elenachenchen/A4000-ATX/ATX4000-BOM.ods

Schematic Part Nr | Type | Parameters |  |  | Manufacturer | Modellnr |  |  | +
R400, R403-R404, R465 | Resistor | 1 | 2512 |  | Vishay Dale | CRCW25121R00JNEG
R176-R177 | Resistor | 20 | 2512 |  | Vishay Dale | CRCW251220R0JNEG
R104, R211, R231-237, R240-R248, R881-899 | Resistor | 33 | 0805 | 5,00 % | Vishay Dale | CRCW080533R0JNEA
R101, R102-R103, R105-R106 R111-R112, R161-R162, R165-R170, R212-R218, R222, R223, R451, R455A-R55H, R456A-R456H, R457A-R457H, R458, R458A, R458B R463-R464, R500-R508, R513, R660-R661, R701-R704, ER175-ER176, ER300-ER307, ER458-ER460 | Resistor | 47 | 0805 | 5,00 % | Vishay Dale | CRCW080547R0JNEA
R520-R543 | Resistor | 68 | 0805 | 5,00 % | Vishay Dale | CRCW080568R0JNEA
R510-512 | Resistor | 75 | 0805 | 5,00 % | Vishay Dale | CRCW080575R0JNEA
R311 | Resistor | 120 | 0805 | 5,00 % | Vishay Dale | CRCW0805120RJNEA
R301, R307 | Resistor | 220 | 0805 | 5,00 % | Vishay Dale | CRCW0805220RJNEA
R120-R122, R175, R178, R601, R603, R651 | Resistor | 470 | 0805 | 5,00 % | Vishay Dale | CRCW0805470RFKEAC
R509 | Resistor | 562 | 0805 | 1,00 % | Vishay Dale | CRCW0805562RFKEA
R65-66 | Resistor | 680 | 0805 | 5,00 % | Vishay Dale | CRCW0805680RJNEA
R430, R440 | Resistor | 750 | 0805 | 5,00 % | Vishay Dale | CRCW0805750RJNEA
R1-R2, R67-R68, R70-R73, R125-R128, R171-R173, R181, R182, R239, R249, R382, R401-R402, R433, R434, R443, R444, R545-R548, R600, R602, R605-R610, R612-R626, R631-R635, R639, R708-R712, R720-R722, R861-R862, R911-R912, R975 | Resistor | 1k | 0805 | 5,00 % | Vishay Dale | CRCW08051K00JNEAC
R79-88 | Resistor | 1.2k | 0805 | 5,00 % | Vishay Dale | CRCW08051K20JNEA
R403D, R403H | Resistor | 2.4k | 0805 | 5,00 % | Panasonic | ERJ-6GEYJ242V
R1-R64, R179, R407, R652, R871, R904-R905 | Resistor | 2.7k | 0805 | 5,00 % | Panasonic | ERJ-6GEYJ272V
R151, R355-R361 | Resistor | 3.3k | 0805 | 5,00 % | Vishay Dale | CRCW08053K30JNEA
R403C, R403G, R515, R981-R994 | Resistor | 4.7k | 0805 | 5,00 % | Vishay Dale | CRCW08054K70FKEAC
R305-306, R403A, R403B, R403E, R403F, R406, R408, R431, R432, R441, R442, R514, R456-R457 | Resistor | 10k | 0805 | 5,00 % | Vishay Dale | CRCW080510K0JNEAC
R902-R903 | Resistor | 11k | 0805 | 5,00 % | Vishay Dale | CRCW080511K0JNEA
R4 | Resistor | 18k | 0805 | 5,00 % | Vishay Dale | CRCW080518K0JNEA
R3 | Resistor | 39k | 0805 | 5,00 % | Vishay Dale | CRCW080539K0JNEA
R180 | Resistor | 100k | 0805 | 5,00 % | Vishay Dale | CRCW0805100KJNEAC
R435, R445 | Resistor | 470k | 0805 | 5,00 % | Vishay Dale | CRCW0805470KJNEA
RP176 | Resistor Network | 10k | x7 | 2,00 % | Bourns Inc. | 4608X-AP1-103LF
RP351, RP752-RP756 | Resistor Network | 1k | x9 | 2,00 % | Bourns Inc. | 4610X-101-102LF
RP461-RP463 | Resistor Network | 1k | x8 | 5,00 % | Bourns Inc. | 4609X-101-102LF
RP602-RP608 | Dual Terminated Resistor Network | 220/330 | x8 | 2,00 % | Bourns Inc. | 4610X-104-221/331L
RP751 | Resistor Network | 4,7k | x9 | 2,00 % | Bourns Inc. | 4610X-101-472LF
C179 | Ceramic Cap | 50V | 22pF | NPO | Vishay Vitramon | VJ0805A220GXACW1BC
C178 | Ceramic Cap | 50V | 56pF | NPO | Yageo | CC0805FRNPO9BN560
EC183-EC185, EC300-EC307, EC410, EC411, EC451-EC452 EC458-EC460, EC971-EC989 | Ceramic Cap | 25V | 100pF | NPO | Vishay Vitramon | VJ0805A101JXACW1BC
C446, C447 | Ceramic Cap | 25V | 330pF | NPO | AVX Corporation | 08053A331JAT2A
C756-C799 | Ceramic Cap | 25V | 1000pF | X7R | Samsung Electro-Mechanics | CL21B102KBANFNC
C432, C442 | Ceramic Cap | 50V | 3900pF | X7R | Samsung Electro-Mechanics | CL21B392KBANNNC
C431, C441 | Ceramic Cap | 50V | 6800pF | X7R | Samsung Electro-Mechanics | CL21B682KBANNNC
C104, C154B, C186, C193, C195, C409, C460D, C460E, C460F | Ceramic Cap | 25V | 0.01uF | X7R | Samsung Electro-Mechanics | CL21B103KAANNNC
C411-414, C430, C440 | Ceramic Cap | 50V | 0.047uF | X7R | AVX Corporation | 0805YC473KAT2A
C1, C2-C3, C102, C103, C106, C130, C140, C141, C145, C152, C154A, C177, C201, C215, C211A, C211B, C211C, C212, C213, C216, C250A, C250C, C300, C305, C311, C350-C355, C400B, C402A-C402B, C455-C459, C455B-C458B, C460A, C460B, C460C, C485, C500, C511, C605-C607, C890-C894, C901-C904, C907, C975-C976, C990, C999 | Ceramic Cap | 25V | 0.1uF | X7R | Samsung Electro-Mechanics | CL21B104KACNNNC
C150, C175-C176, C199, C403, C405-C406 C450, C700-704, C706-C708, C710-C711, C714 | Ceramic Cap | 16V | 0.22uF | X7R | Samsung Electro-Mechanics | CL21B224KOCNNNC
C4 | Ceramic Cap | 25V | 1uF | X7R | Samsung Electro-Mechanics | CL21B105KAFNNNE
C200, C404 | Electrolytic Cap | 25V | 4.7uF | 20,00 % | Nichicon | UWX1E4R7MCL1GB
C560G | Electrolytic Cap | 10V | 10uF | 20,00 % | Nichicon | UWP1A100MCL1GB
C198, C433, C443, C750-C755 | Electrolytic Cap | 16V | 22uF | 20,00 % | Nichicon | UWJ1C220MCL1GB
C187-192, C194, C196 | Electrolytic Cap | 16V | 47uF | 20,00 % | Nichicon | UWJ1C470MCL1GB
C181, C460H | Electrolytic Cap | 10V | 100uF | 20,00 % | Nichicon | UWR1A101MCL1GB
C600-C604 | Electrolytic Cap | 16V | 220uF | 20,00 % | Nichicon | UUR1C221MCL6GS
C185, C400A | Electrolytic Cap | 16V | 470uF | 20,00 % | Nichicon | UUD1C471MNL1GS
VC190 | Trimmer Cap | 50V | 7-50pF |  | Murata Electronics North America | TZB4R500BB10R00
BT176 | Battery Holder | Type | CR2032 |  | MPD (Memory Protection Devices) | BS-7
D175-176, D305-D307, D360-D363, D500-D505 | Diode |  |  |  | Comchip Technology | CGRKM4001-HF
D1-D2, D177-178, D300, D999 | Diode | 100V |  |  | ON Semiconductor | 1N4148WS
D507 | Reference Diode | 1,235V |  |  | Texas Instruments | LM385BDR-1-2
FB177, FB401, FB462, FB975 | Ferrite | 50 Ohm@100Mhz | 1206 | 5A | Vishay Dale | ILHB1206ER500V
FB410, FB411, FB601, FB710, ER971-ER989 | Ferrite | 600 Ohm@ 100MHz | 0805 | 200mA | Vishay Dale | ILBB0805ER601V
U1 | PIC16F628 |  |  |  | Microchip Technology | PIC16F628A-I/P | needs to be programmed!
U2 | Schmitt Inverter | 74HCT1G14 |  |  | Nexperia | 74HCT1G14GW,125
U3 | JK Flip Flop | 74LS73 |  |  | Texas Instruments | SN74LS73ADE4
U102 | Delay Line |  |  |  | Maxim Integrated | DS1100Z-25+
U103 | Buffer | 74FCT244T |  |  | Texas Instruments | CY74FCT244TSOCT
U104 | Oscillator DIP-14 |  |  |  | Abracon LLC | ACO-50.000MHZ-EK
U106, U459 | Flip Flop | 74F74 |  |  | Texas Instruments | SN74F74DR
U130, U710 | AND Gate | 74F08 |  |  | Texas Instruments | SN74F08DR
U140 | OR Gate | 74F32 |  |  | Texas Instruments | SN74F32D
U141 | Buffer | 7407 |  |  | Texas Instruments | SN7407DR
U145 | Comparator 8bit | 74F521NSR |  |  | Texas Instruments | SN74F521DWR
U150 | Fat Gary |  |  |  | Amiga | Fat Gary Custom Chip
U152, U860 | PAL | TIBPAL | 16R4-10 |  | Texas Instruments | TIBPAL16R4-10CFN | needs to be programmed! | only for 68020
U154 | Oscillator DIP-14 | 28.375160Mhz
U175 | A400D Rom Low
U176 | A400D Rom High
U177 | Positive Trigger | 74HCT174 |  |  | Texas Instruments | CD74HCT174M96
U178 | Real Time Clock | RP5C01
U198 | Linear Regulator | 7905 | SMD |  | STMicroelectronics | L7905CD2T-TR
U211 | Alice |  |  |  | Amiga | Alice Custom Chip
U212 | GAL | 22V10-10 |  |  | Microchip Technology | ATF22V10C-10JU | needs to be programmed!
U213 | PAL | 16L8-10 |  |  | Texas Instruments | TIBPAL16L8-10CFN | needs to be programmed!
U215 | Inverter | 74F04 |  |  | Texas Instruments | SN74F04DR
U216 | Latch | 74FCT841 |  |  | Texas Instruments | CY74FCT841CTQCT
U250 | Bridgette |  |  |  | Amiga | Bridgette Custom Chip
U261 | Memory Socket | 72pin |  |  | TE Connectivity AMP Connectors | 5822021-4
U300 | CIA |  |  |  | Amiga | CIA Custom Chip
U304 | Quad Line Driver | RS232 |  |  | Maxim Integrated | MAX1488ECSD+
U305 | Quad Line Receiver | RS232 |  |  | Maxim Integrated | MAX1489ECSD+
U311 | Buffer | 7407 |  |  | Texas Instruments | SN7407DR
U350 | CIA |  |  |  | Amiga | CIA Custom Chip
U351 | Flip Flop | 74LS74A |  |  | Texas Instruments | SN74LS74ADR
U352 | NAND Gate | 74LS38 |  |  | Texas Instruments | SN74LS38DR
U353 | Buffer | 74LS125A |  |  | Texas Instruments | SN74LS125ADR
U354, U174 | Flip Flop | 74HCT174 |  |  | Nexperia | 74HCT174D,652
U355 | Buffer | 74LS125A |  |  | Texas Instruments | SN74LS125ADR
U400 | Paula |  |  |  | Amiga | Paula Custom Chip
U402 | Quad OP-Amp | LF347 |  |  | Texas Instruments | LF347DR
U403 | Audio OP-Amp | LM833 |  |  | STMicroelectronics | LM833DT
U450 | Lisa |  |  |  | Amiga | Lisa Custom Chip
U457 | Transceiver | 74FCT245 |  |  | Texas Instruments | CY74FCT245ATQCT
U460 | Video DAC | ADV7120 |  |  | Analog Devices | ADV7120KPZ30
U600, U602 | Quad OR Gate | 74HCT32 |  |  | Texas Instruments | SN74HCT32DR
U601 | Buffer | 7407 |  |  | Texas Instruments | SN7407DE4
U700 | Fat Buster |  |  |  | Amiga | Fat Buster Custom Chip
U701 | PAL | 16R4-15 |  |  | Texas Instruments | TIBPAL16R4-15CFN | needs to be programmed!
U702, U703, U706 | Transceiver | 74FCT646T |  |  | Texas Instruments | CY74FCT646TSOCT
U704, U707, U708, U891-U894 | Transceiver | 74F245 |  |  | Texas Instruments | SN74F245DW
U711 | Quad XOR | 74F86 |  |  | Texas Instruments | SN74F86D
U714 | PAL | PAL16L8D |  |  | Texas Instruments | TIBPAL16L8-15CFN | needs to be programmed!
U850-U853 | Memory Socket | 72pin |  |  | TE Connectivity AMP Connectors | 5822021-4
U890 | RAMSEY |  |  |  | Amiga | RAMSEY Custom Chip
U901 | PAL | 16L8-15 |  |  | Texas Instruments | TIBPAL16L8-15CFN | needs to be programmed!
U902 | PAL | 16R6-15 |  |  | Texas Instruments | TIBPAL16R6-15CFN | needs to be programmed!
U903, U904 | Transceiver | 74HCT245 |  |  | Nexperia | 74HCT245PW,118
U975, U976 | Shift Register | 74LS166 |  |  | Texas Instruments | SN74LS166ADR
U998 | Quad Multiplexer | 74LS157 |  |  | Texas Instruments | SN74LS157DR
U999 | Quad NAND | 74LS00 |  |  | Texas Instruments | SN74LS00DR
Q300 | 2N3904 |  |  |  | ON Semiconductor | PZT3904 | SMD Variant
Q400 | 2N3906 |  |  |  | ON Semiconductor | PZT3906 | SMD Variant
Q430, Q440 | J113 |  | TO-92 |  | ON Semiconductor | J113
Y176 | Crystal for RTC | 32768Hz |  |  | ECS Inc. | ECS-.327-CDX-1074
JP1 | .1“ (2,54mm) Headers, Single Row |  |  |  | can be bought in bulk and cut in length!!!
JP2 | .1“ (2,54mm) Headers, Single Row
JP3 | .1“ (2,54mm) Headers, Single Row
JP4 | .1“ (2,54mm) Headers, Single Row
JP151 | .1“ (2,54mm) Headers, Single Row
J212 | .1“ (2,54mm) Headers, Single Row
J850 | .1“ (2,54mm) Headers, Single Row
J852 | .1“ (2,54mm) Headers, Single Row
J975 | .1“ (2,54mm) Headers, Dual Row
CN160 | ATX Connector | 24PIN |  |  | TE Connectivity AMP Connectors | 2-1586037-4
CN175 | PS/2 Connector | 6pin |  |  | CUI Inc | MD-60SMK
CN351 | Floppy Connector | 34pin |  |  | .1“ (2,54) 2 Row Header (2x17pin)
CN402 | RCA Left |  |  |  | CUI Inc | RCJ-013
CN403 | RCA Right |  |  |  | CUI Inc | RCJ-012
CN450 | RGB out and serial | 15+9pin |  |  | TE Connectivity AMP Connectors | 1-1775210-1
CN600-CN604 | Zorro Slots | 100pin |  |  | TE Connectivity AMP Connectors | 2-5530843-2
CN621, CN623, CN756-CN760 | Video Slot + ISA Extension | 36pin |  |  | TE Connectivity AMP Connectors | 5530843-3
CN622, CN624 | Video Slot | 56pin |  |  | TE Connectivity AMP Connectors | 5530843-6 | 54 Pin Connectors not available!
CN751-CN755 | ISA 8bit | 62pin |  |  | TE Connectivity AMP Connectors | 7-5530843-0
CN900 | IDE Connector | 40pin |  |  | Wurth Electronics Inc. | 61203921621
CN975 | Mouse + Joystick | 9+9pin |  |  | Conec | DLS1PP5AN23X
CN976 | Port 2 | 9pin |  |  | Conec | DLS1XP5AK40X
L500 | Inductor | 47uH |  |  | Vishay Dale | ISC1210ER470K
F175 | Resettable Fuse | 1.9A |  |  | Bourns Inc. | MF-NSML190-2
++++
