elenachenchen/A4000-ATX/ATX4000.kicad_pcb

## KiCad design ATX4000.kicad_pcb (2021-06-26)

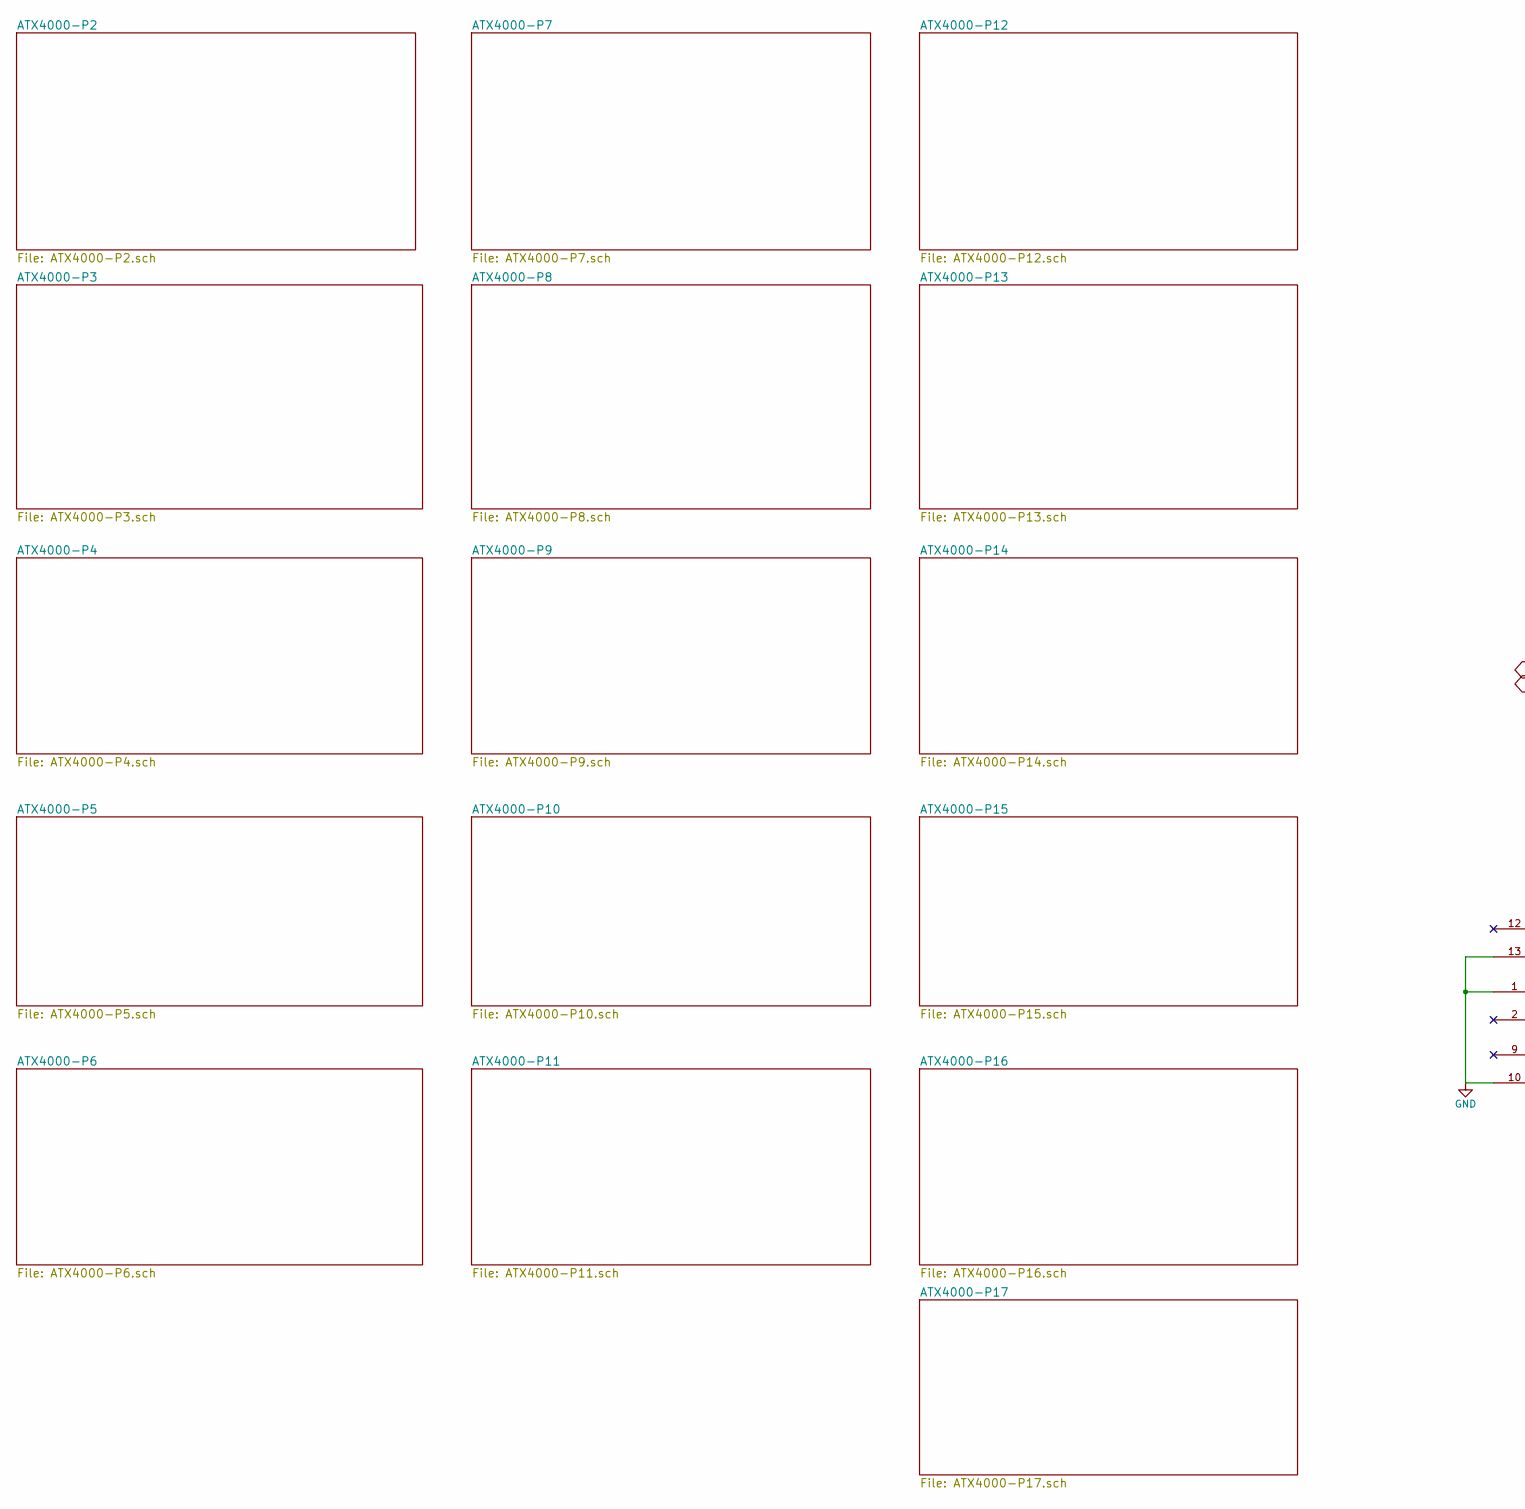
[picture p1: schematic ATX4000.sch, part in row 1, column 1]

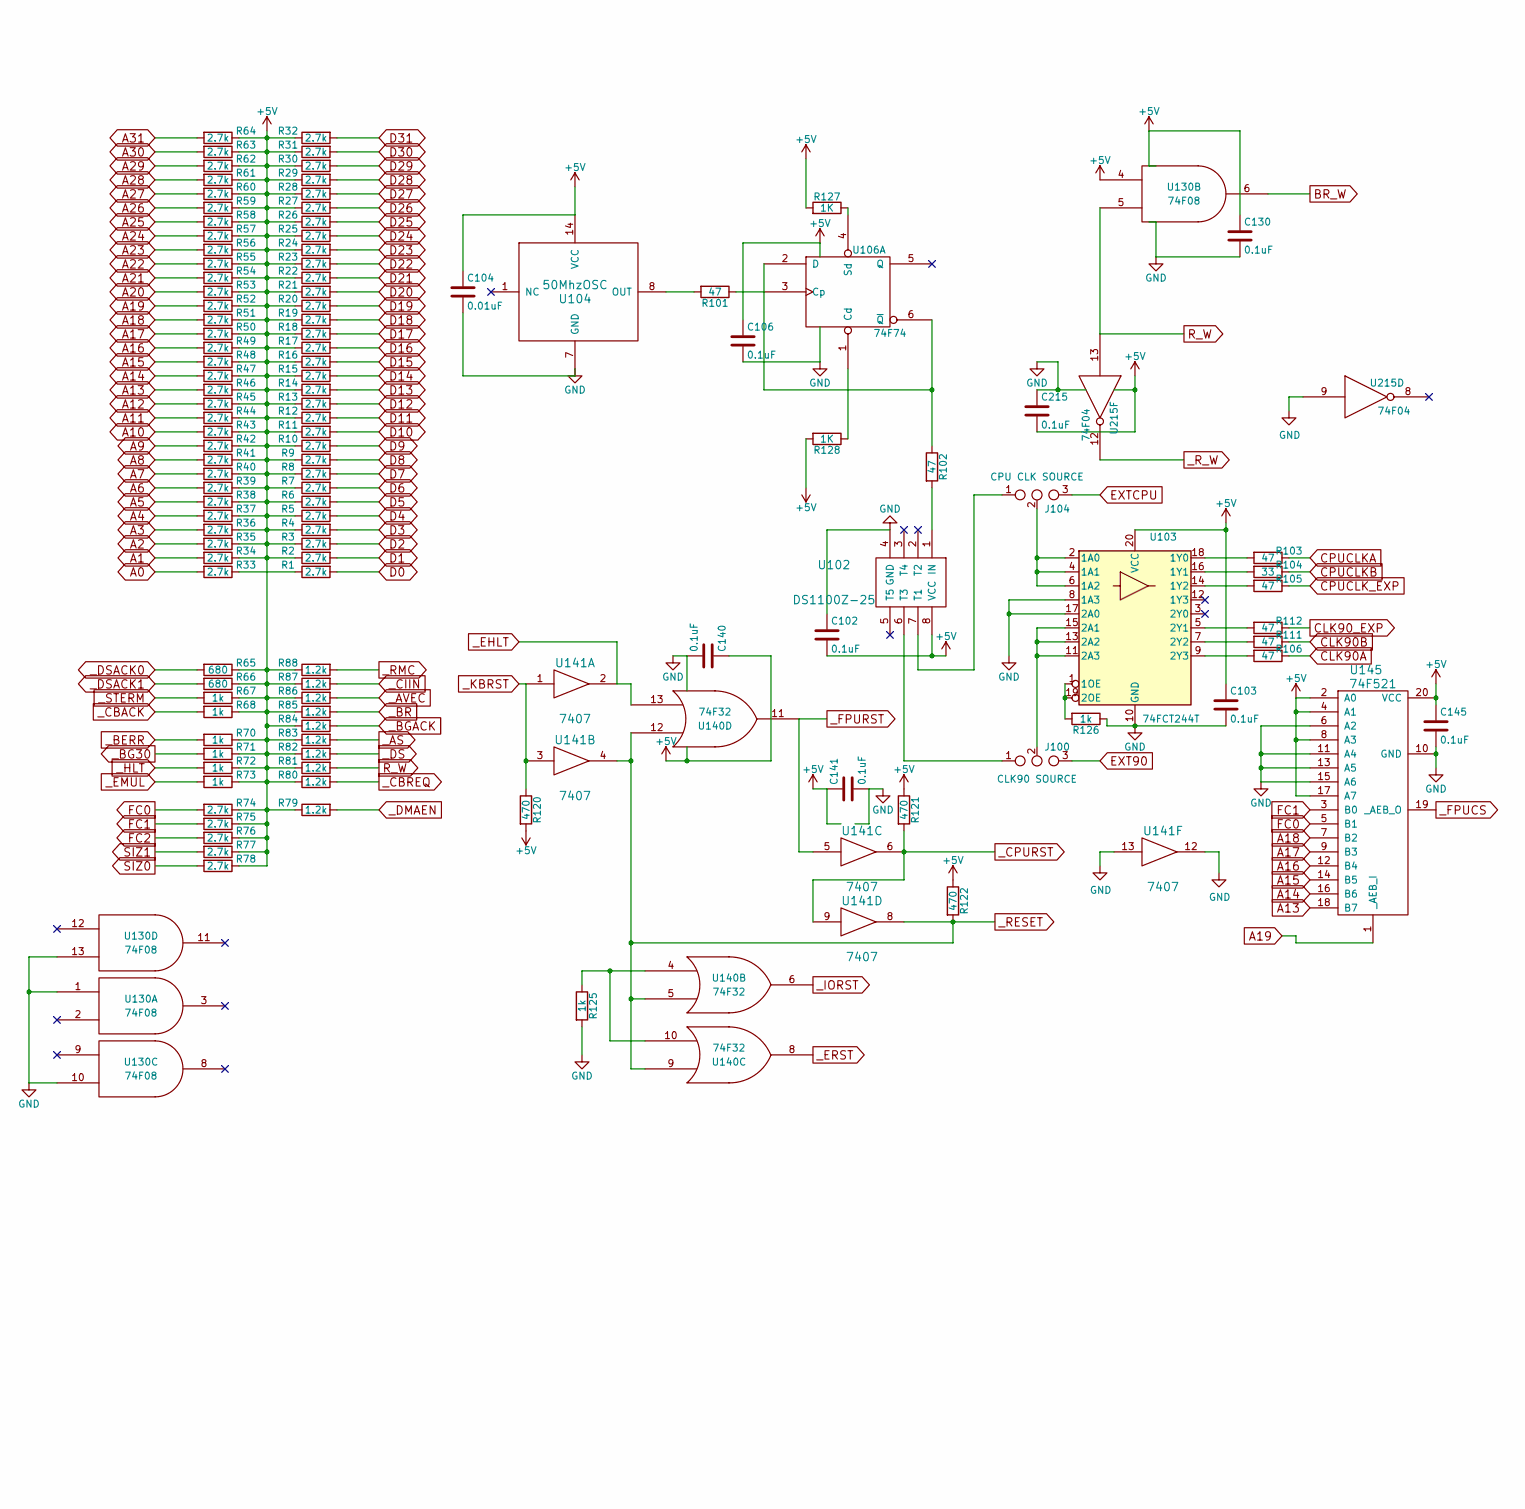
[picture p2: schematic ATX4000.sch, part in row 1, column 2]

Parts:
C102, C103, C106, C130, C140, C141, C145, C215: 0.1uF; C_0805_HandSoldering
C104: 0.01uF; C_0805_HandSoldering
J100: CLK90 SOURCE; Pin_Header_Straight_1x03_Pitch2.54mm
J104: CPU CLK SOURCE; Pin_Header_Straight_1x03_Pitch2.54mm
R1, R2, R3, R4, R5, R6, R7, R8, R9, R10, R11, R12, R13, R14, R15, R16, R17, R18, R19, R20, R21, R22, R23, R24, R25, R26, R27, R28, R29, R30, R31, R32, R33, R34, R35, R36, R37, R38, R39, R40, R41, R42, R43, R44, R45, R46, R47, R48, R49, R50, R51, R52, R53, R54, R55, R56, R57, R58, R59, R60, R61, R62, R63, R64: 2.7k; R_0805_HandSoldering
R65, R66: 680; R_0805_HandSoldering
R67, R68, R70, R71, R72, R73, R125, R126: 1k; R_0805_HandSoldering
R74, R75, R76, R77, R78: 2.7k; R_1206_HandSoldering
R79, R80, R81, R82, R83, R84, R85, R86, R87, R88: 1.2k; R_0805_HandSoldering
R101, R102, R103, R105, R106, R111, R112: 47; R_0805_HandSoldering
R104: 33; R_0805_HandSoldering
R120, R121, R122: 470; R_0805_HandSoldering
R127, R128: 1K; R_0805_HandSoldering
U102: DS1100Z-25; SOIC-8_3.9x4.9mm_Pitch1.27mm
U103: 74FCT244T; SO-20_12.8x7.5mm_Pitch1.27mm
U104: 50MhzOSC; Oscillator_DIP-14
U106: 74F74; SOIC-14_3.9x8.7mm_Pitch1.27mm
U130: 74F08; SOIC-14_3.9x8.7mm_Pitch1.27mm
U140: 74F32; SOIC-14_3.9x8.7mm_Pitch1.27mm
U141: 7407; SOIC-14_3.9x8.7mm_Pitch1.27mm
U145: 74F521; SOIC-20W_7.5x12.8mm_Pitch1.27mm
U215: 74F04

Connections:
+5V: C102.2, C103.1, C104.1, C106.1, C130.1, C140.1, C141.1, C145.1, C215.2, R2.1, R3.1, R4.1, R5.1, R6.1, R7.1, R8.1, R9.1, R10.1, R11.1, R12.1, R13.1, R14.1, R15.1, R16.1, R17.1, R18.1, R19.1, R20.1, R21.1, R22.1, R23.1, R24.1, R25.1, R26.1, R27.1, R28.1, R29.1, R30.1, R31.1, R32.1, R34.1, R35.1, R36.1, R37.1, R38.1, R39.1, R40.1, R41.1, R42.1, R43.1, R44.1, R45.1, R46.1, R47.1, R48.1, R49.1, R50.1, R51.1, R52.1, R53.1, R54.1, R55.1, R56.1, R57.1, R58.1, R59.1, R60.1, R61.1, R62.1, R63.1, R64.1, R65.1, R66.1, R67.1, R68.1, R70.1, R71.1, R72.1, R73.1, R74.1, R75.1, R76.1, R77.1, R78.1, R79.1, R80.1, R81.1, R82.1, R83.1, R84.1, R85.1, R86.1, R87.1, R88.1, R120.2, R121.1, R122.1, R127.2, R128.2, U102.8 (VCC), U103.20 (VCC), U104.14 (VCC), U106.14 (VCC), U130.4, U130.14 (VCC), U140.14 (VCC), U141.14 (VCC), U145.2 (A0), U145.4 (A1), U145.8 (A3), U145.17 (A7), U145.20 (VCC), U215.14 (VCC); also elsewhere on the board
A0: R33.2; also elsewhere on the board
A1: R34.2; also elsewhere on the board
A2: R35.2; also elsewhere on the board
A3: R36.2; also elsewhere on the board
A4: R37.2; also elsewhere on the board
A5: R38.2; also elsewhere on the board
A6: R39.2; also elsewhere on the board
A7: R40.2; also elsewhere on the board
A8: R41.2; also elsewhere on the board
A9: R42.2; also elsewhere on the board
A10: R43.2; also elsewhere on the board
A11: R44.2; also elsewhere on the board
A12: R45.2; also elsewhere on the board
A13: R46.2, U145.18 (B7); also elsewhere on the board
A14: R47.2, U145.16 (B6); also elsewhere on the board
A15: R48.2, U145.14 (B5); also elsewhere on the board
A16: R49.2, U145.12 (B4); also elsewhere on the board
A17: R50.2, U145.9 (B3); also elsewhere on the board
A18: R51.2, U145.7 (B2); also elsewhere on the board
A19: R52.2, U145.1 (_AEB_I); also elsewhere on the board
A20: R53.2; also elsewhere on the board
A21: R54.2; also elsewhere on the board
A22: R55.2; also elsewhere on the board
A23: R56.2; also elsewhere on the board
A24: R57.2; also elsewhere on the board
A25: R58.2; also elsewhere on the board
A26: R59.2; also elsewhere on the board
A27: R60.2; also elsewhere on the board
A28: R61.2; also elsewhere on the board
A29: R62.2; also elsewhere on the board
A30: R63.2; also elsewhere on the board
A31: R64.2; also elsewhere on the board
BR_W: U130.6; also elsewhere on the board
CLK90A: R106.1; also elsewhere on the board
CLK90B: R111.1; also elsewhere on the board
CLK90_EXP: R112.1; also elsewhere on the board
CPUCLKA: R103.1; also elsewhere on the board
CPUCLKB: R104.1; also elsewhere on the board
CPUCLK_EXP: R105.1; also elsewhere on the board
D0: R1.2; also elsewhere on the board
D1: R2.2; also elsewhere on the board
D2: R3.2; also elsewhere on the board
D3: R4.2; also elsewhere on the board
D4: R5.2; also elsewhere on the board
D5: R6.2; also elsewhere on the board
D6: R7.2; also elsewhere on the board
D7: R8.2; also elsewhere on the board
D8: R9.2; also elsewhere on the board
D9: R10.2; also elsewhere on the board
D10: R11.2; also elsewhere on the board
D11: R12.2; also elsewhere on the board
D12: R13.2; also elsewhere on the board
D13: R14.2; also elsewhere on the board
D14: R15.2; also elsewhere on the board
D15: R16.2; also elsewhere on the board
D16: R17.2; also elsewhere on the board
D17: R18.2; also elsewhere on the board
D18: R19.2; also elsewhere on the board
D19: R20.2; also elsewhere on the board
D20: R21.2; also elsewhere on the board
D21: R22.2; also elsewhere on the board
D22: R23.2; also elsewhere on the board
D23: R24.2; also elsewhere on the board
D24: R25.2; also elsewhere on the board
D25: R26.2; also elsewhere on the board
D26: R27.2; also elsewhere on the board
D27: R28.2; also elsewhere on the board
D28: R29.2; also elsewhere on the board
D29: R30.2; also elsewhere on the board
D30: R31.2; also elsewhere on the board
D31: R32.2; also elsewhere on the board
EXT90: J100.3; also elsewhere on the board
EXTCPU: J104.3; also elsewhere on the board
FC0: R74.2, U145.5 (B1); also elsewhere on the board
FC1: R75.2, U145.3 (B0); also elsewhere on the board
FC2: R76.2; also elsewhere on the board
GND: C102.1, C103.2, C104.2, C106.2, C130.2, C140.2, C141.2, C145.2, C215.1, R125.2, R126.1, U102.4 (GND), U103.8 (1A3), U103.10 (GND), U103.17 (2A0), U104.7 (GND), U106.7 (GND), U130.1, U130.7 (GND), U130.10, U130.13, U140.7 (GND), U141.7 (GND), U141.12, U141.13, U145.6 (A2), U145.10 (GND), U145.11 (A4), U145.13 (A5), U145.15 (A6), U215.7 (GND), U215.9; also elsewhere on the board
unnamed: J100.1, U102.6 (T3)
unnamed: J100.2, U103.11 (2A3), U103.13 (2A2), U103.15 (2A1)
unnamed: J104.1, U102.7 (T1)
unnamed: J104.2, U103.2 (1A0), U103.4 (1A1), U103.6 (1A2)
unnamed: R1.1, R33.1
unnamed: R101.1, U106.3 (Cp)
unnamed: R101.2, U104.8 (OUT)
unnamed: R102.1, U106.2 (D), U106.6 (~Q)
unnamed: R102.2, U102.1 (IN)
unnamed: R103.2, U103.18 (1Y0)
unnamed: R104.2, U103.16 (1Y1)
unnamed: R105.2, U103.14 (1Y2)
unnamed: R106.2, U103.9 (2Y3)
unnamed: R111.2, U103.7 (2Y2)
unnamed: R112.2, U103.5 (2Y1)
unnamed: R125.1, U140.4, U140.10
unnamed: R126.2, U103.1 (1OE), U103.19 (2OE)
unnamed: R127.1, U106.4 (Sd)
unnamed: R128.1, U106.1 (Cd)
R_W: R81.2, U130.5, U215.13; also elsewhere on the board
SIZ0: R78.2; also elsewhere on the board
SIZ1: R77.2; also elsewhere on the board
_AS: R83.2; also elsewhere on the board
_AVEC: R86.2; also elsewhere on the board
_BERR: R70.2; also elsewhere on the board
_BG30: R71.2; also elsewhere on the board
_BGACK: R84.2; also elsewhere on the board
_BR: R85.2; also elsewhere on the board
_CBACK: R68.2; also elsewhere on the board
_CBREQ: R80.2; also elsewhere on the board
_CIIN: R87.2; also elsewhere on the board
_CPURST: R121.2, U141.6, U141.9; also elsewhere on the board
_DMAEN: R79.2; also elsewhere on the board
_DS: R82.2; also elsewhere on the board
_DSACK0: R65.2; also elsewhere on the board
_DSACK1: R66.2; also elsewhere on the board
_EHLT: U140.13, U141.2; also elsewhere on the board
_EMUL: R73.2; also elsewhere on the board
_ERST: U140.8; also elsewhere on the board
_FPUCS: U145.19 (_AEB_O); also elsewhere on the board
_FPURST: U140.11, U141.5; also elsewhere on the board
_HLT: R72.2; also elsewhere on the board
_IORST: U140.6; also elsewhere on the board
_KBRST: R120.1, U141.1, U141.3; also elsewhere on the board
_RESET: R122.2, U140.5, U140.9, U140.12, U141.4, U141.8; also elsewhere on the board
_RMC: R88.2; also elsewhere on the board
_R_W: U215.12; also elsewhere on the board
_STERM: R67.2; also elsewhere on the board

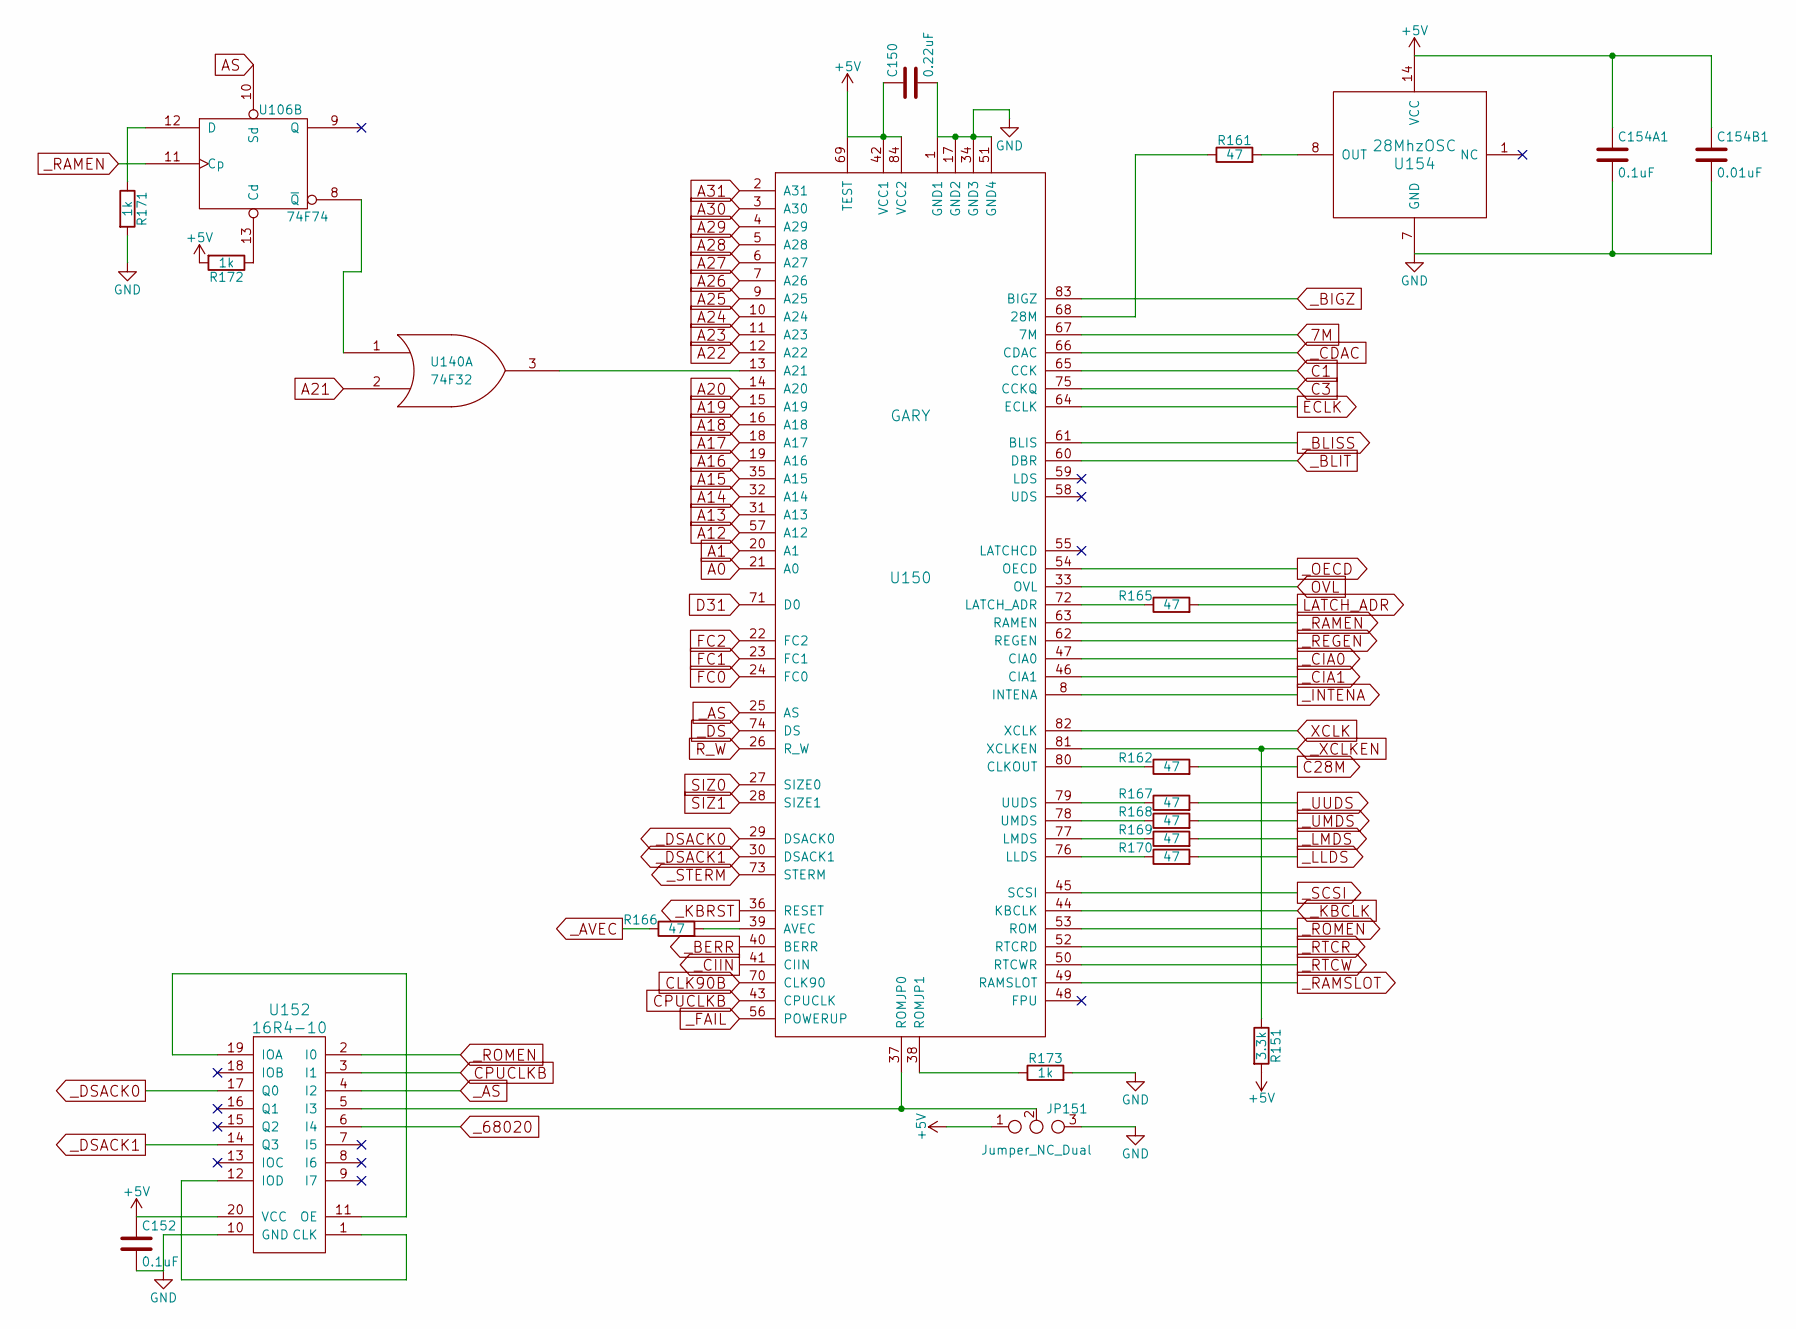
[picture p3: schematic ATX4000-P2.sch]

Parts:
C150: 0.22uF; C_0805_HandSoldering
C152, C154A1: 0.1uF; C_0805_HandSoldering
C154B1: 0.01uF; C_0805_HandSoldering
JP151: Jumper_NC_Dual; Pin_Header_Straight_1x03_Pitch2.54mm
R151: 3.3k; R_0805_HandSoldering
R161, R162, R165, R166, R167, R168, R169, R170: 47; R_0805_HandSoldering
R171, R172, R173: 1k; R_0805_HandSoldering
U106: 74F74
U140: 74F32
U150: GARY; PLCC-84_SMD-Socket
U152: 16R4-10; PLCC-20_SMD-Socket
U154: 28MhzOSC; Oscillator_DIP-14_LargePads

Connections:
7M: U150.67 (7M); also elsewhere on the board
+5V: C150.1, C152.1, C154A1.1, C154B1.1, JP151.1, R151.2, R172.2, U106.14 (VCC), U140.14 (VCC), U150.42 (VCC1), U150.69 (TEST), U150.84 (VCC2), U152.20 (VCC), U154.14 (VCC); also elsewhere on the board
A0: U150.21 (A0); also elsewhere on the board
A1: U150.20 (A1); also elsewhere on the board
A12: U150.57 (A12); also elsewhere on the board
A13: U150.31 (A13); also elsewhere on the board
A14: U150.32 (A14); also elsewhere on the board
A15: U150.35 (A15); also elsewhere on the board
A16: U150.19 (A16); also elsewhere on the board
A17: U150.18 (A17); also elsewhere on the board
A18: U150.16 (A18); also elsewhere on the board
A19: U150.15 (A19); also elsewhere on the board
A20: U150.14 (A20); also elsewhere on the board
A21: U140.2; also elsewhere on the board
A22: U150.12 (A22); also elsewhere on the board
A23: U150.11 (A23); also elsewhere on the board
A24: U150.10 (A24); also elsewhere on the board
A25: U150.9 (A25); also elsewhere on the board
A26: U150.7 (A26); also elsewhere on the board
A27: U150.6 (A27); also elsewhere on the board
A28: U150.5 (A28); also elsewhere on the board
A29: U150.4 (A29); also elsewhere on the board
A30: U150.3 (A30); also elsewhere on the board
A31: U150.2 (A31); also elsewhere on the board
AS: U106.10 (Sd); also elsewhere on the board
C1: U150.65 (CCK); also elsewhere on the board
C3: U150.75 (CCKQ); also elsewhere on the board
C28M: R162.2; also elsewhere on the board
CLK90B: U150.70 (CLK90); also elsewhere on the board
CPUCLKB: U150.43 (CPUCLK), U152.3 (I1); also elsewhere on the board
D31: U150.71 (D0); also elsewhere on the board
ECLK: U150.64 (ECLK); also elsewhere on the board
FC0: U150.24 (FC0); also elsewhere on the board
FC1: U150.23 (FC1); also elsewhere on the board
FC2: U150.22 (FC2); also elsewhere on the board
GND: C150.2, C152.2, C154A1.2, C154B1.2, JP151.3, R171.2, R173.2, U106.7 (GND), U140.7 (GND), U150.1 (GND1), U150.17 (GND2), U150.34 (GND3), U150.51 (GND4), U152.10 (GND), U154.7 (GND); also elsewhere on the board
LATCH_ADR: R165.2; also elsewhere on the board
unnamed: JP151.2, U150.37 (ROMJP0), U152.5 (I3)
unnamed: R161.1, U150.68 (28M)
unnamed: R161.2, U154.8 (OUT)
unnamed: R162.1, U150.80 (CLKOUT)
unnamed: R165.1, U150.72 (LATCH_ADR)
unnamed: R166.2, U150.39 (AVEC)
unnamed: R167.1, U150.79 (UUDS)
unnamed: R168.1, U150.78 (UMDS)
unnamed: R169.1, U150.77 (LMDS)
unnamed: R170.1, U150.76 (LLDS)
unnamed: R171.1, U106.12 (D)
unnamed: R172.1, U106.13 (Cd)
unnamed: R173.1, U150.38 (ROMJP1)
unnamed: U106.8 (~Q), U140.1
unnamed: U140.3, U150.13 (A21)
unnamed: U152.1 (CLK), U152.12 (IOD)
unnamed: U152.11 (OE), U152.19 (IOA)
OVL: U150.33 (OVL); also elsewhere on the board
R_W: U150.26 (R_W); also elsewhere on the board
SIZ0: U150.27 (SIZE0); also elsewhere on the board
SIZ1: U150.28 (SIZE1); also elsewhere on the board
XCLK: U150.82 (XCLK); also elsewhere on the board
_68020: U152.6 (I4); also elsewhere on the board
_AS: U150.25 (AS), U152.4 (I2); also elsewhere on the board
_AVEC: R166.1; also elsewhere on the board
_BERR: U150.40 (BERR); also elsewhere on the board
_BIGZ: U150.83 (BIGZ); also elsewhere on the board
_BLISS: U150.61 (BLIS); also elsewhere on the board
_BLIT: U150.60 (DBR); also elsewhere on the board
_CDAC: U150.66 (CDAC); also elsewhere on the board
_CIA0: U150.47 (CIA0); also elsewhere on the board
_CIA1: U150.46 (CIA1); also elsewhere on the board
_CIIN: U150.41 (CIIN); also elsewhere on the board
_DS: U150.74 (DS); also elsewhere on the board
_DSACK0: U150.29 (DSACK0), U152.17 (Q0); also elsewhere on the board
_DSACK1: U150.30 (DSACK1), U152.14 (Q3); also elsewhere on the board
_FAIL: U150.56 (POWERUP); also elsewhere on the board
_INTENA: U150.8 (INTENA); also elsewhere on the board
_KBCLK: U150.44 (KBCLK); also elsewhere on the board
_KBRST: U150.36 (RESET); also elsewhere on the board
_LLDS: R170.2; also elsewhere on the board
_LMDS: R169.2; also elsewhere on the board
_OECD: U150.54 (OECD); also elsewhere on the board
_RAMEN: U106.11 (Cp), U150.63 (RAMEN); also elsewhere on the board
_RAMSLOT: U150.49 (RAMSLOT); also elsewhere on the board
_REGEN: U150.62 (REGEN); also elsewhere on the board
_ROMEN: U150.53 (ROM), U152.2 (I0); also elsewhere on the board
_RTCR: U150.52 (RTCRD); also elsewhere on the board
_RTCW: U150.50 (RTCWR); also elsewhere on the board
_SCSI: U150.45 (SCSI); also elsewhere on the board
_STERM: U150.73 (STERM); also elsewhere on the board
_UMDS: R168.2; also elsewhere on the board
_UUDS: R167.2; also elsewhere on the board
_XCLKEN: R151.1, U150.81 (XCLKEN); also elsewhere on the board

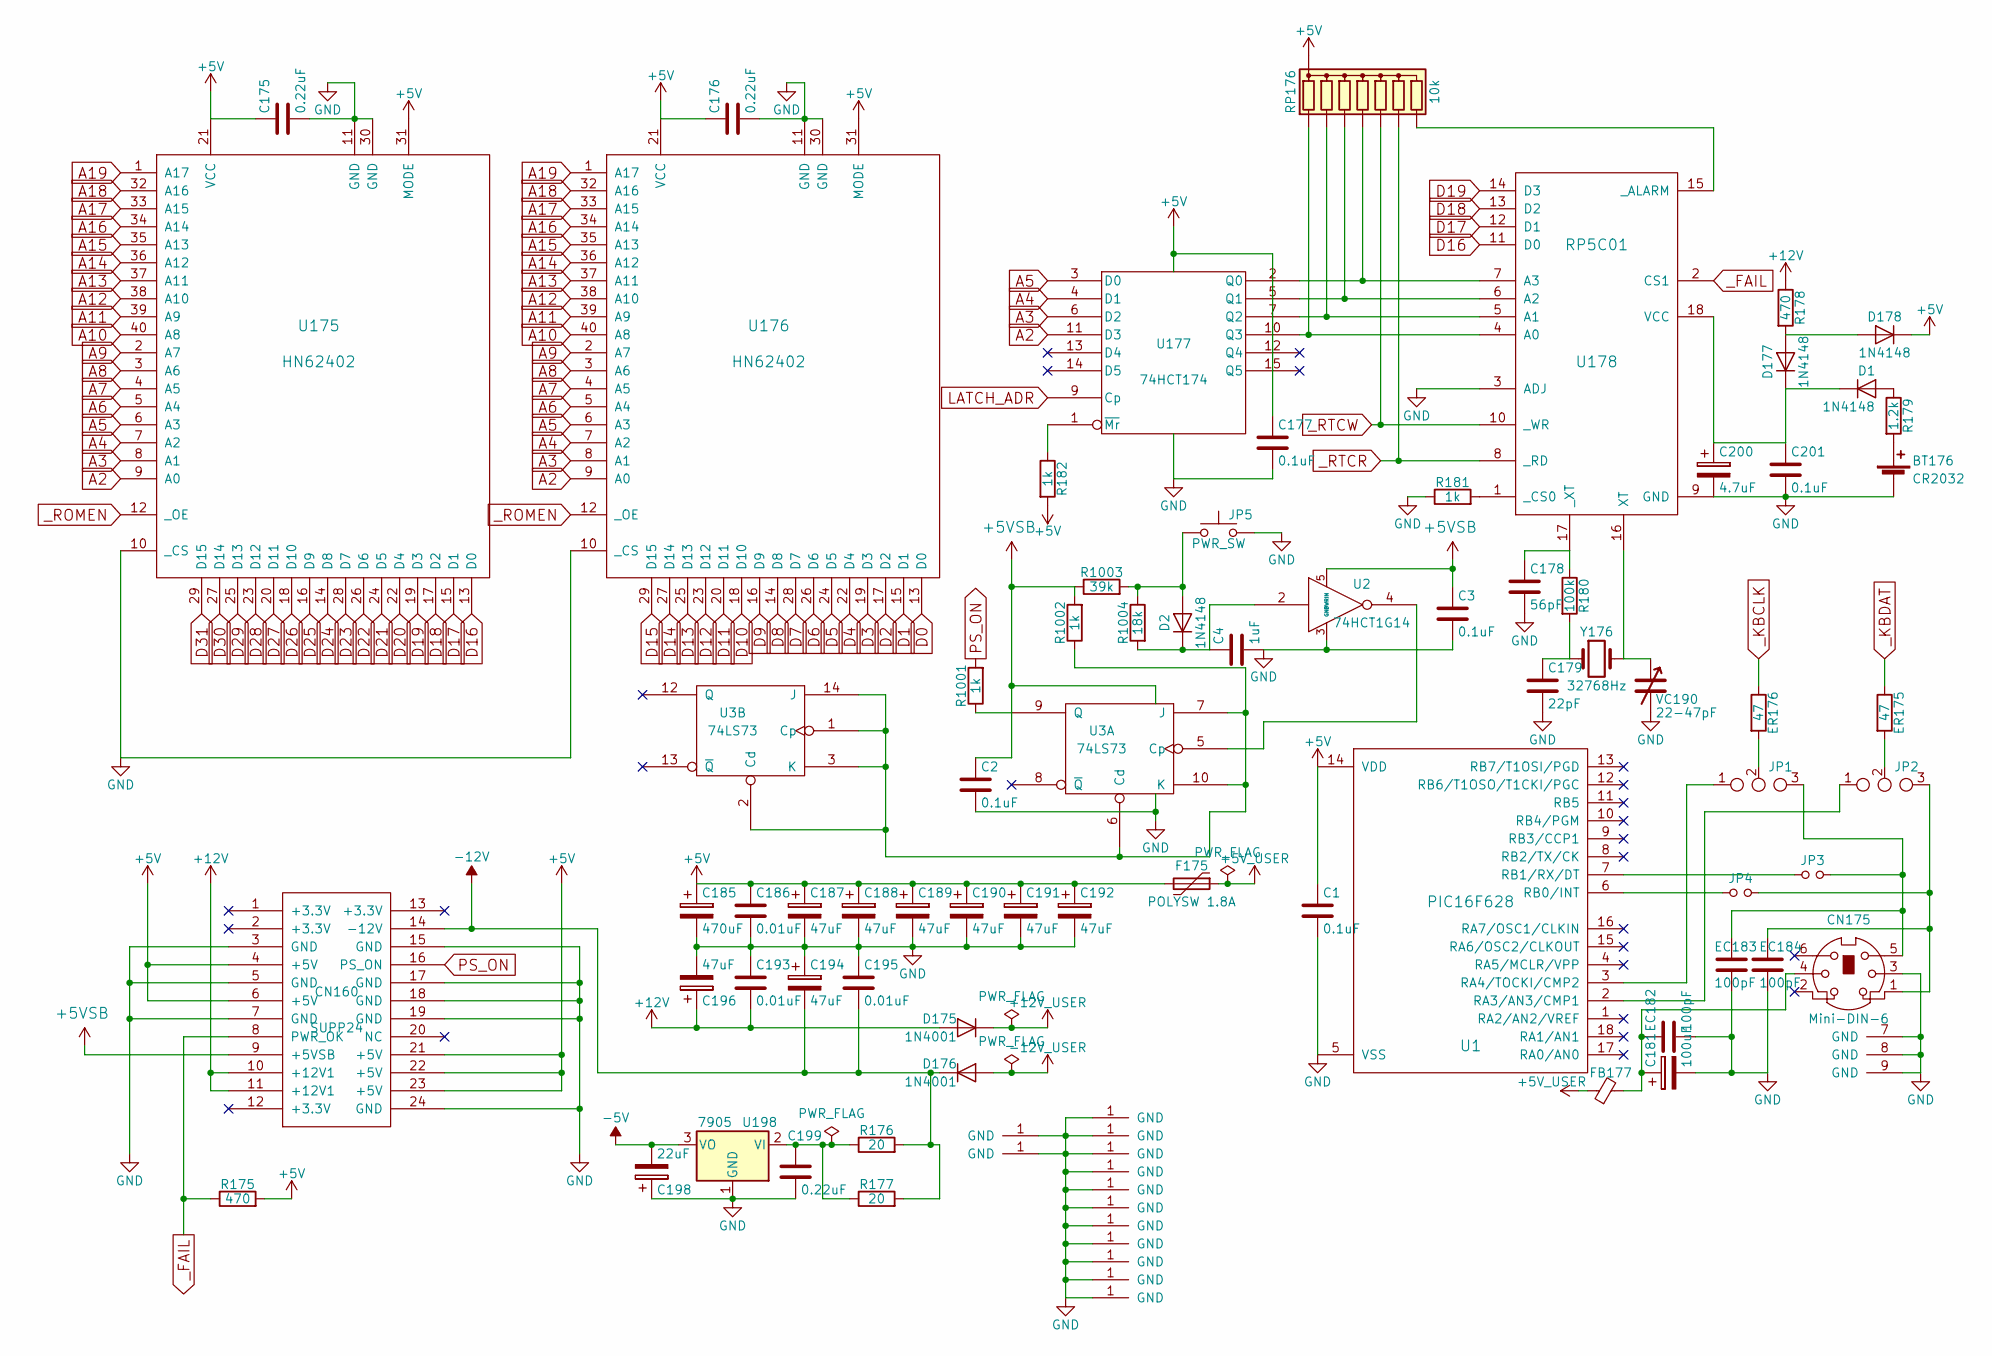
[picture p4: schematic ATX4000-P3.sch]

Parts:
BT176: CR2032; CR2032-Holder
C1, C2, C3, C177, C201: 0.1uF; C_0805_HandSoldering
C4: 1uF; C_0805_HandSoldering
C175, C176, C199: 0.22uF; C_0805_HandSoldering
C178: 56pF; C_0805_HandSoldering
C179: 22pF; C_0805_HandSoldering
C181: 100uF; CP_Elec_5x5.3
C185: 470uF; CP_Elec_8x10
C186, C193, C195: 0.01uF; C_0805_HandSoldering
C187, C188, C189, C190, C191, C192, C194, C196: 47uF; CP_Elec_6.3x5.7
C198: 22uF; CP_Elec_5x5.3
C200: 4.7uF; CP_Elec_4x5.3
CN160: SUPP24; Molex_MiniFit-JR-5556-24A_2x12x4.20mm_Straight
CN175: Mini-DIN-6; 6-MiniDIN
D1, D2, D177, D178: 1N4148; D_SOD-323_HandSoldering
D175, D176: 1N4001; D_SOD-123F
EC182, EC183, EC184: 100pF; C_0805_HandSoldering
ER175, ER176: 47; R_0805_HandSoldering
F175: POLYSW 1.8A; Fuse_SMD1206_HandSoldering
FB177: Ferrite_Bead_Small; L_1206_HandSoldering
JP1, JP2: Jumper_NC_Dual; Pin_Header_Straight_1x03_Pitch2.54mm
JP3, JP4: Jumper_NO_Small; Pin_Header_Straight_1x02_Pitch2.54mm
JP5: PWR_SW; Pin_Header_Straight_1x02_Pitch2.54mm
MT1, MT2, MT3, MT4, MT5, MT6, MT7, MT8, MT9, MT10, MT11, MT12, MT13: Mounting; MountingScrewhole
R175, R178: 470; R_0805_HandSoldering
R176, R177: 20; R_2512_HandSoldering
R179: 1.2k; R_0805_HandSoldering
R180: 100k; R_0805_HandSoldering
R181, R182, R1001, R1002: 1k; R_0805_HandSoldering
R1003: 39k; R_0805_HandSoldering
R1004: 18k; R_0805_HandSoldering
RP176: 10k; R_Array_SIP8
U1: PIC16F628; DIP-18_W7.62mm_Socket
U2: 74HCT1G14; SOT-353_SC-70-5_Handsoldering
U3: 74LS73; SOIC-14_3.9x8.7mm_Pitch1.27mm
U175, U176: HN62402; DIP-40_W15.24mm_Socket
U177: 74HCT174; SOIC-16_3.9x9.9mm_Pitch1.27mm
U178: RP5C01; DIP-18_W7.62mm_Socket
U198: 7905; TO-263-2
VC190: 22-47pF; VC190
Y176: 32768Hz; R_0805_HandSoldering

Connections:
+5V: C1.1, C175.1, C176.1, C177.1, C185.1, C186.1, C187.1, C188.1, C189.1, C190.1, C191.1, C192.1, CN160.4 (+5V), CN160.6 (+5V), CN160.21 (+5V), CN160.22 (+5V), CN160.23 (+5V), D178.1 (K), F175.2, R175.2, R182.2, RP176.1 (common), U1.14 (VDD), U175.21 (VCC), U175.31 (MODE), U176.21 (VCC), U176.31 (MODE), U177.16 (VCC); also elsewhere on the board
+5VSB: C2.1, C3.1, CN160.9 (+5VSB), R1002.2, R1003.1, U2.5 (PWRIN), U3.4 (PWRIN)
+5V_USER: F175.1, FB177.1; also elsewhere on the board
+12V: C193.2, C196.1, CN160.10 (+12V1), CN160.11 (+12V1), D175.2 (A), R178.1; also elsewhere on the board
+12V_USER: D175.1 (K); also elsewhere on the board
-5V: C198.2, U198.3 (VO); also elsewhere on the board
-12V: C194.2, C195.2, CN160.14 (-12V), D176.1 (K), R176.2, R177.2; also elsewhere on the board
-12V_USER: D176.2 (A); also elsewhere on the board
A2: U175.9 (A0), U176.9 (A0), U177.11 (D3); also elsewhere on the board
A3: U175.8 (A1), U176.8 (A1), U177.6 (D2); also elsewhere on the board
A4: U175.7 (A2), U176.7 (A2), U177.4 (D1); also elsewhere on the board
A5: U175.6 (A3), U176.6 (A3), U177.3 (D0); also elsewhere on the board
A6: U175.5 (A4), U176.5 (A4); also elsewhere on the board
A7: U175.4 (A5), U176.4 (A5); also elsewhere on the board
A8: U175.3 (A6), U176.3 (A6); also elsewhere on the board
A9: U175.2 (A7), U176.2 (A7); also elsewhere on the board
A10: U175.40 (A8), U176.40 (A8); also elsewhere on the board
A11: U175.39 (A9), U176.39 (A9); also elsewhere on the board
A12: U175.38 (A10), U176.38 (A10); also elsewhere on the board
A13: U175.37 (A11), U176.37 (A11); also elsewhere on the board
A14: U175.36 (A12), U176.36 (A12); also elsewhere on the board
A15: U175.35 (A13), U176.35 (A13); also elsewhere on the board
A16: U175.34 (A14), U176.34 (A14); also elsewhere on the board
A17: U175.33 (A15), U176.33 (A15); also elsewhere on the board
A18: U175.32 (A16), U176.32 (A16); also elsewhere on the board
A19: U175.1 (A17), U176.1 (A17); also elsewhere on the board
D0: U176.13 (D0); also elsewhere on the board
D1: U176.15 (D1); also elsewhere on the board
D2: U176.17 (D2); also elsewhere on the board
D3: U176.19 (D3); also elsewhere on the board
D4: U176.22 (D4); also elsewhere on the board
D5: U176.24 (D5); also elsewhere on the board
D6: U176.26 (D6); also elsewhere on the board
D7: U176.28 (D7); also elsewhere on the board
D8: U176.14 (D8); also elsewhere on the board
D9: U176.16 (D9); also elsewhere on the board
D10: U176.18 (D10); also elsewhere on the board
D11: U176.20 (D11); also elsewhere on the board
D12: U176.23 (D12); also elsewhere on the board
D13: U176.25 (D13); also elsewhere on the board
D14: U176.27 (D14); also elsewhere on the board
D15: U176.29 (D15); also elsewhere on the board
D16: U175.13 (D0), U178.11 (D0); also elsewhere on the board
D17: U175.15 (D1), U178.12 (D1); also elsewhere on the board
D18: U175.17 (D2), U178.13 (D2); also elsewhere on the board
D19: U175.19 (D3), U178.14 (D3); also elsewhere on the board
D20: U175.22 (D4); also elsewhere on the board
D21: U175.24 (D5); also elsewhere on the board
D22: U175.26 (D6); also elsewhere on the board
D23: U175.28 (D7); also elsewhere on the board
D24: U175.14 (D8); also elsewhere on the board
D25: U175.16 (D9); also elsewhere on the board
D26: U175.18 (D10); also elsewhere on the board
D27: U175.20 (D11); also elsewhere on the board
D28: U175.23 (D12); also elsewhere on the board
D29: U175.25 (D13); also elsewhere on the board
D30: U175.27 (D14); also elsewhere on the board
D31: U175.29 (D15); also elsewhere on the board
GND: BT176.2 (-), C1.2, C2.2, C3.2, C4.2, C175.2, C176.2, C177.2, C178.2, C179.2, C181.2, C185.2, C186.2, C187.2, C188.2, C189.2, C190.2, C191.2, C192.2, C193.1, C194.1, C195.1, C196.2, C198.1, C199.2, C200.2, C201.2, CN160.3 (GND), CN160.5 (GND), CN160.7 (GND), CN160.15 (GND), CN160.17 (GND), CN160.18 (GND), CN160.19 (GND), CN160.24 (GND), CN175.3, CN175.7 (GND), CN175.8 (GND), CN175.9 (GND), EC182.2, EC183.2, EC184.2, JP5.2, MT1.1, MT2.1, MT3.1, MT4.1, MT5.1, MT6.1, MT7.1, MT8.1, MT9.1, MT10.1, MT11.1, MT12.1, MT13.1, R181.1, U1.5 (VSS), U2.3 (GND), U3.11 (GND), U175.10 (_CS), U175.11 (GND), U175.30 (GND), U176.10 (_CS), U176.11 (GND), U176.30 (GND), U177.8 (GND), U178.3 (ADJ), U178.9 (GND), U198.1 (GND), VC190.2; also elsewhere on the board
LATCH_ADR: U177.9 (Cp); also elsewhere on the board
unnamed: BT176.1 (+), R179.2
unnamed: C4.1, D2.1 (K), R1004.2, U2.2
unnamed: C178.1, R180.1, U178.17 (_XT)
unnamed: C179.1, R180.2, Y176.1
unnamed: C181.1, CN175.4, EC182.1, FB177.2
unnamed: C199.1, R176.1, R177.1, U198.2 (VI)
unnamed: C200.1, C201.1, D1.1 (K), D177.1 (K), U178.18 (VCC)
unnamed: CN175.1, EC184.1, JP2.3, JP4.2
unnamed: CN175.5, EC183.1, JP1.3, JP3.2
unnamed: D1.2 (A), R179.1
unnamed: D2.2 (A), JP5.1, R1003.2, R1004.1
unnamed: D177.2 (A), D178.2 (A), R178.2
unnamed: ER175.2, JP2.2
unnamed: ER176.2, JP1.2
unnamed: JP1.1, U1.3 (RA4/TOCKI/CMP2)
unnamed: JP2.1, U1.2 (RA3/AN3/CMP1)
unnamed: JP3.1, U1.7 (RB1/RX/DT)
unnamed: JP4.1, U1.6 (RB0/INT)
unnamed: R181.2, U178.1 (_CS0)
unnamed: R182.1, U177.1 (~Mr)
unnamed: R1001.1, U3.9 (Q)
unnamed: R1002.1, U3.1 (Cp), U3.2 (Cd), U3.3 (K), U3.6 (Cd), U3.7 (J), U3.10 (K), U3.14 (J)
unnamed: RP176.2 (R1), U177.10 (Q3), U178.4 (A0)
unnamed: RP176.3 (R2), U177.7 (Q2), U178.5 (A1)
unnamed: RP176.4 (R3), U177.5 (Q1), U178.6 (A2)
unnamed: RP176.5 (R4), U177.2 (Q0), U178.7 (A3)
unnamed: RP176.8 (R7), U178.15 (_ALARM)
unnamed: U2.4, U3.5 (Cp)
unnamed: U178.16 (XT), VC190.1, Y176.2
PS_ON: CN160.16 (PS_ON), R1001.2
_FAIL: CN160.8 (PWR_OK), R175.1, U178.2 (CS1); also elsewhere on the board
_KBCLK: ER176.1; also elsewhere on the board
_KBDAT: ER175.1; also elsewhere on the board
_ROMEN: U175.12 (_OE), U176.12 (_OE); also elsewhere on the board
_RTCR: RP176.7 (R6), U178.8 (_RD); also elsewhere on the board
_RTCW: RP176.6 (R5), U178.10 (_WR); also elsewhere on the board
