elenachenchen/A4000-ATX/ATX4000.kicad_pcb

## KiCad design ATX4000.kicad_pcb (continued)

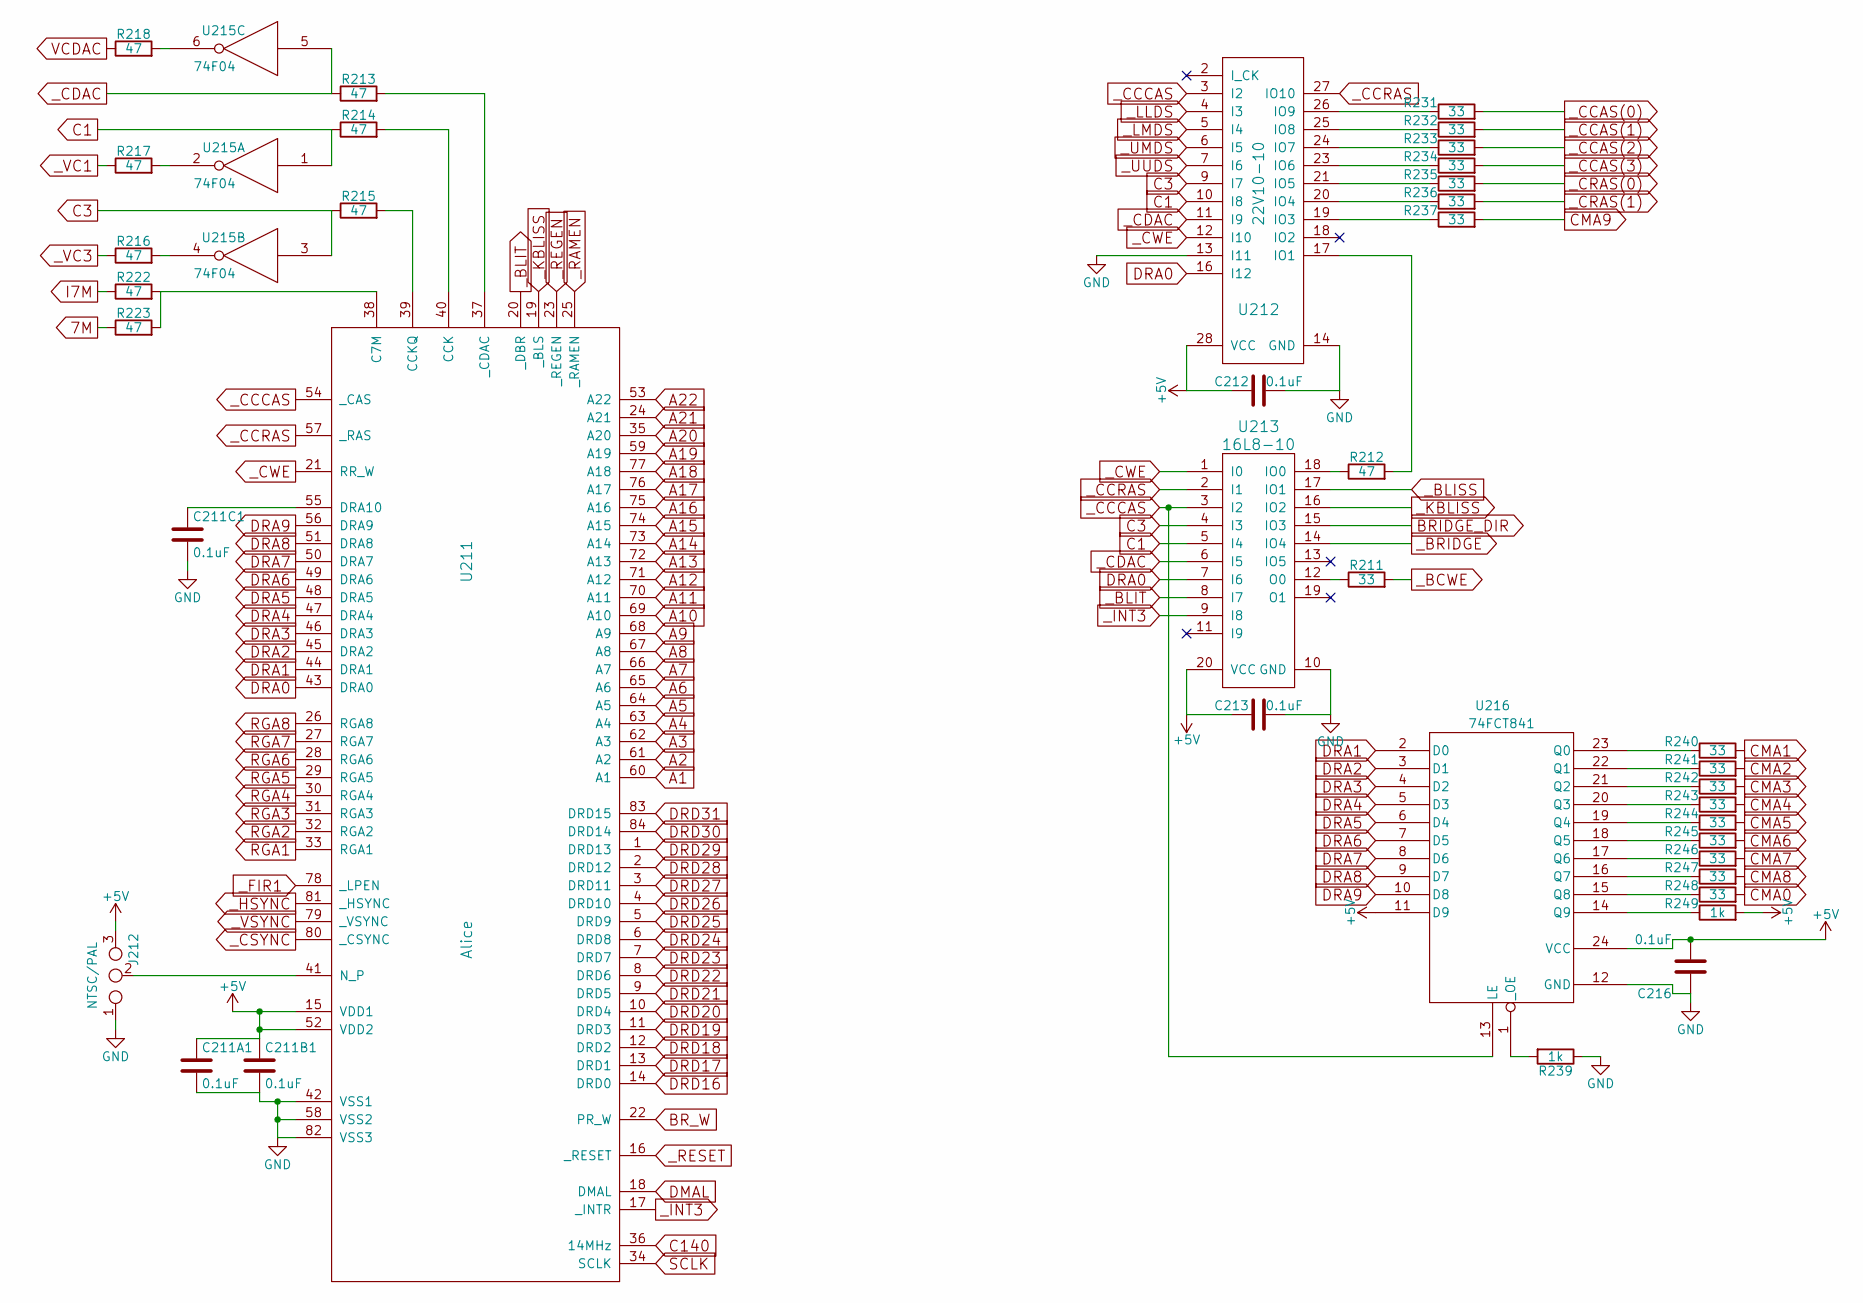
[picture p5: schematic ATX4000-P4.sch]

Parts:
C211A1, C211B1, C211C1, C212, C213, C216: 0.1uF; C_0805_HandSoldering
J212: NTSC/PAL; Pin_Header_Straight_1x03_Pitch2.54mm
R211, R231, R232, R233, R234, R235, R236, R237, R240, R241, R242, R243, R244, R245, R246, R247, R248: 33; R_0805_HandSoldering
R212, R213, R214, R215, R216, R217, R218, R222, R223: 47; R_0805_HandSoldering
R239, R249: 1k; R_0805_HandSoldering
U211: Alice; PLCC-84_SMD-Socket
U212: 22V10-10; PLCC-28_SMD-Socket
U213: 16L8-10; PLCC-20_SMD-Socket
U215: 74F04; SOIC-14_3.9x8.7mm_Pitch1.27mm
U216: 74FCT841; SSOP-24_3.9x8.7mm_Pitch0.635mm

Connections:
7M: R223.1; also elsewhere on the board
+5V: C211A1.1, C211B1.1, C212.1, C213.1, C216.2, J212.3, R249.2, U211.15 (VDD1), U211.52 (VDD2), U212.28 (VCC), U213.20 (VCC), U215.14 (VCC), U216.11 (D9), U216.24 (VCC); also elsewhere on the board
A1: U211.60 (A1); also elsewhere on the board
A2: U211.61 (A2); also elsewhere on the board
A3: U211.62 (A3); also elsewhere on the board
A4: U211.63 (A4); also elsewhere on the board
A5: U211.64 (A5); also elsewhere on the board
A6: U211.65 (A6); also elsewhere on the board
A7: U211.66 (A7); also elsewhere on the board
A8: U211.67 (A8); also elsewhere on the board
A9: U211.68 (A9); also elsewhere on the board
A10: U211.69 (A10); also elsewhere on the board
A11: U211.70 (A11); also elsewhere on the board
A12: U211.71 (A12); also elsewhere on the board
A13: U211.72 (A13); also elsewhere on the board
A14: U211.73 (A14); also elsewhere on the board
A15: U211.74 (A15); also elsewhere on the board
A16: U211.75 (A16); also elsewhere on the board
A17: U211.76 (A17); also elsewhere on the board
A18: U211.77 (A18); also elsewhere on the board
A19: U211.59 (A19); also elsewhere on the board
A20: U211.35 (A20); also elsewhere on the board
A21: U211.24 (A21); also elsewhere on the board
A22: U211.53 (A22); also elsewhere on the board
BRIDGE_DIR: U213.15 (IO3); also elsewhere on the board
BR_W: U211.22 (PR_W); also elsewhere on the board
C1: R214.1, U212.10 (I8), U213.5 (I4), U215.1; also elsewhere on the board
C3: R215.1, U212.9 (I7), U213.4 (I3), U215.3; also elsewhere on the board
C140: U211.36 (14MHz); also elsewhere on the board
CMA0: R248.2; also elsewhere on the board
CMA1: R240.2; also elsewhere on the board
CMA2: R241.2; also elsewhere on the board
CMA3: R242.2; also elsewhere on the board
CMA4: R243.2; also elsewhere on the board
CMA5: R244.2; also elsewhere on the board
CMA6: R245.2; also elsewhere on the board
CMA7: R246.2; also elsewhere on the board
CMA8: R247.2; also elsewhere on the board
CMA9: R237.2; also elsewhere on the board
DMAL: U211.18 (DMAL); also elsewhere on the board
DRA0: U211.43 (DRA0), U212.16 (I12), U213.7 (I6)
DRA1: U211.44 (DRA1), U216.2 (D0)
DRA2: U211.45 (DRA2), U216.3 (D1)
DRA3: U211.46 (DRA3), U216.4 (D2)
DRA4: U211.47 (DRA4), U216.5 (D3)
DRA5: U211.48 (DRA5), U216.6 (D4)
DRA6: U211.49 (DRA6), U216.7 (D5)
DRA7: U211.50 (DRA7), U216.8 (D6)
DRA8: U211.51 (DRA8), U216.9 (D7)
DRA9: U211.56 (DRA9), U216.10 (D8)
DRD16: U211.14 (DRD0); also elsewhere on the board
DRD17: U211.13 (DRD1); also elsewhere on the board
DRD18: U211.12 (DRD2); also elsewhere on the board
DRD19: U211.11 (DRD3); also elsewhere on the board
DRD20: U211.10 (DRD4); also elsewhere on the board
DRD21: U211.9 (DRD5); also elsewhere on the board
DRD22: U211.8 (DRD6); also elsewhere on the board
DRD23: U211.7 (DRD7); also elsewhere on the board
DRD24: U211.6 (DRD8); also elsewhere on the board
DRD25: U211.5 (DRD9); also elsewhere on the board
DRD26: U211.4 (DRD10); also elsewhere on the board
DRD27: U211.3 (DRD11); also elsewhere on the board
DRD28: U211.2 (DRD12); also elsewhere on the board
DRD29: U211.1 (DRD13); also elsewhere on the board
DRD30: U211.84 (DRD14); also elsewhere on the board
DRD31: U211.83 (DRD15); also elsewhere on the board
GND: C211A1.2, C211B1.2, C211C1.2, C212.2, C213.2, C216.1, J212.1, R239.1, U211.42 (VSS1), U211.58 (VSS2), U211.82 (VSS3), U212.13 (I11), U212.14 (GND), U213.10 (GND), U215.7 (GND), U216.12 (GND); also elsewhere on the board
I7M: R222.1; also elsewhere on the board
unnamed: C211C1.1, U211.55 (DRA10)
unnamed: J212.2, U211.41 (N_P)
unnamed: R211.1, U213.12 (O0)
unnamed: R212.1, U213.18 (IO0)
unnamed: R212.2, U212.17 (IO1)
unnamed: R213.2, U211.37 (_CDAC)
unnamed: R214.2, U211.40 (CCK)
unnamed: R215.2, U211.39 (CCKQ)
unnamed: R216.2, U215.4
unnamed: R217.2, U215.2
unnamed: R218.2, U215.6
unnamed: R222.2, R223.2, U211.38 (C7M)
unnamed: R231.1, U212.26 (IO9)
unnamed: R232.1, U212.25 (IO8)
unnamed: R233.1, U212.24 (IO7)
unnamed: R234.1, U212.23 (IO6)
unnamed: R235.1, U212.21 (IO5)
unnamed: R236.1, U212.20 (IO4)
unnamed: R237.1, U212.19 (IO3)
unnamed: R239.2, U216.1 (_OE)
unnamed: R240.1, U216.23 (Q0)
unnamed: R241.1, U216.22 (Q1)
unnamed: R242.1, U216.21 (Q2)
unnamed: R243.1, U216.20 (Q3)
unnamed: R244.1, U216.19 (Q4)
unnamed: R245.1, U216.18 (Q5)
unnamed: R246.1, U216.17 (Q6)
unnamed: R247.1, U216.16 (Q7)
unnamed: R248.1, U216.15 (Q8)
unnamed: R249.1, U216.14 (Q9)
RGA1: U211.33 (RGA1); also elsewhere on the board
RGA2: U211.32 (RGA2); also elsewhere on the board
RGA3: U211.31 (RGA3); also elsewhere on the board
RGA4: U211.30 (RGA4); also elsewhere on the board
RGA5: U211.29 (RGA5); also elsewhere on the board
RGA6: U211.28 (RGA6); also elsewhere on the board
RGA7: U211.27 (RGA7); also elsewhere on the board
RGA8: U211.26 (RGA8); also elsewhere on the board
SCLK: U211.34 (SCLK); also elsewhere on the board
VCDAC: R218.1; also elsewhere on the board
_BCWE: R211.2; also elsewhere on the board
_BLISS: U213.17 (IO1); also elsewhere on the board
_BLIT: U211.20 (_DBR), U213.8 (I7); also elsewhere on the board
_BRIDGE: U213.14 (IO4); also elsewhere on the board
_CCAS(0): R231.2; also elsewhere on the board
_CCAS(1): R232.2; also elsewhere on the board
_CCAS(2): R233.2; also elsewhere on the board
_CCAS(3): R234.2; also elsewhere on the board
_CCCAS: U211.54 (_CAS), U212.3 (I2), U213.3 (I2), U216.13 (LE); also elsewhere on the board
_CCRAS: U211.57 (_RAS), U212.27 (IO10), U213.2 (I1)
_CDAC: R213.1, U212.11 (I9), U213.6 (I5), U215.5; also elsewhere on the board
_CRAS(0): R235.2; also elsewhere on the board
_CRAS(1): R236.2; also elsewhere on the board
_CSYNC: U211.80 (_CSYNC); also elsewhere on the board
_CWE: U211.21 (RR_W), U212.12 (I10), U213.1 (I0)
_FIR1: U211.78 (_LPEN); also elsewhere on the board
_HSYNC: U211.81 (_HSYNC); also elsewhere on the board
_INT3: U211.17 (_INTR), U213.9 (I8); also elsewhere on the board
_KBLISS: U211.19 (_BLS), U213.16 (IO2)
_LLDS: U212.4 (I3); also elsewhere on the board
_LMDS: U212.5 (I4); also elsewhere on the board
_RAMEN: U211.25 (_RAMEN); also elsewhere on the board
_REGEN: U211.23 (_REGEN); also elsewhere on the board
_RESET: U211.16 (_RESET); also elsewhere on the board
_UMDS: U212.6 (I5); also elsewhere on the board
_UUDS: U212.7 (I6); also elsewhere on the board
_VC1: R217.1; also elsewhere on the board
_VC3: R216.1; also elsewhere on the board
_VSYNC: U211.79 (_VSYNC); also elsewhere on the board

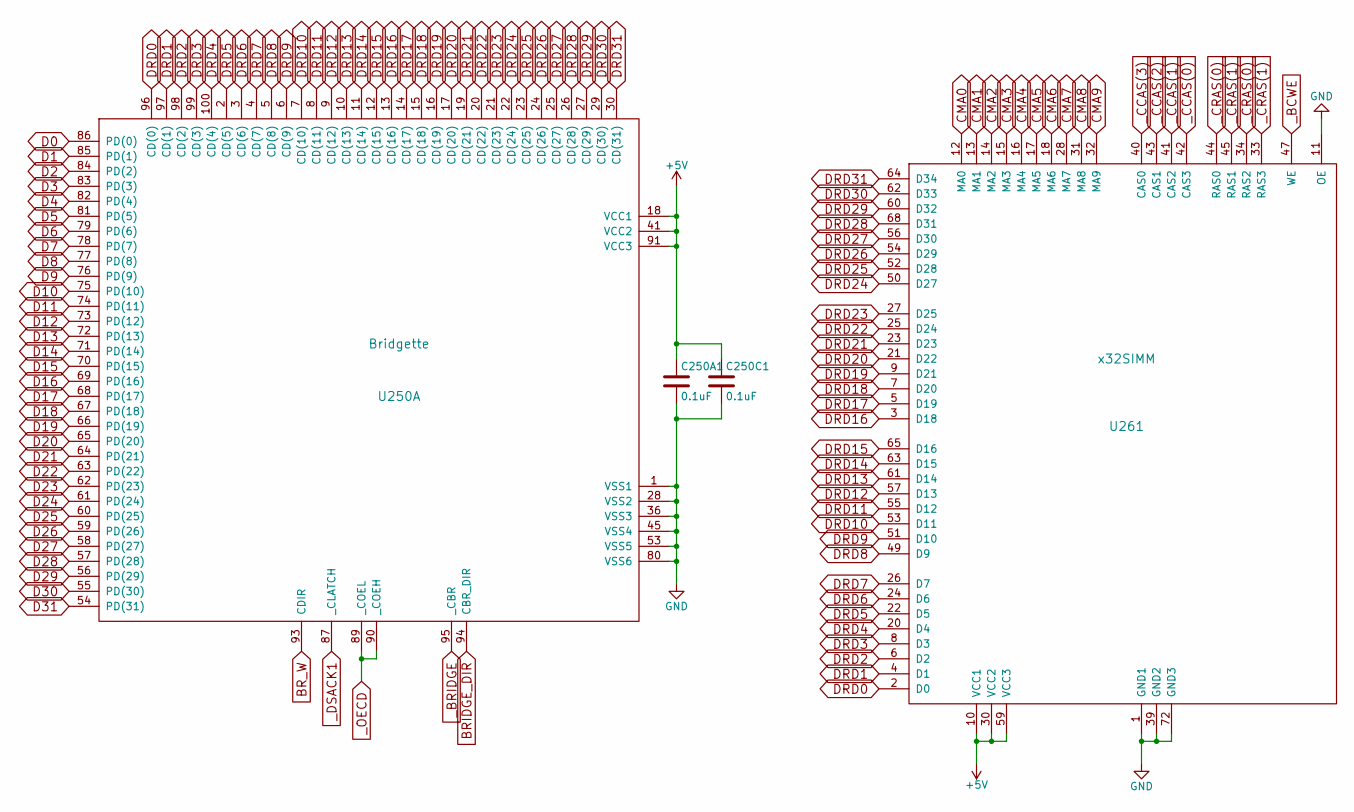
[picture p6: schematic ATX4000-P5.sch]

Parts:
C250A1, C250C1: 0.1uF; C_0805_HandSoldering
U250: Bridgette; PQFP-100_14x20mm_Pitch0.65mm
U261: x32SIMM; SIMM

Connections:
+5V: C250A1.1, C250C1.1, U250.18 (VCC1), U250.41 (VCC2), U250.91 (VCC3), U261.10 (VCC1), U261.30 (VCC2), U261.59 (VCC3); also elsewhere on the board
BRIDGE_DIR: U250.94 (CBR_DIR); also elsewhere on the board
BR_W: U250.93 (CDIR); also elsewhere on the board
CMA0: U261.12 (MA0); also elsewhere on the board
CMA1: U261.13 (MA1); also elsewhere on the board
CMA2: U261.14 (MA2); also elsewhere on the board
CMA3: U261.15 (MA3); also elsewhere on the board
CMA4: U261.16 (MA4); also elsewhere on the board
CMA5: U261.17 (MA5); also elsewhere on the board
CMA6: U261.18 (MA6); also elsewhere on the board
CMA7: U261.28 (MA7); also elsewhere on the board
CMA8: U261.31 (MA8); also elsewhere on the board
CMA9: U261.32 (MA9); also elsewhere on the board
D0: U250.86 (PD(0)); also elsewhere on the board
D1: U250.85 (PD(1)); also elsewhere on the board
D2: U250.84 (PD(2)); also elsewhere on the board
D3: U250.83 (PD(3)); also elsewhere on the board
D4: U250.82 (PD(4)); also elsewhere on the board
D5: U250.81 (PD(5)); also elsewhere on the board
D6: U250.79 (PD(6)); also elsewhere on the board
D7: U250.78 (PD(7)); also elsewhere on the board
D8: U250.77 (PD(8)); also elsewhere on the board
D9: U250.76 (PD(9)); also elsewhere on the board
D10: U250.75 (PD(10)); also elsewhere on the board
D11: U250.74 (PD(11)); also elsewhere on the board
D12: U250.73 (PD(12)); also elsewhere on the board
D13: U250.72 (PD(13)); also elsewhere on the board
D14: U250.71 (PD(14)); also elsewhere on the board
D15: U250.70 (PD(15)); also elsewhere on the board
D16: U250.69 (PD(16)); also elsewhere on the board
D17: U250.68 (PD(17)); also elsewhere on the board
D18: U250.67 (PD(18)); also elsewhere on the board
D19: U250.66 (PD(19)); also elsewhere on the board
D20: U250.65 (PD(20)); also elsewhere on the board
D21: U250.64 (PD(21)); also elsewhere on the board
D22: U250.63 (PD(22)); also elsewhere on the board
D23: U250.62 (PD(23)); also elsewhere on the board
D24: U250.61 (PD(24)); also elsewhere on the board
D25: U250.60 (PD(25)); also elsewhere on the board
D26: U250.59 (PD(26)); also elsewhere on the board
D27: U250.58 (PD(27)); also elsewhere on the board
D28: U250.57 (PD(28)); also elsewhere on the board
D29: U250.56 (PD(29)); also elsewhere on the board
D30: U250.55 (PD(30)); also elsewhere on the board
D31: U250.54 (PD(31)); also elsewhere on the board
DRD0: U250.96 (CD(0)), U261.2 (D0); also elsewhere on the board
DRD1: U250.97 (CD(1)), U261.4 (D1); also elsewhere on the board
DRD2: U250.98 (CD(2)), U261.6 (D2); also elsewhere on the board
DRD3: U250.99 (CD(3)), U261.8 (D3); also elsewhere on the board
DRD4: U250.100 (CD(4)), U261.20 (D4); also elsewhere on the board
DRD5: U250.2 (CD(5)), U261.22 (D5); also elsewhere on the board
DRD6: U250.3 (CD(6)), U261.24 (D6); also elsewhere on the board
DRD7: U250.4 (CD(7)), U261.26 (D7); also elsewhere on the board
DRD8: U250.5 (CD(8)), U261.49 (D9); also elsewhere on the board
DRD9: U250.6 (CD(9)), U261.51 (D10); also elsewhere on the board
DRD10: U250.7 (CD(10)), U261.53 (D11); also elsewhere on the board
DRD11: U250.8 (CD(11)), U261.55 (D12); also elsewhere on the board
DRD12: U250.9 (CD(12)), U261.57 (D13); also elsewhere on the board
DRD13: U250.10 (CD(13)), U261.61 (D14); also elsewhere on the board
DRD14: U250.11 (CD(14)), U261.63 (D15); also elsewhere on the board
DRD15: U250.12 (CD(15)), U261.65 (D16); also elsewhere on the board
DRD16: U250.13 (CD(16)), U261.3 (D18); also elsewhere on the board
DRD17: U250.14 (CD(17)), U261.5 (D19); also elsewhere on the board
DRD18: U250.15 (CD(18)), U261.7 (D20); also elsewhere on the board
DRD19: U250.16 (CD(19)), U261.9 (D21); also elsewhere on the board
DRD20: U250.17 (CD(20)), U261.21 (D22); also elsewhere on the board
DRD21: U250.19 (CD(21)), U261.23 (D23); also elsewhere on the board
DRD22: U250.20 (CD(22)), U261.25 (D24); also elsewhere on the board
DRD23: U250.21 (CD(23)), U261.27 (D25); also elsewhere on the board
DRD24: U250.22 (CD(24)), U261.50 (D27); also elsewhere on the board
DRD25: U250.23 (CD(25)), U261.52 (D28); also elsewhere on the board
DRD26: U250.24 (CD(26)), U261.54 (D29); also elsewhere on the board
DRD27: U250.25 (CD(27)), U261.56 (D30); also elsewhere on the board
DRD28: U250.26 (CD(28)), U261.68 (D31); also elsewhere on the board
DRD29: U250.27 (CD(29)), U261.60 (D32); also elsewhere on the board
DRD30: U250.29 (CD(30)), U261.62 (D33); also elsewhere on the board
DRD31: U250.30 (CD(31)), U261.64 (D34); also elsewhere on the board
GND: C250A1.2, C250C1.2, U250.1 (VSS1), U250.28 (VSS2), U250.36 (VSS3), U250.45 (VSS4), U250.53 (VSS5), U250.80 (VSS6), U261.1 (GND1), U261.11 (OE), U261.39 (GND2), U261.72 (GND3); also elsewhere on the board
_BCWE: U261.47 (WE); also elsewhere on the board
_BRIDGE: U250.95 (_CBR); also elsewhere on the board
_CCAS(0): U261.42 (CAS3); also elsewhere on the board
_CCAS(1): U261.41 (CAS2); also elsewhere on the board
_CCAS(2): U261.43 (CAS1); also elsewhere on the board
_CCAS(3): U261.40 (CAS0); also elsewhere on the board
_CRAS(0): U261.34 (RAS2), U261.44 (RAS0); also elsewhere on the board
_CRAS(1): U261.33 (RAS3), U261.45 (RAS1); also elsewhere on the board
_DSACK1: U250.87 (_CLATCH); also elsewhere on the board
_OECD: U250.89 (_COEL), U250.90 (_COEH); also elsewhere on the board

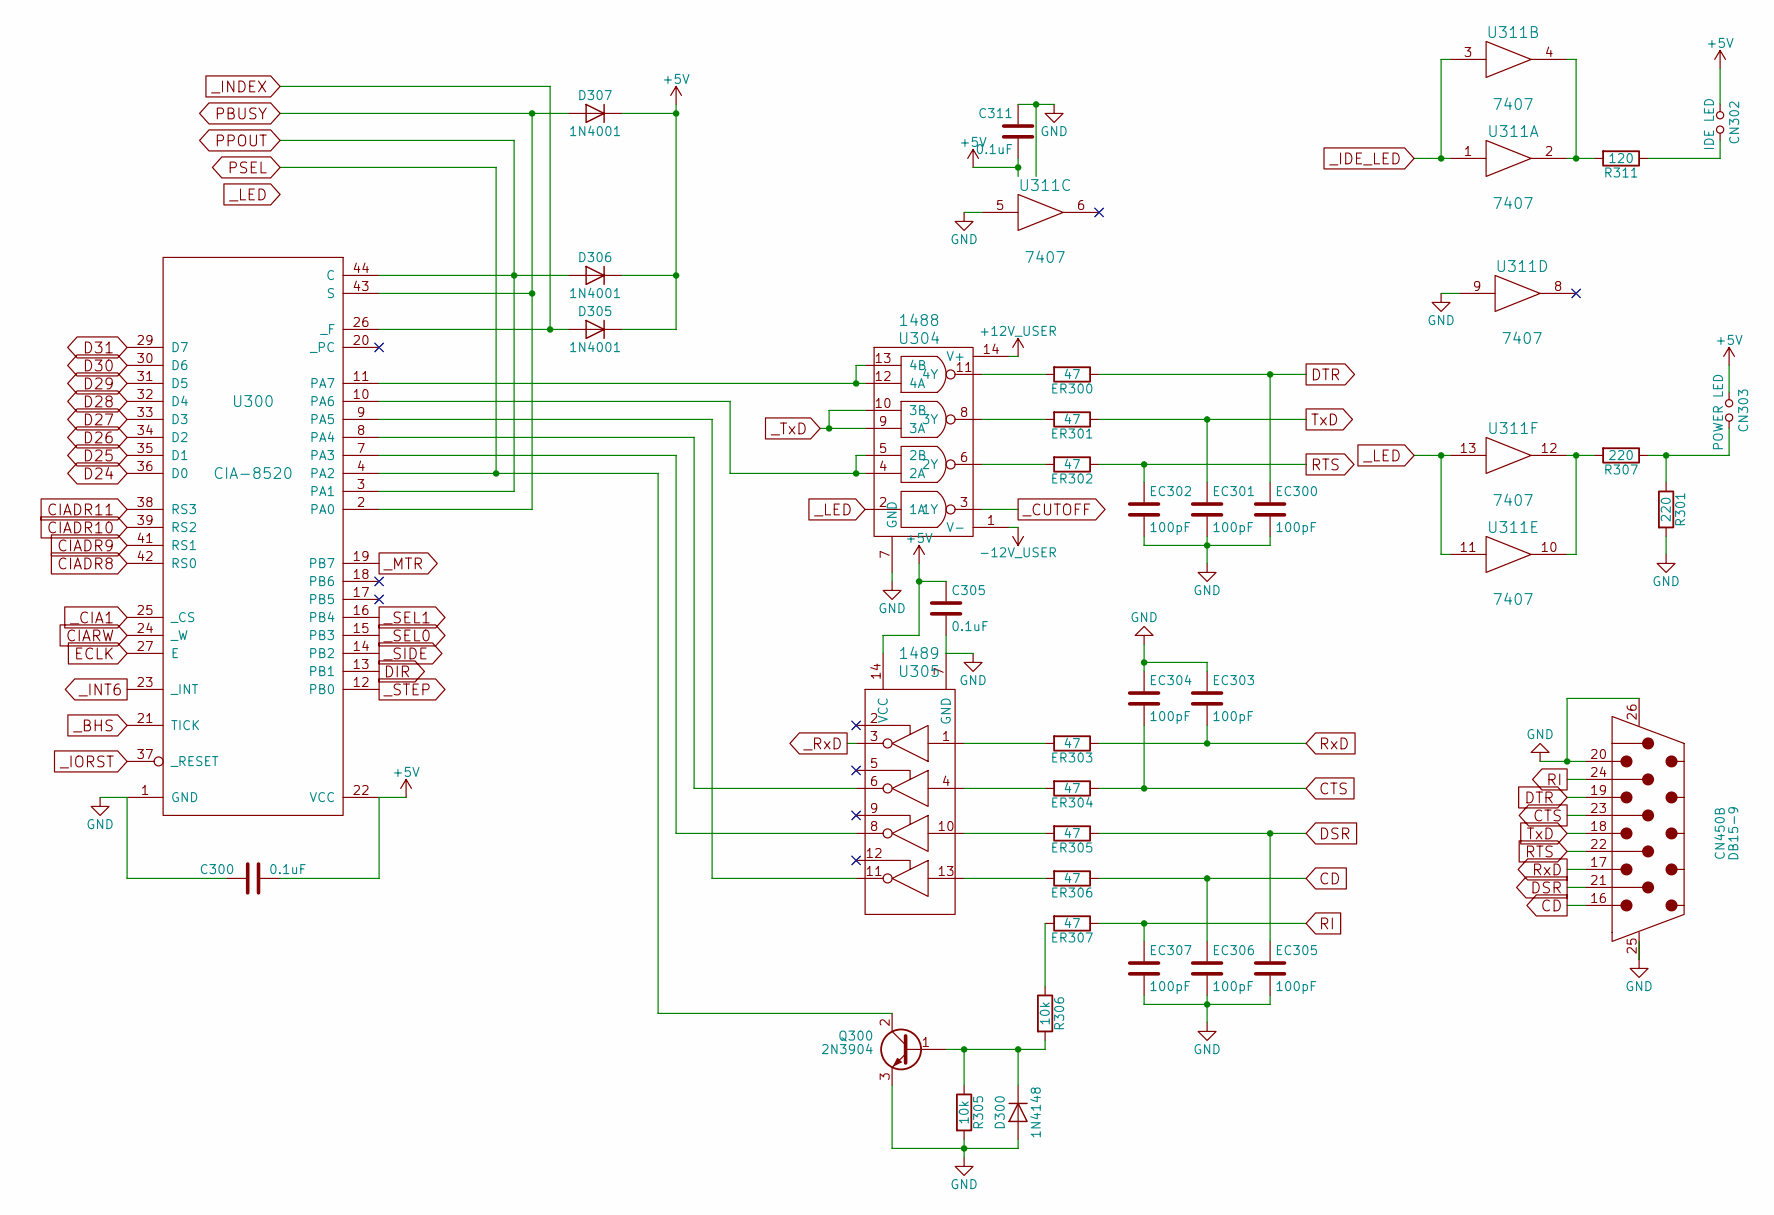
[picture p7: schematic ATX4000-P6.sch]

Parts:
C300, C305, C311: 0.1uF; C_0805_HandSoldering
CN302: IDE LED; Pin_Header_Straight_1x02_Pitch2.54mm
CN303: POWER LED; Pin_Header_Straight_1x02_Pitch2.54mm
CN450: DB15-9
D300: 1N4148; D_SOD-323_HandSoldering
D305, D306, D307: 1N4001; D_SOD-123F
EC300, EC301, EC302, EC303, EC304, EC305, EC306, EC307: 100pF; C_0805_HandSoldering
ER300, ER301, ER302, ER303, ER304, ER305, ER306, ER307: 47; R_0805_HandSoldering
Q300: 2N3904; SOT-223-3_TabPin2
R301, R307: 220; R_0805_HandSoldering
R305, R306: 10k; R_0805_HandSoldering
R311: 120; R_0805_HandSoldering
U300: CIA-8520; PLCC-44_SMD-Socket
U304: 1488; SOIC-14_3.9x8.7mm_Pitch1.27mm
U305: 1489; SOIC-14_3.9x8.7mm_Pitch1.27mm
U311: 7407; SOIC-14_3.9x8.7mm_Pitch1.27mm

Connections:
+5V: C300.2, C305.1, C311.2, CN302.1, CN303.1, D305.1 (K), D306.1 (K), D307.1 (K), U300.22 (VCC), U305.14 (VCC), U311.14 (VCC); also elsewhere on the board
+12V_USER: U304.14 (V+); also elsewhere on the board
-12V_USER: U304.1 (V-); also elsewhere on the board
CD: CN450.16 (5), EC306.1, ER306.1
CIADR8: U300.42 (RS0); also elsewhere on the board
CIADR9: U300.41 (RS1); also elsewhere on the board
CIADR10: U300.39 (RS2); also elsewhere on the board
CIADR11: U300.38 (RS3); also elsewhere on the board
CIARW: U300.24 (_W); also elsewhere on the board
CTS: CN450.23 (8), EC304.2, ER304.1
D24: U300.36 (D0); also elsewhere on the board
D25: U300.35 (D1); also elsewhere on the board
D26: U300.34 (D2); also elsewhere on the board
D27: U300.33 (D3); also elsewhere on the board
D28: U300.32 (D4); also elsewhere on the board
D29: U300.31 (D5); also elsewhere on the board
D30: U300.30 (D6); also elsewhere on the board
D31: U300.29 (D7); also elsewhere on the board
DIR: U300.13 (PB1); also elsewhere on the board
DSR: CN450.21 (10), EC305.1, ER305.1
DTR: CN450.19 (2), EC300.1, ER300.1
ECLK: U300.27 (E); also elsewhere on the board
GND: C300.1, C305.2, C311.1, CN450.20 (1), CN450.25, CN450.26, D300.2 (A), EC300.2, EC301.2, EC302.2, EC303.1, EC304.1, EC305.2, EC306.2, EC307.2, Q300.3 (E), R301.2, R305.2, U300.1 (GND), U304.7 (GND), U305.7 (GND), U311.5, U311.7 (GND), U311.9; also elsewhere on the board
unnamed: CN302.2, R311.1
unnamed: CN303.2, R301.1, R307.1
unnamed: D300.1 (K), Q300.1 (B), R305.1, R306.2
unnamed: ER300.2, U304.11 (4Y)
unnamed: ER301.2, U304.8 (3Y)
unnamed: ER302.2, U304.6 (2Y)
unnamed: ER303.2, U305.1
unnamed: ER304.2, U305.4
unnamed: ER305.2, U305.10
unnamed: ER306.2, U305.13
unnamed: ER307.2, R306.1
unnamed: R307.2, U311.10, U311.12
unnamed: R311.2, U311.2, U311.4
unnamed: U300.7 (PA3), U305.8
unnamed: U300.8 (PA4), U305.6
unnamed: U300.9 (PA5), U305.11
unnamed: U300.10 (PA6), U304.4 (2A), U304.5 (2B)
unnamed: U300.11 (PA7), U304.12 (4A), U304.13 (4B)
PBUSY: D307.2 (A), U300.2 (PA0), U300.43 (S); also elsewhere on the board
PPOUT: D306.2 (A), U300.3 (PA1), U300.44 (C); also elsewhere on the board
PSEL: Q300.2 (C), U300.4 (PA2); also elsewhere on the board
RI: CN450.24 (7), EC307.1, ER307.1
RTS: CN450.22 (9), EC302.1, ER302.1
RxD: CN450.17 (4), EC303.2, ER303.1
TxD: CN450.18 (3), EC301.1, ER301.1
_BHS: U300.21 (TICK); also elsewhere on the board
_CIA1: U300.25 (_CS); also elsewhere on the board
_CUTOFF: U304.3 (1Y); also elsewhere on the board
_IDE_LED: U311.1, U311.3; also elsewhere on the board
_INDEX: D305.2 (A), U300.26 (_F); also elsewhere on the board
_INT6: U300.23 (_INT); also elsewhere on the board
_IORST: U300.37 (_RESET); also elsewhere on the board
_LED: U304.2 (1A), U311.11, U311.13; also elsewhere on the board
_MTR: U300.19 (PB7); also elsewhere on the board
_RxD: U305.3; also elsewhere on the board
_SEL0: U300.15 (PB3); also elsewhere on the board
_SEL1: U300.16 (PB4); also elsewhere on the board
_SIDE: U300.14 (PB2); also elsewhere on the board
_STEP: U300.12 (PB0); also elsewhere on the board
_TxD: U304.9 (3A), U304.10 (3B); also elsewhere on the board

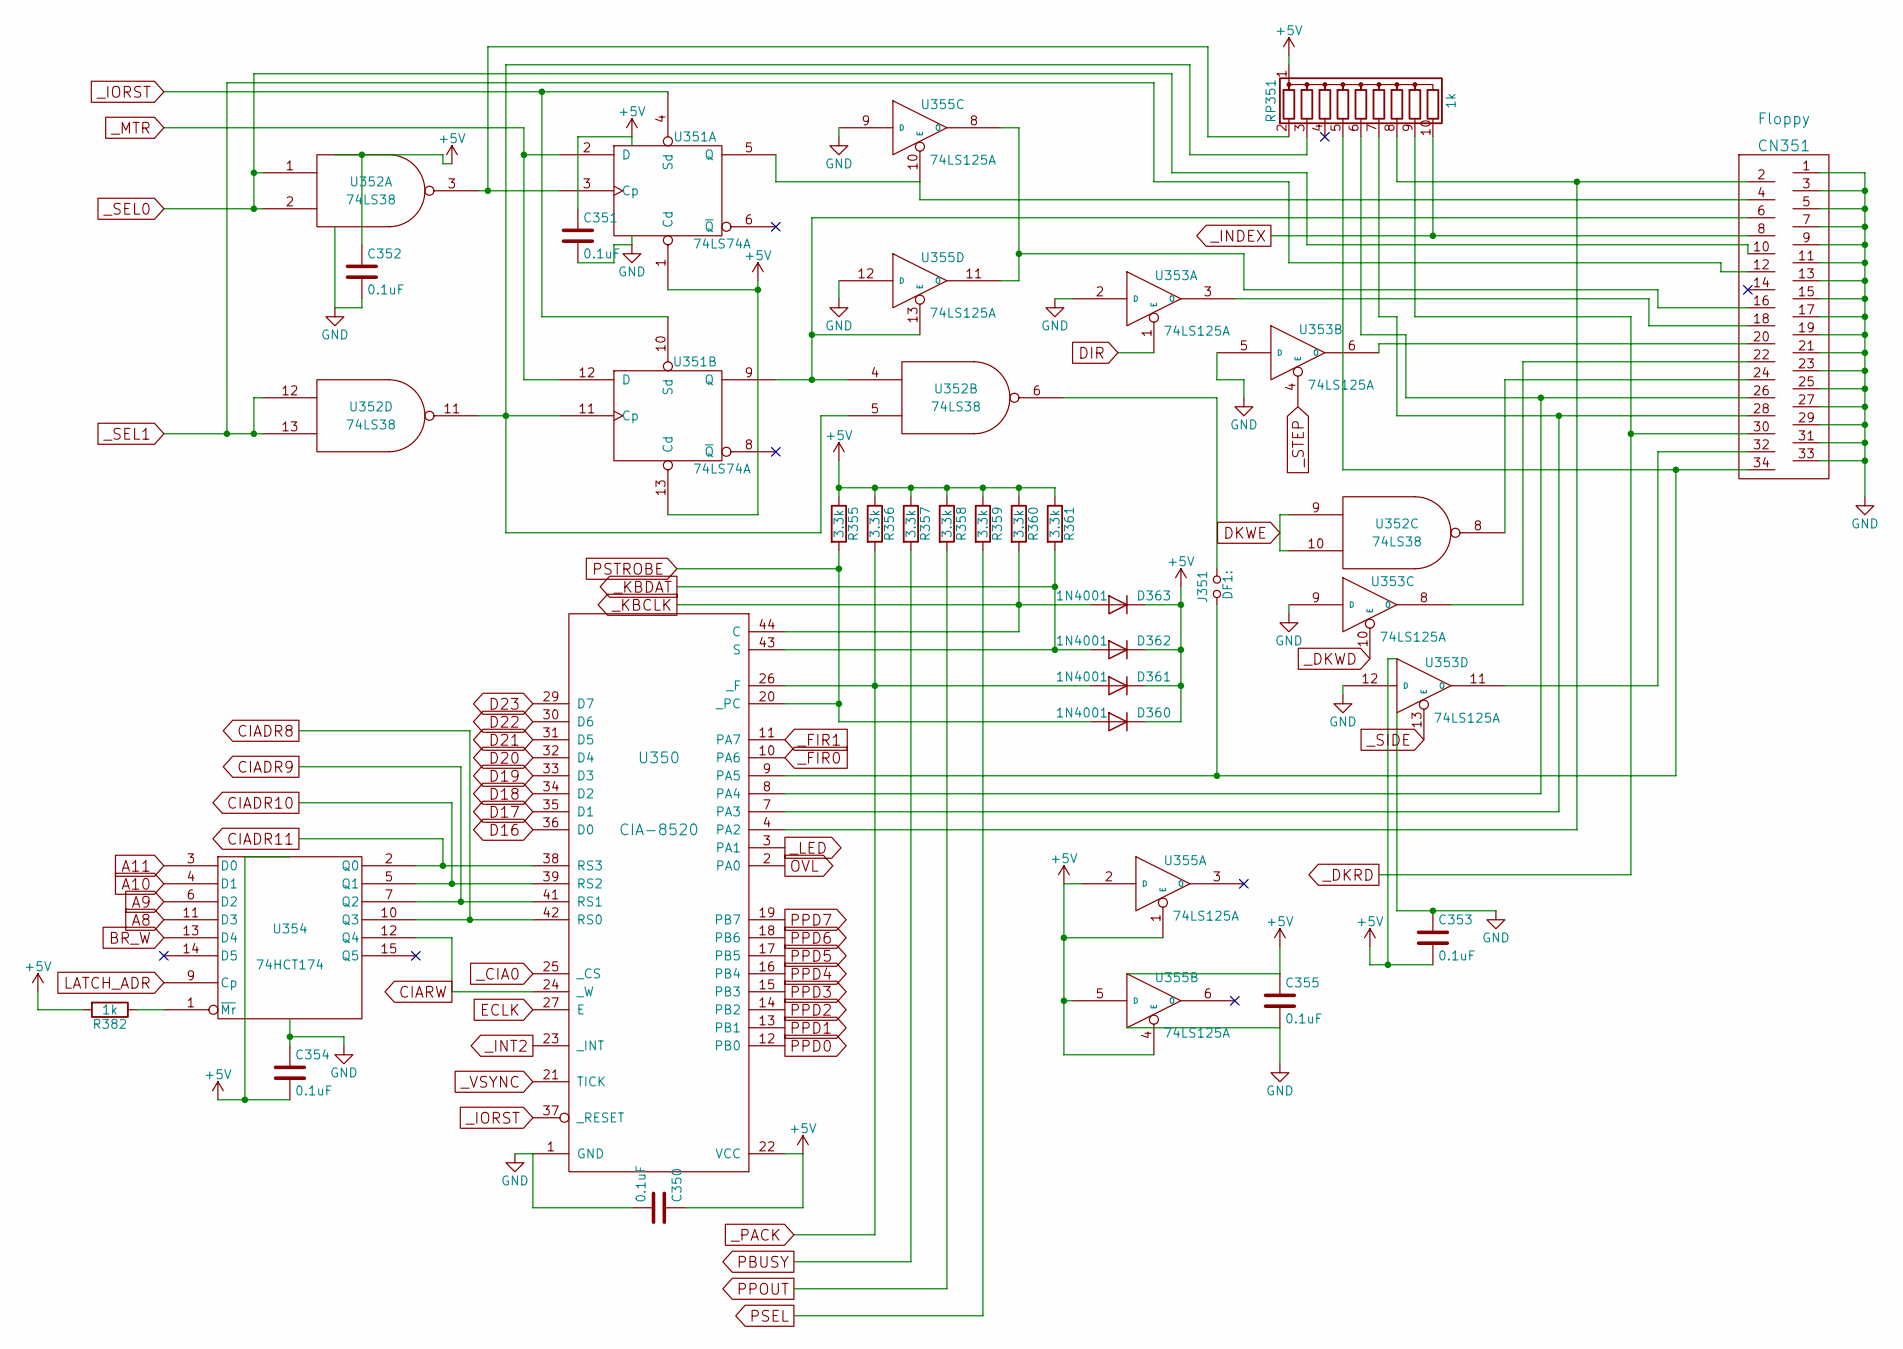
[picture p8: schematic ATX4000-P7.sch]

Parts:
C350, C351, C352, C353, C354, C355: 0.1uF; C_0805_HandSoldering
CN351: Floppy; Pin_Header_Straight_2x17_Pitch2.54mm
D360, D361, D362, D363: 1N4001; D_SOD-123F
J351: DF1:; Pin_Header_Straight_1x02_Pitch2.54mm
R355, R356, R357, R358, R359, R360, R361: 3.3k; R_0805_HandSoldering
R382: 1k; R_0805_HandSoldering
RP351: 1k; R_Array_SIP10
U350: CIA-8520; PLCC-44_SMD-Socket
U351: 74LS74A; SOIC-14_3.9x8.7mm_Pitch1.27mm
U352: 74LS38; SOIC-14_3.9x8.7mm_Pitch1.27mm
U353, U355: 74LS125A
U354: 74HCT174; SOIC-16_3.9x9.9mm_Pitch1.27mm

Connections:
+5V: C350.1, C351.1, C352.1, C353.2, C354.2, C355.1, D360.1 (K), D361.1 (K), D362.1 (K), D363.1 (K), R355.1, R356.1, R357.1, R358.1, R359.1, R360.1, R361.1, R382.2, RP351.1 (common), U350.22 (VCC), U351.1 (Cd), U351.13 (Cd), U351.14 (VCC), U352.14 (VCC), U353.14 (VCC), U354.16 (VCC), U355.1 (E), U355.2 (D), U355.4 (E), U355.5 (D), U355.14 (VCC); also elsewhere on the board
A8: U354.11 (D3); also elsewhere on the board
A9: U354.6 (D2); also elsewhere on the board
A10: U354.4 (D1); also elsewhere on the board
A11: U354.3 (D0); also elsewhere on the board
BR_W: U354.13 (D4); also elsewhere on the board
CIADR8: U350.42 (RS0), U354.10 (Q3); also elsewhere on the board
CIADR9: U350.41 (RS1), U354.7 (Q2); also elsewhere on the board
CIADR10: U350.39 (RS2), U354.5 (Q1); also elsewhere on the board
CIADR11: U350.38 (RS3), U354.2 (Q0); also elsewhere on the board
CIARW: U350.24 (_W), U354.12 (Q4); also elsewhere on the board
D16: U350.36 (D0); also elsewhere on the board
D17: U350.35 (D1); also elsewhere on the board
D18: U350.34 (D2); also elsewhere on the board
D19: U350.33 (D3); also elsewhere on the board
D20: U350.32 (D4); also elsewhere on the board
D21: U350.31 (D5); also elsewhere on the board
D22: U350.30 (D6); also elsewhere on the board
D23: U350.29 (D7); also elsewhere on the board
DIR: U353.1 (E); also elsewhere on the board
DKWE: U352.9, U352.10; also elsewhere on the board
ECLK: U350.27 (E); also elsewhere on the board
GND: C350.2, C351.2, C352.2, C353.1, C354.1, C355.2, CN351.1, CN351.3, CN351.5, CN351.7, CN351.9, CN351.11, CN351.13, CN351.15, CN351.17, CN351.19, CN351.21, CN351.23, CN351.25, CN351.27, CN351.29, CN351.31, CN351.33, U350.1 (GND), U351.7 (GND), U352.7 (GND), U353.2 (D), U353.5 (D), U353.7 (GND), U353.9 (D), U353.12 (D), U354.8 (GND), U355.7 (GND), U355.9 (D), U355.12 (D); also elsewhere on the board
LATCH_ADR: U354.9 (Cp); also elsewhere on the board
unnamed: CN351.2, RP351.8 (R7), U350.4 (PA2)
unnamed: CN351.4, U351.5 (Q), U355.10 (E)
unnamed: CN351.6, U351.9 (Q), U352.4, U355.13 (E)
unnamed: CN351.16, U355.8 (O), U355.11 (O)
unnamed: CN351.18, U353.3 (O)
unnamed: CN351.20, U353.6 (O)
unnamed: CN351.22, U353.8 (O)
unnamed: CN351.24, U352.8
unnamed: CN351.26, RP351.6 (R5), U350.8 (PA4)
unnamed: CN351.28, RP351.7 (R6), U350.7 (PA3)
unnamed: CN351.32, U353.11 (O)
unnamed: CN351.34, J351.1, RP351.5 (R4), U350.9 (PA5)
unnamed: J351.2, U352.6
unnamed: R382.1, U354.1 (~Mr)
unnamed: RP351.2 (R1), U351.3 (Cp), U352.3
unnamed: RP351.3 (R2), U351.11 (Cp), U352.5, U352.11
OVL: U350.2 (PA0); also elsewhere on the board
PBUSY: R357.2; also elsewhere on the board
PPD0: U350.12 (PB0); also elsewhere on the board
PPD1: U350.13 (PB1); also elsewhere on the board
PPD2: U350.14 (PB2); also elsewhere on the board
PPD3: U350.15 (PB3); also elsewhere on the board
PPD4: U350.16 (PB4); also elsewhere on the board
PPD5: U350.17 (PB5); also elsewhere on the board
PPD6: U350.18 (PB6); also elsewhere on the board
PPD7: U350.19 (PB7); also elsewhere on the board
PPOUT: R358.2; also elsewhere on the board
PSEL: R359.2; also elsewhere on the board
PSTROBE: D360.2 (A), R355.2, U350.20 (_PC); also elsewhere on the board
_CIA0: U350.25 (_CS); also elsewhere on the board
_DKRD: CN351.30, RP351.9 (R8); also elsewhere on the board
_DKWD: U353.10 (E); also elsewhere on the board
_FIR0: U350.10 (PA6); also elsewhere on the board
_FIR1: U350.11 (PA7); also elsewhere on the board
_INDEX: CN351.8, RP351.10 (R9); also elsewhere on the board
_INT2: U350.23 (_INT); also elsewhere on the board
_IORST: U350.37 (_RESET), U351.4 (Sd), U351.10 (Sd); also elsewhere on the board
_KBCLK: D363.2 (A), R360.2, U350.44 (C); also elsewhere on the board
_KBDAT: D362.2 (A), R361.2, U350.43 (S); also elsewhere on the board
_LED: U350.3 (PA1); also elsewhere on the board
_MTR: U351.2 (D), U351.12 (D); also elsewhere on the board
_PACK: D361.2 (A), R356.2, U350.26 (_F); also elsewhere on the board
_SEL0: CN351.10, U352.1, U352.2; also elsewhere on the board
_SEL1: CN351.12, U352.12, U352.13; also elsewhere on the board
_SIDE: U353.13 (E); also elsewhere on the board
_STEP: U353.4 (E); also elsewhere on the board
_VSYNC: U350.21 (TICK); also elsewhere on the board
