elenachenchen/A4000-ATX/ATX4000.kicad_pcb

## KiCad design ATX4000.kicad_pcb (continued)

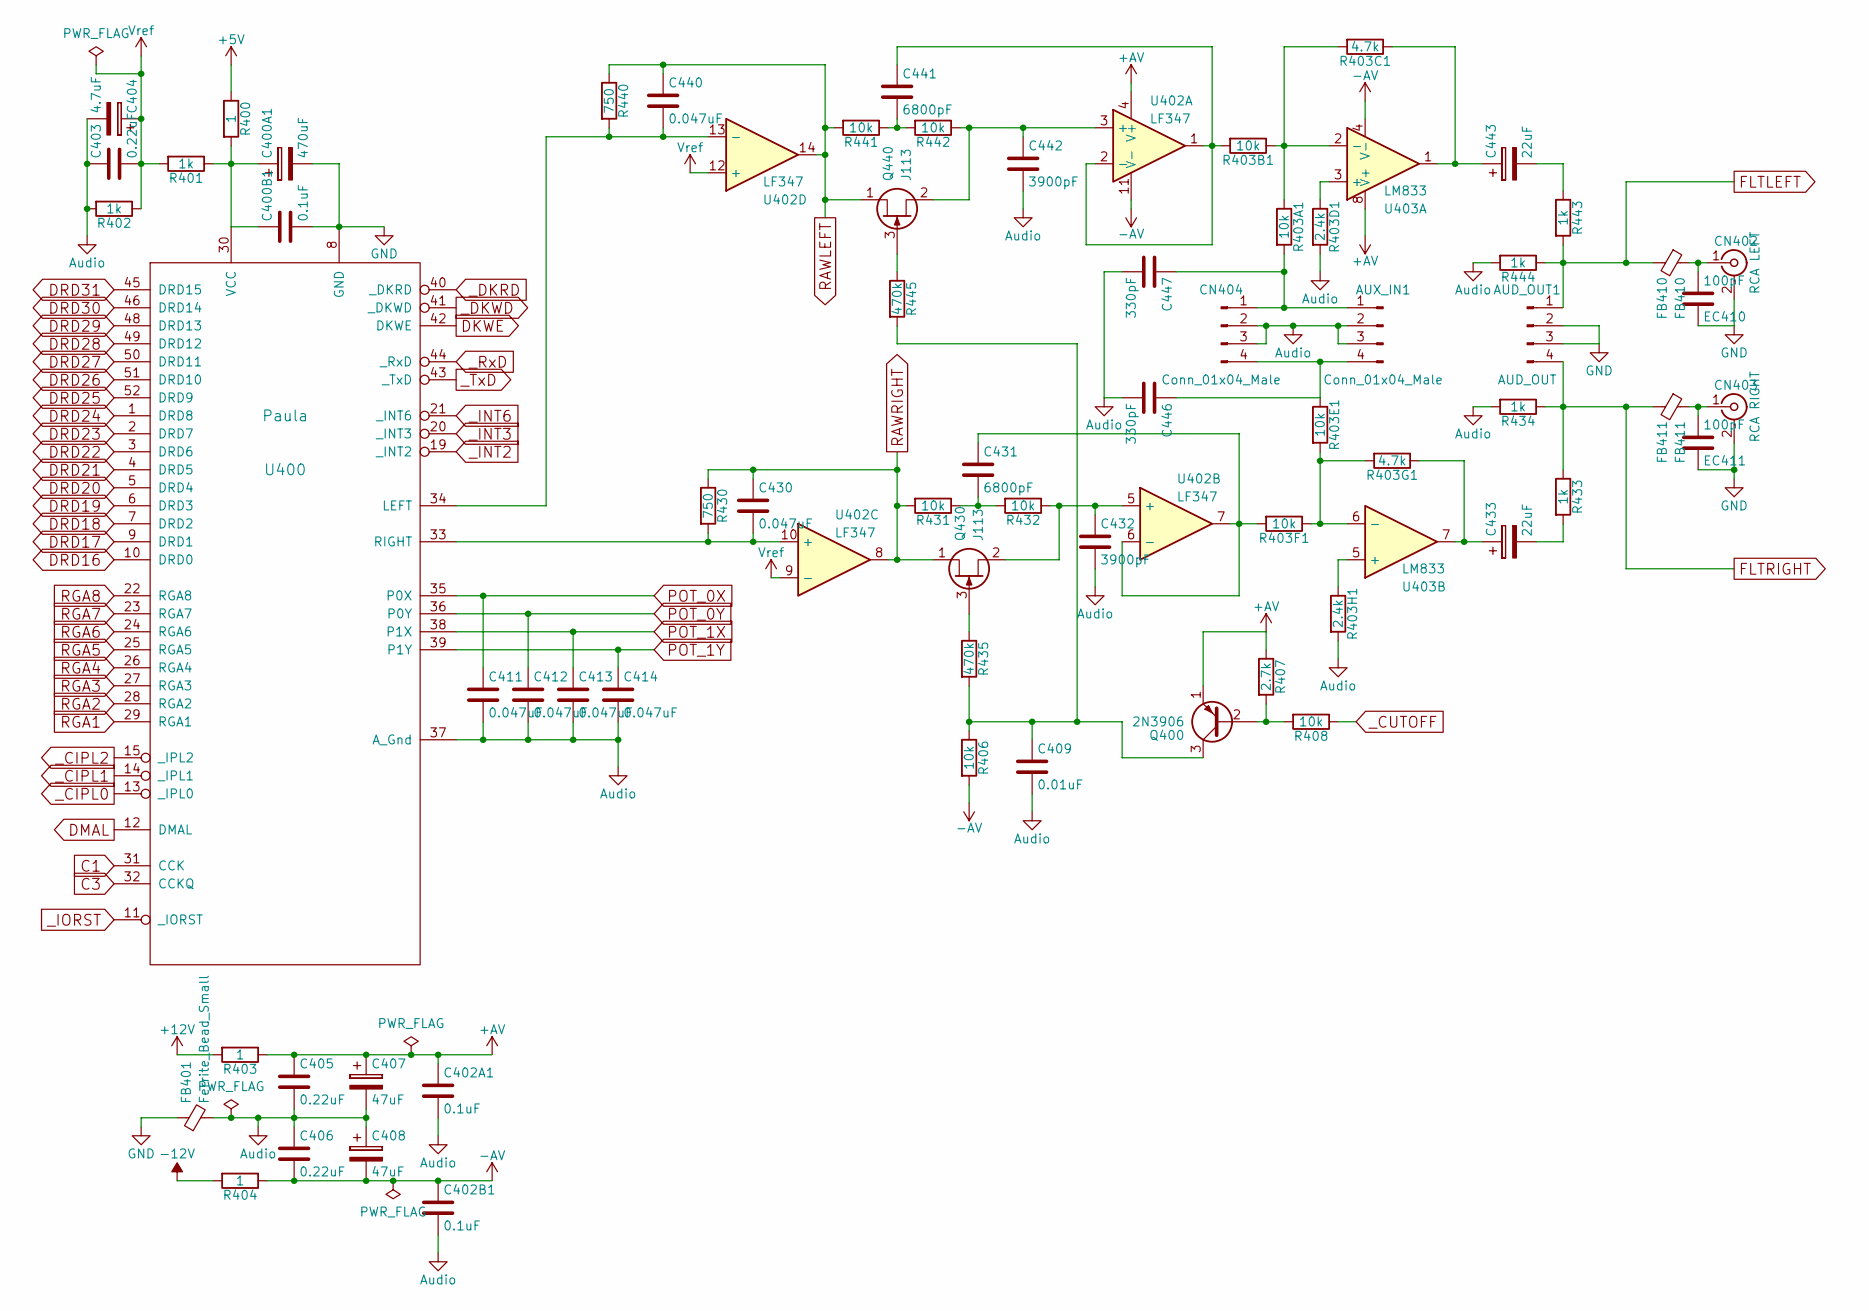
[picture p9: schematic ATX4000-P8.sch]

Parts:
AUD_OUT1: AUD_OUT; Pin_Header_Straight_1x04_Pitch2.54mm
AUX_IN1: Conn_01x04_Male; Pin_Header_Straight_1x04_Pitch2.54mm
C400A1: 470uF; CP_Elec_8x10
C400B1, C402A1, C402B1: 0.1uF; C_0805_HandSoldering
C403, C405, C406: 0.22uF; C_0805_HandSoldering
C404: 4.7uF; CP_Elec_4x5.3
C407, C408: 47uF; CP_Elec_6.3x5.8
C409: 0.01uF; C_0805_HandSoldering
C411, C412, C413, C414, C430, C440: 0.047uF; C_0805_HandSoldering
C431, C441: 6800pF; C_0805_HandSoldering
C432, C442: 3900pF; C_0805_HandSoldering
C433, C443: 22uF; CP_Elec_5x5.3
C446, C447: 330pF; C_0805_HandSoldering
CN402: RCA LEFT; RCA-Jack
CN403: RCA RIGHT; RCA-Jack
CN404: Conn_01x04_Male; Pin_Header_Straight_1x04_Pitch2.54mm
EC410, EC411: 100pF; C_0805_HandSoldering
FB401: Ferrite_Bead_Small; L_1206_HandSoldering
FB410: FB410; R_0805_HandSoldering
FB411: FB411; R_0805_HandSoldering
Q400: 2N3906; SOT-223-3_TabPin2
Q430, Q440: J113; TO-92_Inline_Narrow_Oval
R400, R403, R404: 1; R_2512_HandSoldering
R401, R402, R433, R434, R443, R444: 1k; R_0805_HandSoldering
R403A1, R403B1, R403E1, R403F1, R406, R408, R431, R432, R441, R442: 10k; R_0805_HandSoldering
R403C1, R403G1: 4.7k; R_0805_HandSoldering
R403D1, R403H1: 2.4k; R_0805_HandSoldering
R407: 2.7k; R_0805_HandSoldering
R430, R440: 750; R_0805_HandSoldering
R435, R445: 470k; R_0805_HandSoldering
U400: Paula; PLCC-52_SMD-Socket
U402: LF347; SOIC-14_3.9x8.7mm_Pitch1.27mm
U403: LM833; SOIC-8_3.9x4.9mm_Pitch1.27mm

Connections:
+5V: R400.1; also elsewhere on the board
+12V: R403.2; also elsewhere on the board
+AV: C402A1.1, C405.1, C407.1, Q400.1 (E), R403.1, R407.1, U402.4 (V+), U403.8 (V+)
-12V: R404.2; also elsewhere on the board
-AV: C402B1.1, C406.2, C408.2, R404.1, R406.2, U402.11 (V-), U403.4 (V-)
Audio: AUX_IN1.2, AUX_IN1.3, C402A1.2, C402B1.2, C403.1, C404.2, C405.2, C406.1, C407.2, C408.1, C409.2, C411.2, C412.2, C413.2, C414.2, C432.2, C442.2, C446.2, C447.2, CN404.2, CN404.3, FB401.2, R402.2, R403D1.2, R403H1.2, R434.2, R444.2, U400.37 (A_Gnd); also elsewhere on the board
C1: U400.31 (CCK); also elsewhere on the board
C3: U400.32 (CCKQ); also elsewhere on the board
DKWE: U400.42 (DKWE); also elsewhere on the board
DMAL: U400.12 (DMAL); also elsewhere on the board
DRD16: U400.10 (DRD0); also elsewhere on the board
DRD17: U400.9 (DRD1); also elsewhere on the board
DRD18: U400.7 (DRD2); also elsewhere on the board
DRD19: U400.6 (DRD3); also elsewhere on the board
DRD20: U400.5 (DRD4); also elsewhere on the board
DRD21: U400.4 (DRD5); also elsewhere on the board
DRD22: U400.3 (DRD6); also elsewhere on the board
DRD23: U400.2 (DRD7); also elsewhere on the board
DRD24: U400.1 (DRD8); also elsewhere on the board
DRD25: U400.52 (DRD9); also elsewhere on the board
DRD26: U400.51 (DRD10); also elsewhere on the board
DRD27: U400.50 (DRD11); also elsewhere on the board
DRD28: U400.49 (DRD12); also elsewhere on the board
DRD29: U400.48 (DRD13); also elsewhere on the board
DRD30: U400.46 (DRD14); also elsewhere on the board
DRD31: U400.45 (DRD15); also elsewhere on the board
FLTLEFT: AUD_OUT1.1, FB410.2, R443.2, R444.1; also elsewhere on the board
FLTRIGHT: AUD_OUT1.4, FB411.2, R433.1, R434.1; also elsewhere on the board
GND: AUD_OUT1.2, AUD_OUT1.3, C400A1.2, C400B1.2, CN402.2 (Ext), CN403.2 (Ext), EC410.1, EC411.1, FB401.1, U400.8 (GND); also elsewhere on the board
unnamed: AUX_IN1.1, C447.1, CN404.1, R403A1.2
unnamed: AUX_IN1.4, C446.1, CN404.4, R403E1.1
unnamed: C400A1.1, C400B1.1, R400.2, R401.1, U400.30 (VCC)
unnamed: C409.1, Q400.3 (C), R406.1, R435.2, R445.2
unnamed: C430.2, R430.2, U400.33 (RIGHT), U402.10 (+)
unnamed: C431.1, R403F1.2, U402.6 (-), U402.7
unnamed: C431.2, R431.1, R432.2
unnamed: C432.1, Q430.2 (S), R432.1, U402.5 (+)
unnamed: C433.1, R403G1.1, U403.7
unnamed: C433.2, R433.2
unnamed: C440.2, R440.2, U400.34 (LEFT), U402.13 (-)
unnamed: C441.1, R403B1.2, U402.1, U402.2 (-)
unnamed: C441.2, R441.1, R442.2
unnamed: C442.1, Q440.2 (S), R442.1, U402.3 (+)
unnamed: C443.1, R403C1.1, U403.1
unnamed: C443.2, R443.1
unnamed: CN402.1 (In), EC410.2, FB410.1
unnamed: CN403.1 (In), EC411.2, FB411.1
unnamed: Q400.2 (B), R407.2, R408.2
unnamed: Q430.3 (G), R435.1
unnamed: Q440.3 (G), R445.1
unnamed: R403A1.1, R403B1.1, R403C1.2, U403.2 (-)
unnamed: R403D1.1, U403.3 (+)
unnamed: R403E1.2, R403F1.1, R403G1.2, U403.6 (-)
unnamed: R403H1.1, U403.5 (+)
POT_0X: C411.1, U400.35 (P0X); also elsewhere on the board
POT_0Y: C412.1, U400.36 (P0Y); also elsewhere on the board
POT_1X: C413.1, U400.38 (P1X); also elsewhere on the board
POT_1Y: C414.1, U400.39 (P1Y); also elsewhere on the board
RAWLEFT: C440.1, Q440.1 (D), R440.1, R441.2, U402.14; also elsewhere on the board
RAWRIGHT: C430.1, Q430.1 (D), R430.1, R431.2, U402.8; also elsewhere on the board
RGA1: U400.29 (RGA1); also elsewhere on the board
RGA2: U400.28 (RGA2); also elsewhere on the board
RGA3: U400.27 (RGA3); also elsewhere on the board
RGA4: U400.26 (RGA4); also elsewhere on the board
RGA5: U400.25 (RGA5); also elsewhere on the board
RGA6: U400.24 (RGA6); also elsewhere on the board
RGA7: U400.23 (RGA7); also elsewhere on the board
RGA8: U400.22 (RGA8); also elsewhere on the board
Vref: C403.2, C404.1, R401.2, R402.1, U402.9 (-), U402.12 (+)
_CIPL0: U400.13 (_IPL0); also elsewhere on the board
_CIPL1: U400.14 (_IPL1); also elsewhere on the board
_CIPL2: U400.15 (_IPL2); also elsewhere on the board
_CUTOFF: R408.1; also elsewhere on the board
_DKRD: U400.40 (_DKRD); also elsewhere on the board
_DKWD: U400.41 (_DKWD); also elsewhere on the board
_INT2: U400.19 (_INT2); also elsewhere on the board
_INT3: U400.20 (_INT3); also elsewhere on the board
_INT6: U400.21 (_INT6); also elsewhere on the board
_IORST: U400.11 (_IORST); also elsewhere on the board
_RxD: U400.44 (_RxD); also elsewhere on the board
_TxD: U400.43 (_TxD); also elsewhere on the board

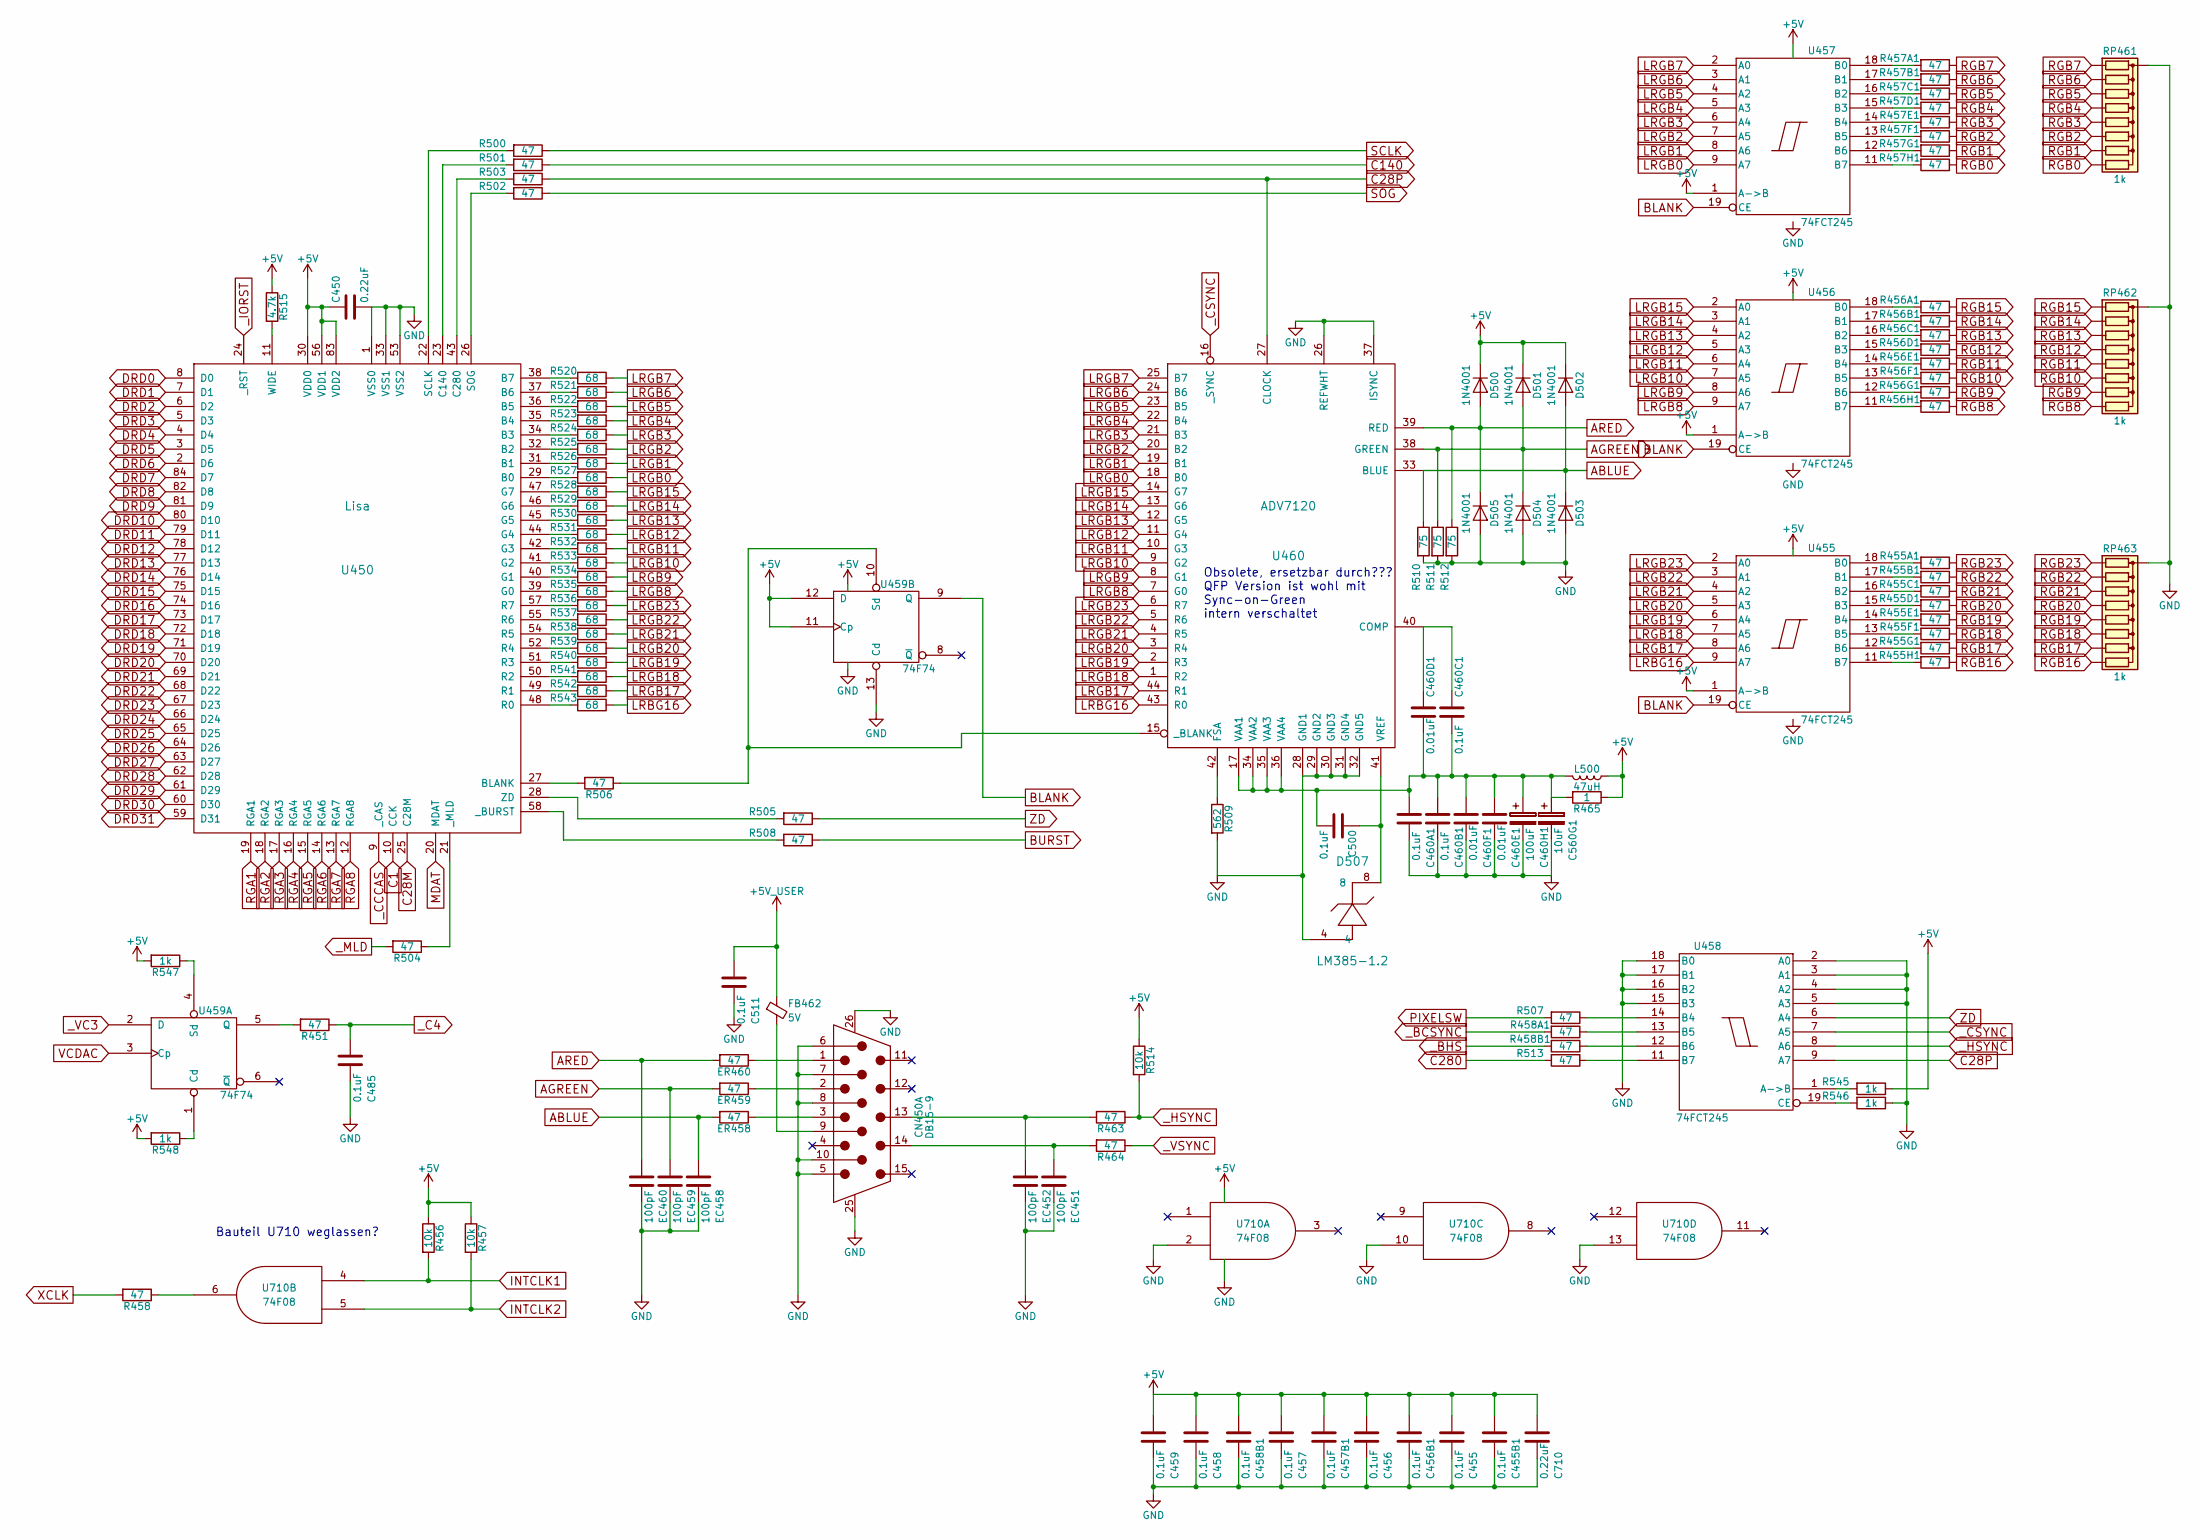
[picture p10: schematic ATX4000-P9.sch]

Parts:
C450: 0.22uF; C_0805_HandSoldering
C455, C455B1, C456, C456B1, C457, C457B1, C458, C458B1, C459: 0.1uF; R_0805_HandSoldering
C460A1, C460B1, C460C1, C485, C500, C511: 0.1uF; C_0805_HandSoldering
C460D1, C460E1, C460F1: 0.01uF; C_0805_HandSoldering
C460H1: 100uF; CP_Elec_5x5.3
C560G1: 10uF; CP_Elec_4x4.5
C710: 0.22uF; R_0805_HandSoldering
CN450: DB15-9; D-SUB15-9
D500, D501, D502, D503, D504, D505: 1N4001; D_SOD-123F
D507: LM385-1.2; SOIC-8_3.9x4.9mm_Pitch1.27mm
EC451, EC452, EC458, EC459, EC460: 100pF; C_0805_HandSoldering
ER458, ER459, ER460: 47; R_0805_HandSoldering
FB462: 5V; R_1206_HandSoldering
L500: 47uH; L_1210_HandSoldering
R451, R455A1, R455B1, R455C1, R455D1, R455E1, R455F1, R455G1, R455H1, R456A1, R456B1, R456C1, R456D1, R456E1, R456F1, R456G1, R456H1, R457A1, R457B1, R457C1, R457D1, R457E1, R457F1, R457G1, R457H1, R458, R458A1, R458B1, R463, R464, R500, R501, R502, R503, R504, R505, R506, R507, R508, R513: 47; R_0805_HandSoldering
R456, R457, R514: 10k; R_0805_HandSoldering
R465: 1; R_2512_HandSoldering
R509: 562; R_0805_HandSoldering
R510, R511, R512: 75; R_0805_HandSoldering
R515: 4.7k; R_0805_HandSoldering
R520, R521, R522, R523, R524, R525, R526, R527, R528, R529, R530, R531, R532, R533, R534, R535, R536, R537, R538, R539, R540, R541, R542, R543: 68; R_0805_HandSoldering
R545, R546, R547, R548: 1k; R_0805_HandSoldering
RP461, RP462, RP463: 1k; R_Array_SIP9
U450: Lisa; PLCC-84_SMD-Socket
U455, U456, U457, U458: 74FCT245; QSOP-20_3.9x8.7mm_Pitch0.635mm
U459: 74F74; SOIC-14_3.9x8.7mm_Pitch1.27mm
U460: ADV7120; PLCC-44_SMD-Socket
U710: 74F08; SOIC-14_3.9x8.7mm_Pitch1.27mm

Connections:
+5V: C450.1, C455.1, C455B1.1, C456.1, C456B1.1, C457.1, C457B1.1, C458.1, C458B1.1, C459.1, C710.1, D500.1 (K), D501.1 (K), D502.1 (K), L500.1, R456.1, R457.1, R465.1, R514.1, R515.1, R545.1, R547.2, R548.2, U450.30 (VDD0), U450.56 (VDD1), U450.83 (VDD2), U455.1 (A->B), U455.20 (VCC), U456.1 (A->B), U456.20 (VCC), U457.1 (A->B), U457.20 (VCC), U458.20 (VCC), U459.11 (Cp), U459.12 (D), U459.14 (VCC), U710.14 (VCC); also elsewhere on the board
+5V_USER: C511.1, FB462.1; also elsewhere on the board
ABLUE: D502.2 (A), D503.1 (K), EC458.1, ER458.2, R510.1, U460.33 (BLUE); also elsewhere on the board
AGREEN: D501.2 (A), D504.1 (K), EC459.1, ER459.2, R511.1, U460.38 (GREEN); also elsewhere on the board
ARED: D500.2 (A), D505.1 (K), EC460.1, ER460.2, R512.1, U460.39 (RED); also elsewhere on the board
BLANK: U455.19 (CE), U456.19 (CE), U457.19 (CE), U459.9 (Q); also elsewhere on the board
BURST: R508.1; also elsewhere on the board
C1: U450.10 (CCK); also elsewhere on the board
C28M: U450.25 (C28M); also elsewhere on the board
C28P: R503.1, U458.9 (A7), U460.27 (CLOCK)
C140: R501.1; also elsewhere on the board
C280: R513.2; also elsewhere on the board
DRD0: U450.8 (D0); also elsewhere on the board
DRD1: U450.7 (D1); also elsewhere on the board
DRD2: U450.6 (D2); also elsewhere on the board
DRD3: U450.5 (D3); also elsewhere on the board
DRD4: U450.4 (D4); also elsewhere on the board
DRD5: U450.3 (D5); also elsewhere on the board
DRD6: U450.2 (D6); also elsewhere on the board
DRD7: U450.84 (D7); also elsewhere on the board
DRD8: U450.82 (D8); also elsewhere on the board
DRD9: U450.81 (D9); also elsewhere on the board
DRD10: U450.80 (D10); also elsewhere on the board
DRD11: U450.79 (D11); also elsewhere on the board
DRD12: U450.78 (D12); also elsewhere on the board
DRD13: U450.77 (D13); also elsewhere on the board
DRD14: U450.76 (D14); also elsewhere on the board
DRD15: U450.75 (D15); also elsewhere on the board
DRD16: U450.74 (D16); also elsewhere on the board
DRD17: U450.73 (D17); also elsewhere on the board
DRD18: U450.72 (D18); also elsewhere on the board
DRD19: U450.71 (D19); also elsewhere on the board
DRD20: U450.70 (D20); also elsewhere on the board
DRD21: U450.69 (D21); also elsewhere on the board
DRD22: U450.68 (D22); also elsewhere on the board
DRD23: U450.67 (D23); also elsewhere on the board
DRD24: U450.66 (D24); also elsewhere on the board
DRD25: U450.65 (D25); also elsewhere on the board
DRD26: U450.64 (D26); also elsewhere on the board
DRD27: U450.63 (D27); also elsewhere on the board
DRD28: U450.62 (D28); also elsewhere on the board
DRD29: U450.61 (D29); also elsewhere on the board
DRD30: U450.60 (D30); also elsewhere on the board
DRD31: U450.59 (D31); also elsewhere on the board
GND: C450.2, C455.2, C455B1.2, C456.2, C456B1.2, C457.2, C457B1.2, C458.2, C458B1.2, C459.2, C460A1.2, C460B1.2, C460E1.2, C460F1.2, C460H1.2, C485.2, C511.2, C560G1.2, C710.2, CN450.5, CN450.6, CN450.7, CN450.8, CN450.10, CN450.25, CN450.26, D503.2 (A), D504.2 (A), D505.2 (A), D507.4, EC451.2, EC452.2, EC458.2, EC459.2, EC460.2, R509.2, R510.2, R511.2, R512.2, R546.1, RP461.1 (common), RP462.1 (common), RP463.1 (common), U450.1 (VSS0), U450.33 (VSS1), U450.53 (VSS2), U455.10 (GND), U456.10 (GND), U457.10 (GND), U458.2 (A0), U458.3 (A1), U458.4 (A2), U458.5 (A3), U458.10 (GND), U458.15 (B3), U458.16 (B2), U458.17 (B1), U458.18 (B0), U459.7 (GND), U459.13 (Cd), U460.26 (REFWHT), U460.28 (GND1), U460.29 (GND2), U460.30 (GND3), U460.31 (GND4), U460.32 (GND5), U460.37 (ISYNC), U710.2, U710.7 (GND), U710.10, U710.13; also elsewhere on the board
INTCLK1: R456.2, U710.4; also elsewhere on the board
INTCLK2: R457.2, U710.5; also elsewhere on the board
LRBG16: R543.1, U455.9 (A7), U460.43 (R0)
LRGB0: R527.1, U457.9 (A7), U460.18 (B0)
LRGB1: R526.1, U457.8 (A6), U460.19 (B1)
LRGB2: R525.1, U457.7 (A5), U460.20 (B2)
LRGB3: R524.1, U457.6 (A4), U460.21 (B3)
LRGB4: R523.1, U457.5 (A3), U460.22 (B4)
LRGB5: R522.1, U457.4 (A2), U460.23 (B5)
LRGB6: R521.1, U457.3 (A1), U460.24 (B6)
LRGB7: R520.1, U457.2 (A0), U460.25 (B7)
LRGB8: R535.1, U456.9 (A7), U460.7 (G0)
LRGB9: R534.1, U456.8 (A6), U460.8 (G1)
LRGB10: R533.1, U456.7 (A5), U460.9 (G2)
LRGB11: R532.1, U456.6 (A4), U460.10 (G3)
LRGB12: R531.1, U456.5 (A3), U460.11 (G4)
LRGB13: R530.1, U456.4 (A2), U460.12 (G5)
LRGB14: R529.1, U456.3 (A1), U460.13 (G6)
LRGB15: R528.1, U456.2 (A0), U460.14 (G7)
LRGB17: R542.1, U455.8 (A6), U460.44 (R1)
LRGB18: R541.1, U455.7 (A5), U460.1 (R2)
LRGB19: R540.1, U455.6 (A4), U460.2 (R3)
LRGB20: R539.1, U455.5 (A3), U460.3 (R4)
LRGB21: R538.1, U455.4 (A2), U460.4 (R5)
LRGB22: R537.1, U455.3 (A1), U460.5 (R6)
LRGB23: R536.1, U455.2 (A0), U460.6 (R7)
MDAT: U450.20 (MDAT); also elsewhere on the board
unnamed: C460A1.1, C460B1.1, C460C1.2, C460D1.2, C460E1.1, C460F1.1, C460H1.1, C500.2, C560G1.1, L500.2, R465.2, U460.17 (VAA1), U460.34 (VAA2), U460.35 (VAA3), U460.36 (VAA4)
unnamed: C460C1.1, C460D1.1, U460.40 (COMP)
unnamed: C500.1, D507.8, U460.41 (VREF)
unnamed: CN450.1, ER460.1
unnamed: CN450.2, ER459.1
unnamed: CN450.3, ER458.1
unnamed: CN450.9, FB462.2
unnamed: CN450.13, EC452.1, R463.2
unnamed: CN450.14, EC451.1, R464.2
unnamed: R451.2, U459.5 (Q)
unnamed: R455A1.2, U455.18 (B0)
unnamed: R455B1.2, U455.17 (B1)
unnamed: R455C1.2, U455.16 (B2)
unnamed: R455D1.2, U455.15 (B3)
unnamed: R455E1.2, U455.14 (B4)
unnamed: R455F1.2, U455.13 (B5)
unnamed: R455G1.2, U455.12 (B6)
unnamed: R455H1.2, U455.11 (B7)
unnamed: R456A1.2, U456.18 (B0)
unnamed: R456B1.2, U456.17 (B1)
unnamed: R456C1.2, U456.16 (B2)
unnamed: R456D1.2, U456.15 (B3)
unnamed: R456E1.2, U456.14 (B4)
unnamed: R456F1.2, U456.13 (B5)
unnamed: R456G1.2, U456.12 (B6)
unnamed: R456H1.2, U456.11 (B7)
unnamed: R457A1.2, U457.18 (B0)
unnamed: R457B1.2, U457.17 (B1)
unnamed: R457C1.2, U457.16 (B2)
unnamed: R457D1.2, U457.15 (B3)
unnamed: R457E1.2, U457.14 (B4)
unnamed: R457F1.2, U457.13 (B5)
unnamed: R457G1.2, U457.12 (B6)
unnamed: R457H1.2, U457.11 (B7)
unnamed: R458.1, U710.6
unnamed: R458A1.1, U458.13 (B5)
unnamed: R458B1.1, U458.12 (B6)
unnamed: R500.2, U450.22 (SCLK)
unnamed: R501.2, U450.23 (C140)
unnamed: R502.2, U450.26 (SOG)
unnamed: R503.2, U450.43 (C280)
unnamed: R504.1, U450.21 (_MLD)
unnamed: R505.2, U450.28 (ZD)
unnamed: R506.1, U459.10 (Sd), U460.15 (_BLANK)
unnamed: R506.2, U450.27 (BLANK)
unnamed: R507.1, U458.14 (B4)
unnamed: R508.2, U450.58 (_BURST)
unnamed: R509.1, U460.42 (FSA)
unnamed: R513.1, U458.11 (B7)
unnamed: R515.2, U450.11 (WIDE)
unnamed: R520.2, U450.38 (B7)
unnamed: R521.2, U450.37 (B6)
unnamed: R522.2, U450.36 (B5)
unnamed: R523.2, U450.35 (B4)
unnamed: R524.2, U450.34 (B3)
unnamed: R525.2, U450.32 (B2)
unnamed: R526.2, U450.31 (B1)
unnamed: R527.2, U450.29 (B0)
unnamed: R528.2, U450.47 (G7)
unnamed: R529.2, U450.46 (G6)
unnamed: R530.2, U450.45 (G5)
unnamed: R531.2, U450.44 (G4)
unnamed: R532.2, U450.42 (G3)
unnamed: R533.2, U450.41 (G2)
unnamed: R534.2, U450.40 (G1)
unnamed: R535.2, U450.39 (G0)
unnamed: R536.2, U450.57 (R7)
unnamed: R537.2, U450.55 (R6)
unnamed: R538.2, U450.54 (R5)
unnamed: R539.2, U450.52 (R4)
unnamed: R540.2, U450.51 (R3)
unnamed: R541.2, U450.50 (R2)
unnamed: R542.2, U450.49 (R1)
unnamed: R543.2, U450.48 (R0)
unnamed: R545.2, U458.1 (A->B)
unnamed: R546.2, U458.19 (CE)
unnamed: R547.1, U459.4 (Sd)
unnamed: R548.1, U459.1 (Cd)
PIXELSW: R507.2; also elsewhere on the board
RGA1: U450.19 (RGA1); also elsewhere on the board
RGA2: U450.18 (RGA2); also elsewhere on the board
RGA3: U450.17 (RGA3); also elsewhere on the board
RGA4: U450.16 (RGA4); also elsewhere on the board
RGA5: U450.15 (RGA5); also elsewhere on the board
RGA6: U450.14 (RGA6); also elsewhere on the board
RGA7: U450.13 (RGA7); also elsewhere on the board
RGA8: U450.12 (RGA8); also elsewhere on the board
RGB0: R457H1.1, RP461.9 (R8); also elsewhere on the board
RGB1: R457G1.1, RP461.8 (R7); also elsewhere on the board
RGB2: R457F1.1, RP461.7 (R6); also elsewhere on the board
RGB3: R457E1.1, RP461.6 (R5); also elsewhere on the board
RGB4: R457D1.1, RP461.5 (R4); also elsewhere on the board
RGB5: R457C1.1, RP461.4 (R3); also elsewhere on the board
RGB6: R457B1.1, RP461.3 (R2); also elsewhere on the board
RGB7: R457A1.1, RP461.2 (R1); also elsewhere on the board
RGB8: R456H1.1, RP462.9 (R8); also elsewhere on the board
RGB9: R456G1.1, RP462.8 (R7); also elsewhere on the board
RGB10: R456F1.1, RP462.7 (R6); also elsewhere on the board
RGB11: R456E1.1, RP462.6 (R5); also elsewhere on the board
RGB12: R456D1.1, RP462.5 (R4); also elsewhere on the board
RGB13: R456C1.1, RP462.4 (R3); also elsewhere on the board
RGB14: R456B1.1, RP462.3 (R2); also elsewhere on the board
RGB15: R456A1.1, RP462.2 (R1); also elsewhere on the board
RGB16: R455H1.1, RP463.9 (R8); also elsewhere on the board
RGB17: R455G1.1, RP463.8 (R7); also elsewhere on the board
RGB18: R455F1.1, RP463.7 (R6); also elsewhere on the board
RGB19: R455E1.1, RP463.6 (R5); also elsewhere on the board
RGB20: R455D1.1, RP463.5 (R4); also elsewhere on the board
RGB21: R455C1.1, RP463.4 (R3); also elsewhere on the board
RGB22: R455B1.1, RP463.3 (R2); also elsewhere on the board
RGB23: R455A1.1, RP463.2 (R1); also elsewhere on the board
SCLK: R500.1; also elsewhere on the board
SOG: R502.1; also elsewhere on the board
VCDAC: U459.3 (Cp); also elsewhere on the board
XCLK: R458.2; also elsewhere on the board
ZD: R505.1, U458.6 (A4)
_BCSYNC: R458A1.2; also elsewhere on the board
_BHS: R458B1.2; also elsewhere on the board
_C4: C485.1, R451.1; also elsewhere on the board
_CCCAS: U450.9 (_CAS); also elsewhere on the board
_CSYNC: U458.7 (A5), U460.16 (_SYNC); also elsewhere on the board
_HSYNC: R463.1, R514.2, U458.8 (A6); also elsewhere on the board
_IORST: U450.24 (_RST); also elsewhere on the board
_MLD: R504.2; also elsewhere on the board
_VC3: U459.2 (D); also elsewhere on the board
_VSYNC: R464.1; also elsewhere on the board

Notes on the sheet:
Bauteil U710 weglassen?
Obsolete, ersetzbar durch??? QFP Version ist wohl mit Sync-on-Green intern verschaltet

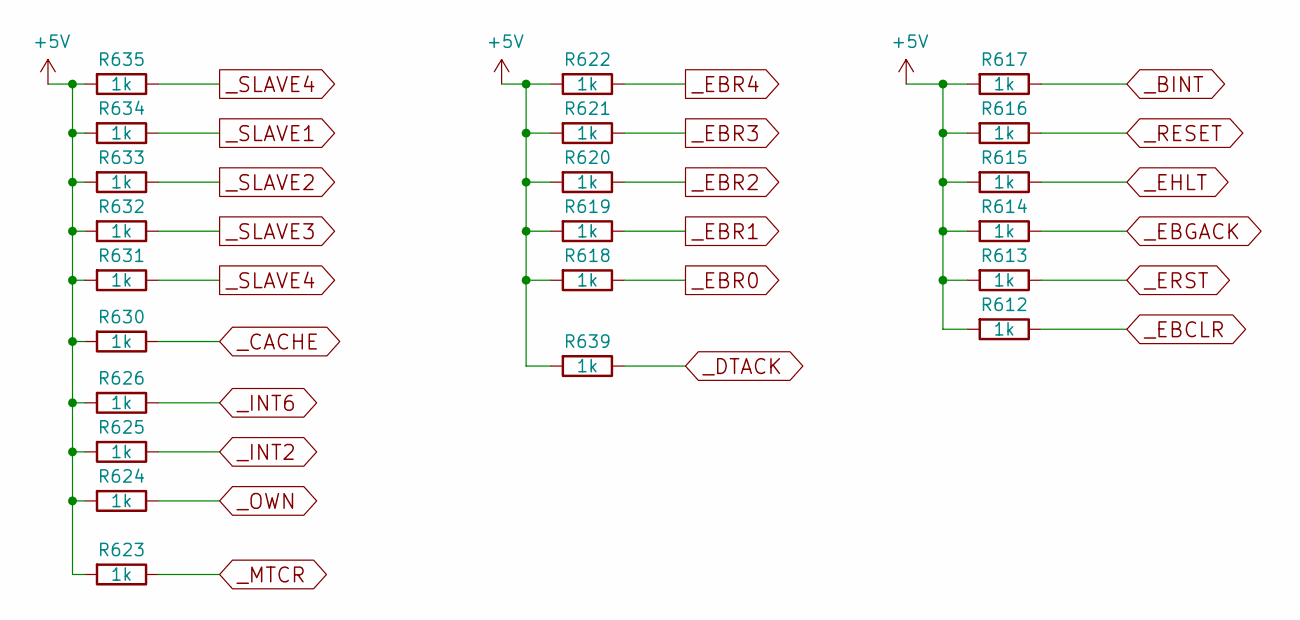
[picture p11: schematic ATX4000-P10.sch]

Parts:
R612, R613, R614, R615, R616, R617, R618, R619, R620, R621, R622, R623, R624, R625, R626, R630, R631, R632, R633, R634, R635, R639: 1k; R_0805_HandSoldering

Connections:
+5V: R612.2, R613.2, R614.2, R615.2, R616.2, R617.2, R618.2, R619.2, R620.2, R621.2, R622.2, R623.2, R624.2, R625.2, R626.2, R630.2, R631.2, R632.2, R633.2, R634.2, R635.2, R639.2; also elsewhere on the board
_BINT: R617.1; also elsewhere on the board
_CACHE: R630.1; also elsewhere on the board
_DTACK: R639.1; also elsewhere on the board
_EBCLR: R612.1; also elsewhere on the board
_EBGACK: R614.1; also elsewhere on the board
_EBR0: R618.1; also elsewhere on the board
_EBR1: R619.1; also elsewhere on the board
_EBR2: R620.1; also elsewhere on the board
_EBR3: R621.1; also elsewhere on the board
_EBR4: R622.1; also elsewhere on the board
_EHLT: R615.1; also elsewhere on the board
_ERST: R613.1; also elsewhere on the board
_INT2: R625.1; also elsewhere on the board
_INT6: R626.1; also elsewhere on the board
_MTCR: R623.1; also elsewhere on the board
_OWN: R624.1; also elsewhere on the board
_RESET: R616.1; also elsewhere on the board
_SLAVE1: R634.1; also elsewhere on the board
_SLAVE2: R633.1; also elsewhere on the board
_SLAVE3: R632.1; also elsewhere on the board
_SLAVE4: R631.1, R635.1; also elsewhere on the board

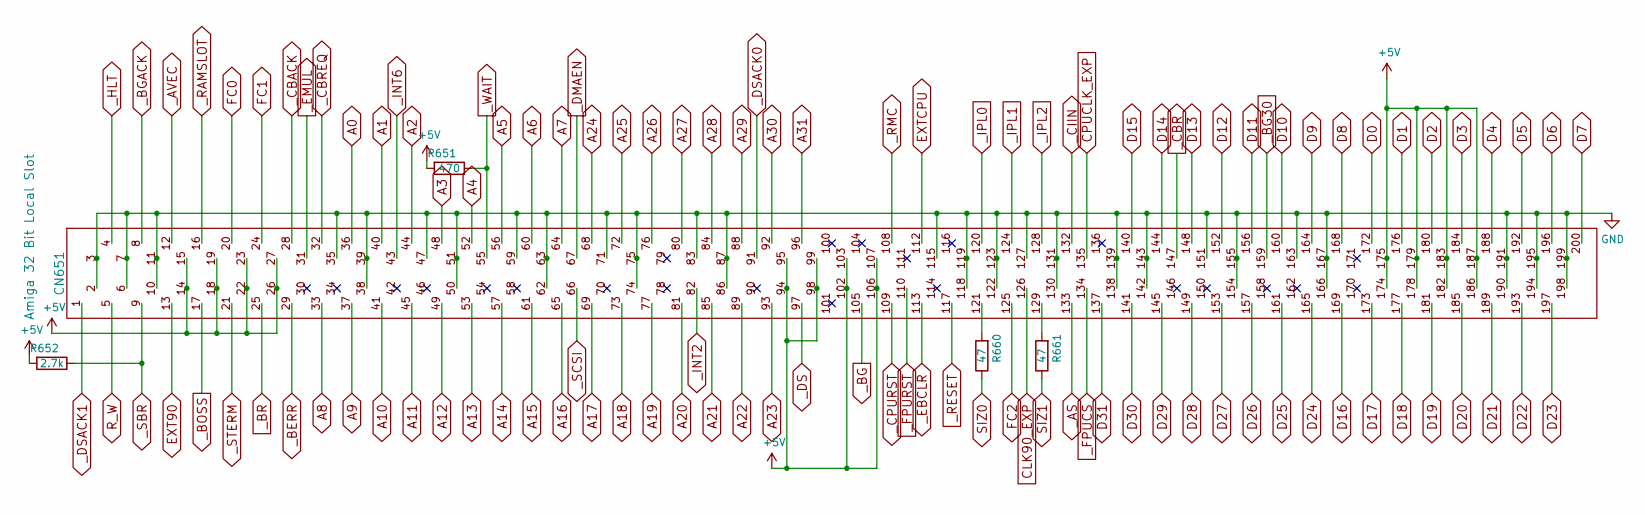
[picture p12: schematic ATX4000-P11.sch]

Parts:
CN651: Amiga 32 Bit Local Slot; 8807-200-170S-F
R651: 470; R_0805_HandSoldering
R652: 2.7k; R_0805_HandSoldering
R660, R661: 47; R_0805_HandSoldering

Connections:
+5V: CN651.14, CN651.15, CN651.18, CN651.19, CN651.22, CN651.23, CN651.26, CN651.27, CN651.94, CN651.95, CN651.98, CN651.99, CN651.102, CN651.103, CN651.106, CN651.107, CN651.174, CN651.175, CN651.178, CN651.179, CN651.182, CN651.183, CN651.186, CN651.187, R651.2, R652.2; also elsewhere on the board
A0: CN651.36; also elsewhere on the board
A1: CN651.40; also elsewhere on the board
A2: CN651.44; also elsewhere on the board
A3: CN651.48; also elsewhere on the board
A4: CN651.52; also elsewhere on the board
A5: CN651.56; also elsewhere on the board
A6: CN651.60; also elsewhere on the board
A7: CN651.64; also elsewhere on the board
A8: CN651.33; also elsewhere on the board
A9: CN651.37; also elsewhere on the board
A10: CN651.41; also elsewhere on the board
A11: CN651.45; also elsewhere on the board
A12: CN651.49; also elsewhere on the board
A13: CN651.53; also elsewhere on the board
A14: CN651.57; also elsewhere on the board
A15: CN651.61; also elsewhere on the board
A16: CN651.65; also elsewhere on the board
A17: CN651.69; also elsewhere on the board
A18: CN651.73; also elsewhere on the board
A19: CN651.77; also elsewhere on the board
A20: CN651.81; also elsewhere on the board
A21: CN651.85; also elsewhere on the board
A22: CN651.89; also elsewhere on the board
A23: CN651.93; also elsewhere on the board
A24: CN651.68; also elsewhere on the board
A25: CN651.72; also elsewhere on the board
A26: CN651.76; also elsewhere on the board
A27: CN651.80; also elsewhere on the board
A28: CN651.84; also elsewhere on the board
A29: CN651.88; also elsewhere on the board
A30: CN651.92; also elsewhere on the board
A31: CN651.96; also elsewhere on the board
CLK90_EXP: CN651.126; also elsewhere on the board
CPUCLK_EXP: CN651.135; also elsewhere on the board
D0: CN651.172; also elsewhere on the board
D1: CN651.176; also elsewhere on the board
D2: CN651.180; also elsewhere on the board
D3: CN651.184; also elsewhere on the board
D4: CN651.188; also elsewhere on the board
D5: CN651.192; also elsewhere on the board
D6: CN651.196; also elsewhere on the board
D7: CN651.200; also elsewhere on the board
D8: CN651.168; also elsewhere on the board
D9: CN651.164; also elsewhere on the board
D10: CN651.160; also elsewhere on the board
D11: CN651.156; also elsewhere on the board
D12: CN651.152; also elsewhere on the board
D13: CN651.148; also elsewhere on the board
D14: CN651.144; also elsewhere on the board
D15: CN651.140; also elsewhere on the board
D16: CN651.169; also elsewhere on the board
D17: CN651.173; also elsewhere on the board
D18: CN651.177; also elsewhere on the board
D19: CN651.181; also elsewhere on the board
D20: CN651.185; also elsewhere on the board
D21: CN651.189; also elsewhere on the board
D22: CN651.193; also elsewhere on the board
D23: CN651.197; also elsewhere on the board
D24: CN651.165; also elsewhere on the board
D25: CN651.161; also elsewhere on the board
D26: CN651.157; also elsewhere on the board
D27: CN651.153; also elsewhere on the board
D28: CN651.149; also elsewhere on the board
D29: CN651.145; also elsewhere on the board
D30: CN651.141; also elsewhere on the board
D31: CN651.137; also elsewhere on the board
EXT90: CN651.13; also elsewhere on the board
EXTCPU: CN651.112; also elsewhere on the board
FC0: CN651.20; also elsewhere on the board
FC1: CN651.24; also elsewhere on the board
FC2: CN651.125; also elsewhere on the board
GND: CN651.2, CN651.3, CN651.6, CN651.7, CN651.10, CN651.11, CN651.35, CN651.38, CN651.39, CN651.47, CN651.50, CN651.51, CN651.59, CN651.62, CN651.63, CN651.71, CN651.74, CN651.75, CN651.83, CN651.86, CN651.87, CN651.115, CN651.118, CN651.119, CN651.122, CN651.123, CN651.127, CN651.130, CN651.131, CN651.138, CN651.139, CN651.142, CN651.143, CN651.151, CN651.154, CN651.155, CN651.163, CN651.166, CN651.167, CN651.190, CN651.191, CN651.194, CN651.195, CN651.198, CN651.199; also elsewhere on the board
unnamed: CN651.121, R660.2
unnamed: CN651.129, R661.2
R_W: CN651.5; also elsewhere on the board
SIZ0: R660.1; also elsewhere on the board
SIZ1: R661.1; also elsewhere on the board
_AS: CN651.133; also elsewhere on the board
_AVEC: CN651.12; also elsewhere on the board
_BERR: CN651.29; also elsewhere on the board
_BG: CN651.105; also elsewhere on the board
_BG30: CN651.159; also elsewhere on the board
_BGACK: CN651.8; also elsewhere on the board
_BOSS: CN651.17; also elsewhere on the board
_BR: CN651.25; also elsewhere on the board
_CBACK: CN651.28; also elsewhere on the board
_CBR: CN651.147; also elsewhere on the board
_CBREQ: CN651.32; also elsewhere on the board
_CIIN: CN651.132; also elsewhere on the board
_CPURST: CN651.109; also elsewhere on the board
_DMAEN: CN651.67; also elsewhere on the board
_DS: CN651.97; also elsewhere on the board
_DSACK0: CN651.91; also elsewhere on the board
_DSACK1: CN651.1; also elsewhere on the board
_EBCLR: CN651.113; also elsewhere on the board
_EMUL: CN651.31; also elsewhere on the board
_FPUCS: CN651.134; also elsewhere on the board
_FPURST: CN651.110; also elsewhere on the board
_HLT: CN651.4; also elsewhere on the board
_INT2: CN651.82; also elsewhere on the board
_INT6: CN651.43; also elsewhere on the board
_IPL0: CN651.120; also elsewhere on the board
_IPL1: CN651.124; also elsewhere on the board
_IPL2: CN651.128; also elsewhere on the board
_RAMSLOT: CN651.16; also elsewhere on the board
_RESET: CN651.117; also elsewhere on the board
_RMC: CN651.108; also elsewhere on the board
_SBR: CN651.9, R652.1; also elsewhere on the board
_SCSI: CN651.66; also elsewhere on the board
_STERM: CN651.21; also elsewhere on the board
_WAIT: CN651.55, R651.1; also elsewhere on the board
