elenachenchen/A4000-ATX/ATX4000.kicad_pcb

## KiCad design ATX4000.kicad_pcb (continued)

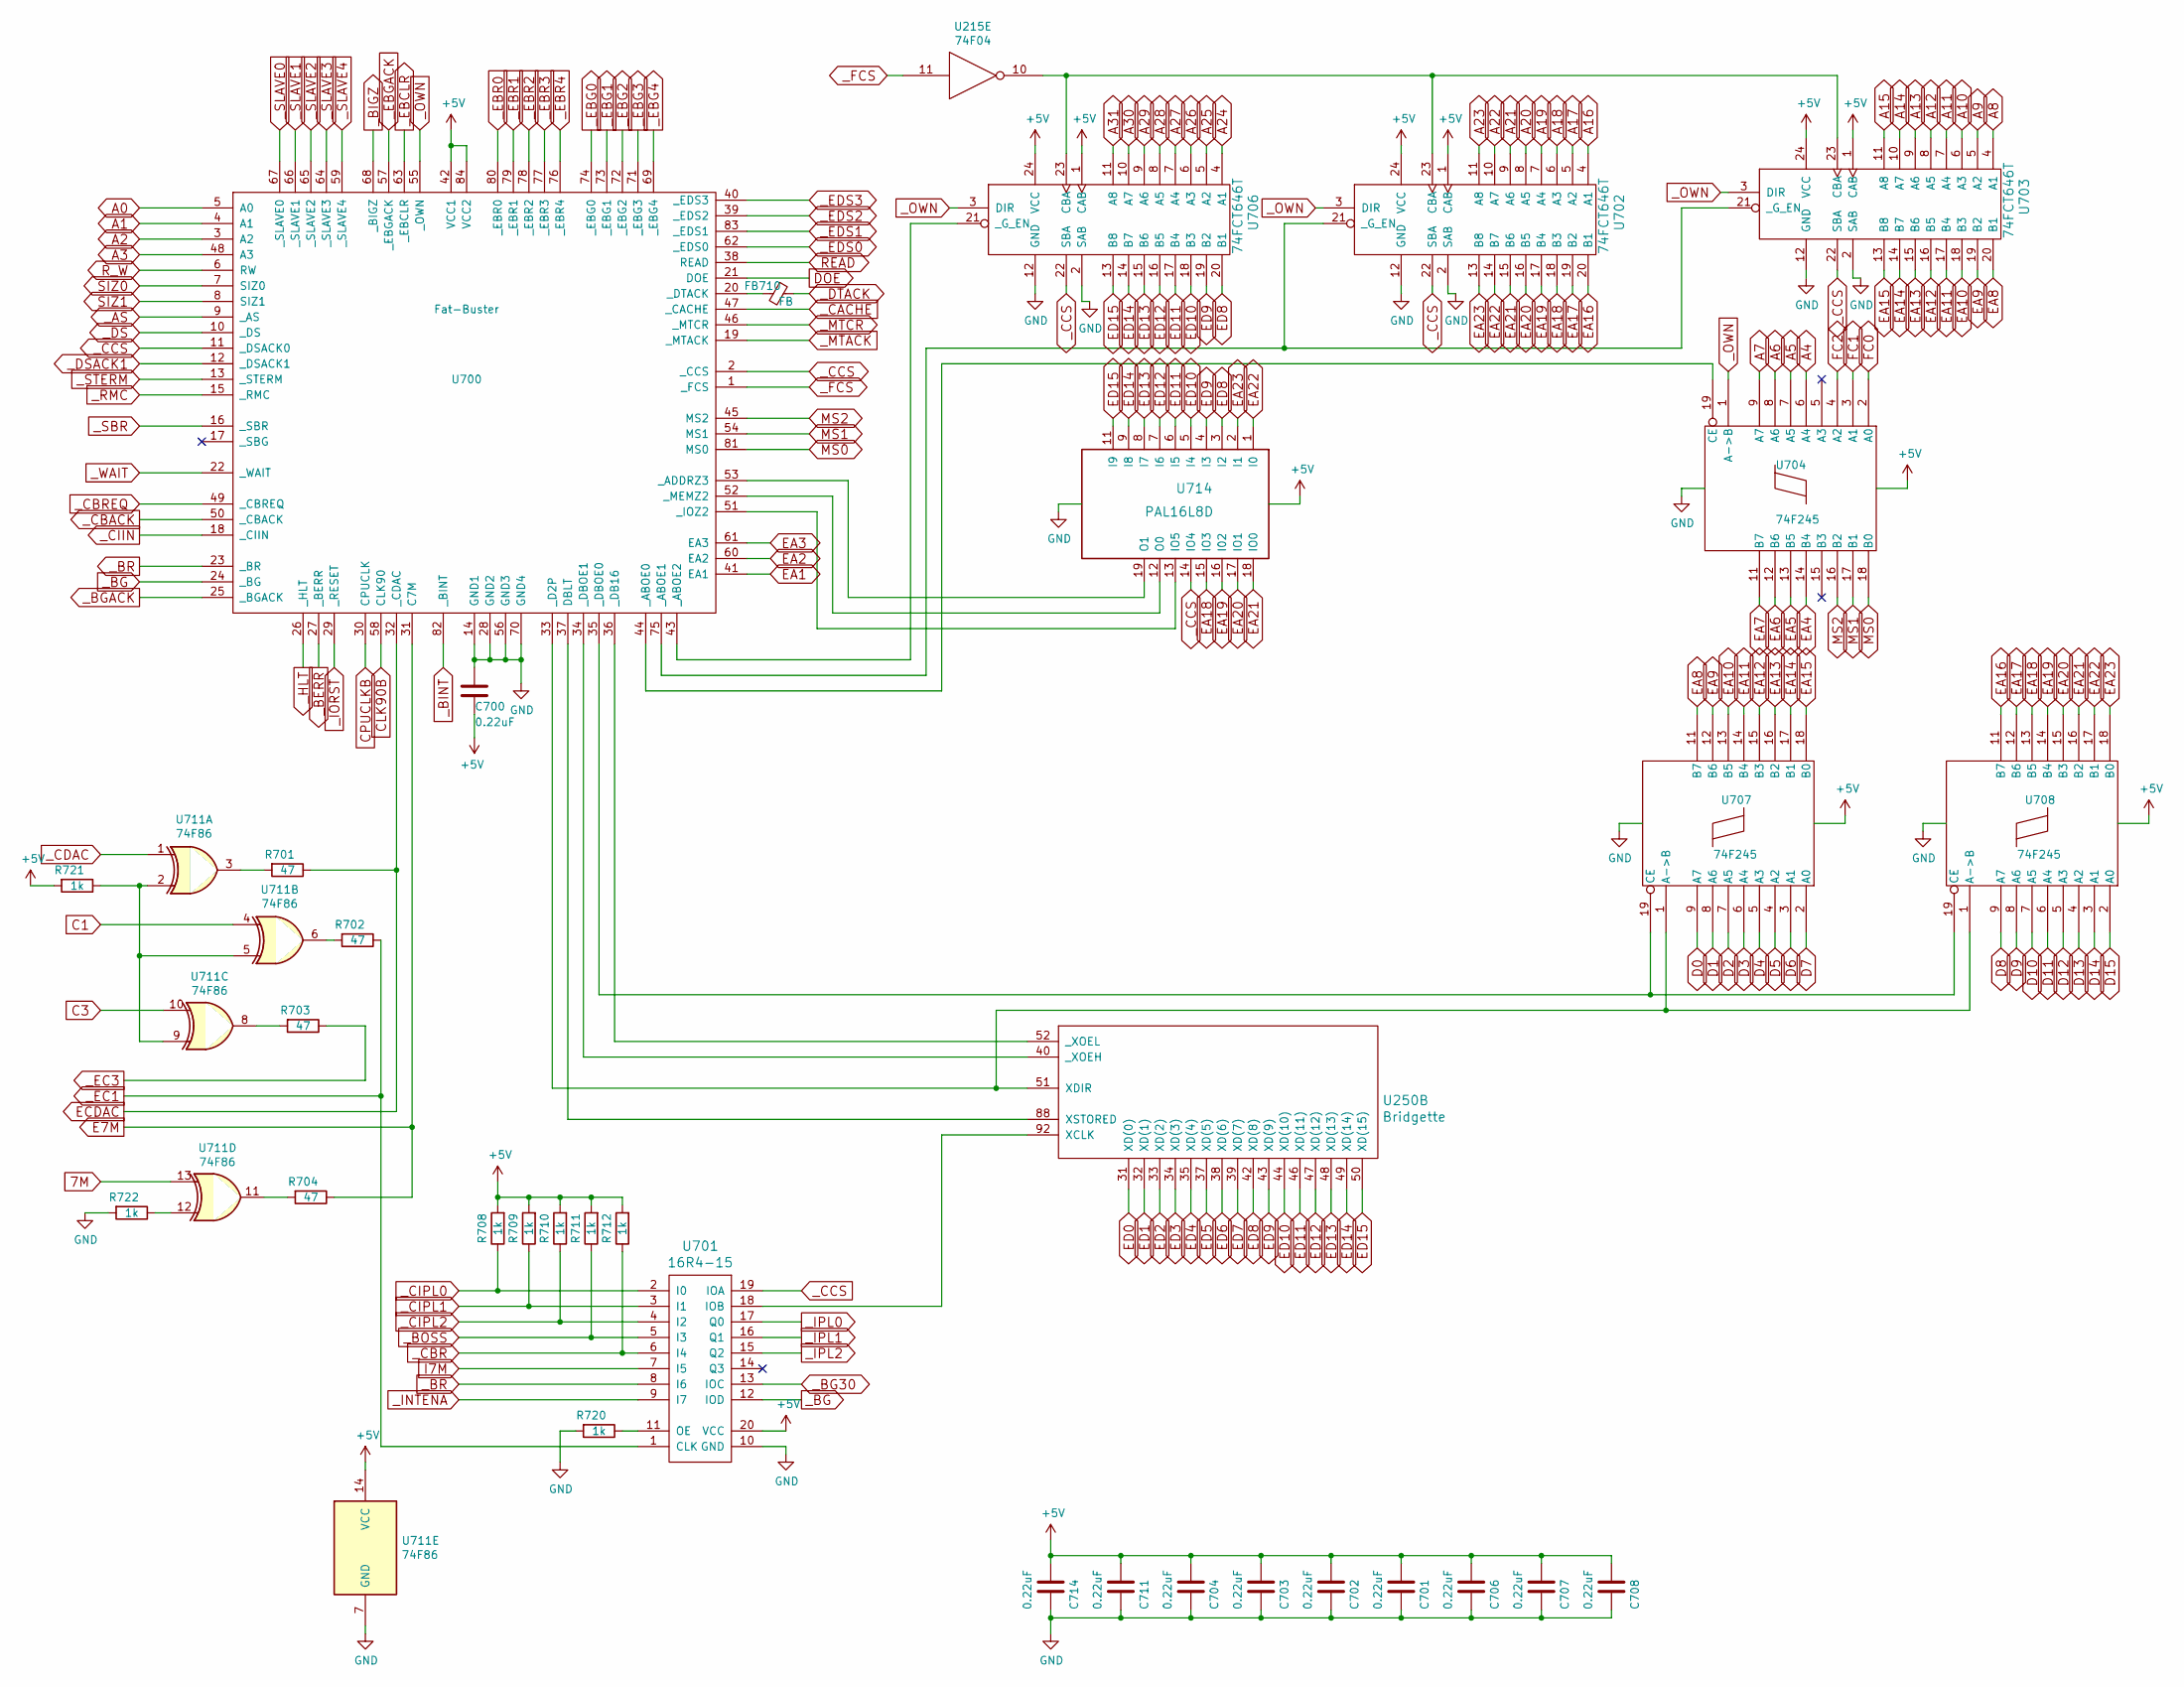
[picture p13: schematic ATX4000-P12.sch]

Parts:
C700, C701, C702, C703, C704, C706, C707, C708, C711, C714: 0.22uF; C_0805_HandSoldering
FB710: FB; C_0805_HandSoldering
R701, R702, R703, R704: 47; R_0805_HandSoldering
R708, R709, R710, R711, R712, R720, R721, R722: 1k; R_0805_HandSoldering
U215: 74F04
U250: Bridgette
U700: Fat-Buster; PLCC-84_SMD-Socket
U701: 16R4-15; PLCC-20_SMD-Socket
U702, U703, U706: 74FCT646T; SOIC-24W_7.5x15.4mm_Pitch1.27mm
U704, U707, U708: 74F245; SOIC-20W_7.5x12.8mm_Pitch1.27mm
U711: 74F86; SOIC-14_3.9x8.7mm_Pitch1.27mm
U714: PAL16L8D; PLCC-20_SMD-Socket

Connections:
7M: U711.13; also elsewhere on the board
+5V: C700.2, C701.1, C702.1, C703.1, C704.1, C706.1, C707.1, C708.1, C711.1, C714.1, R708.2, R709.2, R710.2, R711.2, R712.2, R721.2, U215.14 (VCC), U700.42 (VCC1), U700.84 (VCC2), U701.20 (VCC), U702.1 (CAB), U702.24 (VCC), U703.1 (CAB), U703.24 (VCC), U704.20 (VCC), U706.1 (CAB), U706.24 (VCC), U707.20 (VCC), U708.20 (VCC), U711.14 (VCC), U714.20 (VCC); also elsewhere on the board
A0: U700.5 (A0); also elsewhere on the board
A1: U700.4 (A1); also elsewhere on the board
A2: U700.3 (A2); also elsewhere on the board
A3: U700.48 (A3); also elsewhere on the board
A4: U704.6 (A4); also elsewhere on the board
A5: U704.7 (A5); also elsewhere on the board
A6: U704.8 (A6); also elsewhere on the board
A7: U704.9 (A7); also elsewhere on the board
A8: U703.4 (A1); also elsewhere on the board
A9: U703.5 (A2); also elsewhere on the board
A10: U703.6 (A3); also elsewhere on the board
A11: U703.7 (A4); also elsewhere on the board
A12: U703.8 (A5); also elsewhere on the board
A13: U703.9 (A6); also elsewhere on the board
A14: U703.10 (A7); also elsewhere on the board
A15: U703.11 (A8); also elsewhere on the board
A16: U702.4 (A1); also elsewhere on the board
A17: U702.5 (A2); also elsewhere on the board
A18: U702.6 (A3); also elsewhere on the board
A19: U702.7 (A4); also elsewhere on the board
A20: U702.8 (A5); also elsewhere on the board
A21: U702.9 (A6); also elsewhere on the board
A22: U702.10 (A7); also elsewhere on the board
A23: U702.11 (A8); also elsewhere on the board
A24: U706.4 (A1); also elsewhere on the board
A25: U706.5 (A2); also elsewhere on the board
A26: U706.6 (A3); also elsewhere on the board
A27: U706.7 (A4); also elsewhere on the board
A28: U706.8 (A5); also elsewhere on the board
A29: U706.9 (A6); also elsewhere on the board
A30: U706.10 (A7); also elsewhere on the board
A31: U706.11 (A8); also elsewhere on the board
C1: U711.4; also elsewhere on the board
C3: U711.10; also elsewhere on the board
CLK90B: U700.58 (CLK90); also elsewhere on the board
CPUCLKB: U700.30 (CPUCLK); also elsewhere on the board
D0: U707.9 (A7); also elsewhere on the board
D1: U707.8 (A6); also elsewhere on the board
D2: U707.7 (A5); also elsewhere on the board
D3: U707.6 (A4); also elsewhere on the board
D4: U707.5 (A3); also elsewhere on the board
D5: U707.4 (A2); also elsewhere on the board
D6: U707.3 (A1); also elsewhere on the board
D7: U707.2 (A0); also elsewhere on the board
D8: U708.9 (A7); also elsewhere on the board
D9: U708.8 (A6); also elsewhere on the board
D10: U708.7 (A5); also elsewhere on the board
D11: U708.6 (A4); also elsewhere on the board
D12: U708.5 (A3); also elsewhere on the board
D13: U708.4 (A2); also elsewhere on the board
D14: U708.3 (A1); also elsewhere on the board
D15: U708.2 (A0); also elsewhere on the board
DOE: U700.21 (DOE); also elsewhere on the board
E7M: R704.1, U700.31 (C7M); also elsewhere on the board
EA1: U700.41 (EA1); also elsewhere on the board
EA2: U700.60 (EA2); also elsewhere on the board
EA3: U700.61 (EA3); also elsewhere on the board
EA4: U704.14 (B4); also elsewhere on the board
EA5: U704.13 (B5); also elsewhere on the board
EA6: U704.12 (B6); also elsewhere on the board
EA7: U704.11 (B7); also elsewhere on the board
EA8: U703.20 (B1), U707.11 (B7); also elsewhere on the board
EA9: U703.19 (B2), U707.12 (B6); also elsewhere on the board
EA10: U703.18 (B3), U707.13 (B5); also elsewhere on the board
EA11: U703.17 (B4), U707.14 (B4); also elsewhere on the board
EA12: U703.16 (B5), U707.15 (B3); also elsewhere on the board
EA13: U703.15 (B6), U707.16 (B2); also elsewhere on the board
EA14: U703.14 (B7), U707.17 (B1); also elsewhere on the board
EA15: U703.13 (B8), U707.18 (B0); also elsewhere on the board
EA16: U702.20 (B1), U708.11 (B7); also elsewhere on the board
EA17: U702.19 (B2), U708.12 (B6); also elsewhere on the board
EA18: U702.18 (B3), U708.13 (B5), U714.15 (IO3); also elsewhere on the board
EA19: U702.17 (B4), U708.14 (B4), U714.16 (I02); also elsewhere on the board
EA20: U702.16 (B5), U708.15 (B3), U714.17 (IO1); also elsewhere on the board
EA21: U702.15 (B6), U708.16 (B2), U714.18 (IO0); also elsewhere on the board
EA22: U702.14 (B7), U708.17 (B1), U714.1 (I0); also elsewhere on the board
EA23: U702.13 (B8), U708.18 (B0), U714.2 (I1); also elsewhere on the board
ECDAC: R701.1, U700.32 (_CDAC); also elsewhere on the board
ED0: U250.31 (XD(0)); also elsewhere on the board
ED1: U250.32 (XD(1)); also elsewhere on the board
ED2: U250.33 (XD(2)); also elsewhere on the board
ED3: U250.34 (XD(3)); also elsewhere on the board
ED4: U250.35 (XD(4)); also elsewhere on the board
ED5: U250.37 (XD(5)); also elsewhere on the board
ED6: U250.38 (XD(6)); also elsewhere on the board
ED7: U250.39 (XD(7)); also elsewhere on the board
ED8: U250.42 (XD(8)), U706.20 (B1), U714.3 (I2); also elsewhere on the board
ED9: U250.43 (XD(9)), U706.19 (B2), U714.4 (I3); also elsewhere on the board
ED10: U250.44 (XD(10)), U706.18 (B3), U714.5 (I4); also elsewhere on the board
ED11: U250.46 (XD(11)), U706.17 (B4), U714.6 (I5); also elsewhere on the board
ED12: U250.47 (XD(12)), U706.16 (B5), U714.7 (I6); also elsewhere on the board
ED13: U250.48 (XD(13)), U706.15 (B6), U714.8 (I7); also elsewhere on the board
ED14: U250.49 (XD(14)), U706.14 (B7), U714.9 (I8); also elsewhere on the board
ED15: U250.50 (XD(15)), U706.13 (B8), U714.11 (I9); also elsewhere on the board
FC0: U704.2 (A0); also elsewhere on the board
FC1: U704.3 (A1); also elsewhere on the board
FC2: U704.4 (A2); also elsewhere on the board
GND: C700.1, C701.2, C702.2, C703.2, C704.2, C706.2, C707.2, C708.2, C711.2, C714.2, R720.2, R722.2, U215.7 (GND), U700.14 (GND1), U700.28 (GND2), U700.56 (GND3), U700.70 (GND4), U701.10 (GND), U702.2 (SAB), U702.12 (GND), U703.2 (SAB), U703.12 (GND), U704.10 (GND), U706.2 (SAB), U706.12 (GND), U707.10 (GND), U708.10 (GND), U711.7 (GND), U714.10 (GND); also elsewhere on the board
I7M: U701.7 (I5); also elsewhere on the board
MS0: U700.81 (MS0), U704.18 (B0); also elsewhere on the board
MS1: U700.54 (MS1), U704.17 (B1); also elsewhere on the board
MS2: U700.45 (MS2), U704.16 (B2); also elsewhere on the board
unnamed: FB710.2, U700.20 (_DTACK)
unnamed: R701.2, U711.3
unnamed: R702.2, U711.6
unnamed: R703.2, U711.8
unnamed: R704.2, U711.11
unnamed: R720.1, U701.11 (OE)
unnamed: R721.1, U711.2, U711.5, U711.9
unnamed: R722.1, U711.12
unnamed: U215.10, U702.23 (CBA), U703.23 (CBA), U706.23 (CBA)
unnamed: U250.40 (_XOEH), U700.34 (_DBOE1)
unnamed: U250.51 (XDIR), U700.33 (_D2P), U707.1 (A->B), U708.1 (A->B)
unnamed: U250.52 (_XOEL), U700.36 (_DB16)
unnamed: U250.88 (XSTORED), U700.37 (DBLT)
unnamed: U250.92 (XCLK), U701.18 (IOB)
unnamed: U700.35 (_DBOE0), U707.19 (CE), U708.19 (CE)
unnamed: U700.43 (_ABOE2), U706.21 (_G_EN)
unnamed: U700.44 (_ABOE0), U704.19 (CE)
unnamed: U700.51 (_IOZ2), U714.13 (IO5)
unnamed: U700.52 (_MEMZ2), U714.12 (O0)
unnamed: U700.53 (_ADDRZ3), U714.19 (O1)
unnamed: U700.75 (_ABOE1), U702.21 (_G_EN), U703.21 (_G_EN)
READ: U700.38 (READ); also elsewhere on the board
R_W: U700.6 (RW); also elsewhere on the board
SIZ0: U700.7 (SIZ0); also elsewhere on the board
SIZ1: U700.8 (SIZ1); also elsewhere on the board
_AS: U700.9 (_AS); also elsewhere on the board
_BERR: U700.27 (_BERR); also elsewhere on the board
_BG: U700.24 (_BG), U701.12 (IOD); also elsewhere on the board
_BG30: U701.13 (IOC); also elsewhere on the board
_BGACK: U700.25 (_BGACK); also elsewhere on the board
_BIGZ: U700.68 (_BIGZ); also elsewhere on the board
_BINT: U700.82 (_BINT); also elsewhere on the board
_BOSS: R711.1, U701.5 (I3); also elsewhere on the board
_BR: U700.23 (_BR), U701.8 (I6); also elsewhere on the board
_CACHE: U700.47 (_CACHE); also elsewhere on the board
_CBACK: U700.50 (_CBACK); also elsewhere on the board
_CBR: R712.1, U701.6 (I4); also elsewhere on the board
_CBREQ: U700.49 (_CBREQ); also elsewhere on the board
_CCS: U700.2 (_CCS), U700.11 (_DSACK0), U701.19 (IOA), U702.22 (SBA), U703.22 (SBA), U706.22 (SBA), U714.14 (IO4); also elsewhere on the board
_CDAC: U711.1; also elsewhere on the board
_CIIN: U700.18 (_CIIN); also elsewhere on the board
_CIPL0: R708.1, U701.2 (I0); also elsewhere on the board
_CIPL1: R709.1, U701.3 (I1); also elsewhere on the board
_CIPL2: R710.1, U701.4 (I2); also elsewhere on the board
_DS: U700.10 (_DS); also elsewhere on the board
_DSACK1: U700.12 (_DSACK1); also elsewhere on the board
_DTACK: FB710.1; also elsewhere on the board
_EBCLR: U700.63 (_EBCLR); also elsewhere on the board
_EBG0: U700.74 (_EBG0); also elsewhere on the board
_EBG1: U700.73 (_EBG1); also elsewhere on the board
_EBG2: U700.72 (_EBG2); also elsewhere on the board
_EBG3: U700.71 (_EBG3); also elsewhere on the board
_EBG4: U700.69 (_EBG4); also elsewhere on the board
_EBGACK: U700.57 (_EBGACK); also elsewhere on the board
_EBR0: U700.80 (_EBR0); also elsewhere on the board
_EBR1: U700.79 (_EBR1); also elsewhere on the board
_EBR2: U700.78 (_EBR2); also elsewhere on the board
_EBR3: U700.77 (_EBR3); also elsewhere on the board
_EBR4: U700.76 (_EBR4); also elsewhere on the board
_EC1: R702.1, U701.1 (CLK); also elsewhere on the board
_EC3: R703.1; also elsewhere on the board
_EDS0: U700.62 (_EDS0); also elsewhere on the board
_EDS1: U700.83 (_EDS1); also elsewhere on the board
_EDS2: U700.39 (_EDS2); also elsewhere on the board
_EDS3: U700.40 (_EDS3); also elsewhere on the board
_FCS: U215.11, U700.1 (_FCS); also elsewhere on the board
_HLT: U700.26 (_HLT); also elsewhere on the board
_INTENA: U701.9 (I7); also elsewhere on the board
_IORST: U700.29 (_RESET); also elsewhere on the board
_IPL0: U701.17 (Q0); also elsewhere on the board
_IPL1: U701.16 (Q1); also elsewhere on the board
_IPL2: U701.15 (Q2); also elsewhere on the board
_MTACK: U700.19 (_MTACK); also elsewhere on the board
_MTCR: U700.46 (_MTCR); also elsewhere on the board
_OWN: U700.55 (_OWN), U702.3 (DIR), U703.3 (DIR), U704.1 (A->B), U706.3 (DIR); also elsewhere on the board
_RMC: U700.15 (_RMC); also elsewhere on the board
_SBR: U700.16 (_SBR); also elsewhere on the board
_SLAVE0: U700.67 (_SLAVE0); also elsewhere on the board
_SLAVE1: U700.66 (_SLAVE1); also elsewhere on the board
_SLAVE2: U700.65 (_SLAVE2); also elsewhere on the board
_SLAVE3: U700.64 (_SLAVE3); also elsewhere on the board
_SLAVE4: U700.59 (_SLAVE4); also elsewhere on the board
_STERM: U700.13 (_STERM); also elsewhere on the board
_WAIT: U700.22 (_WAIT); also elsewhere on the board

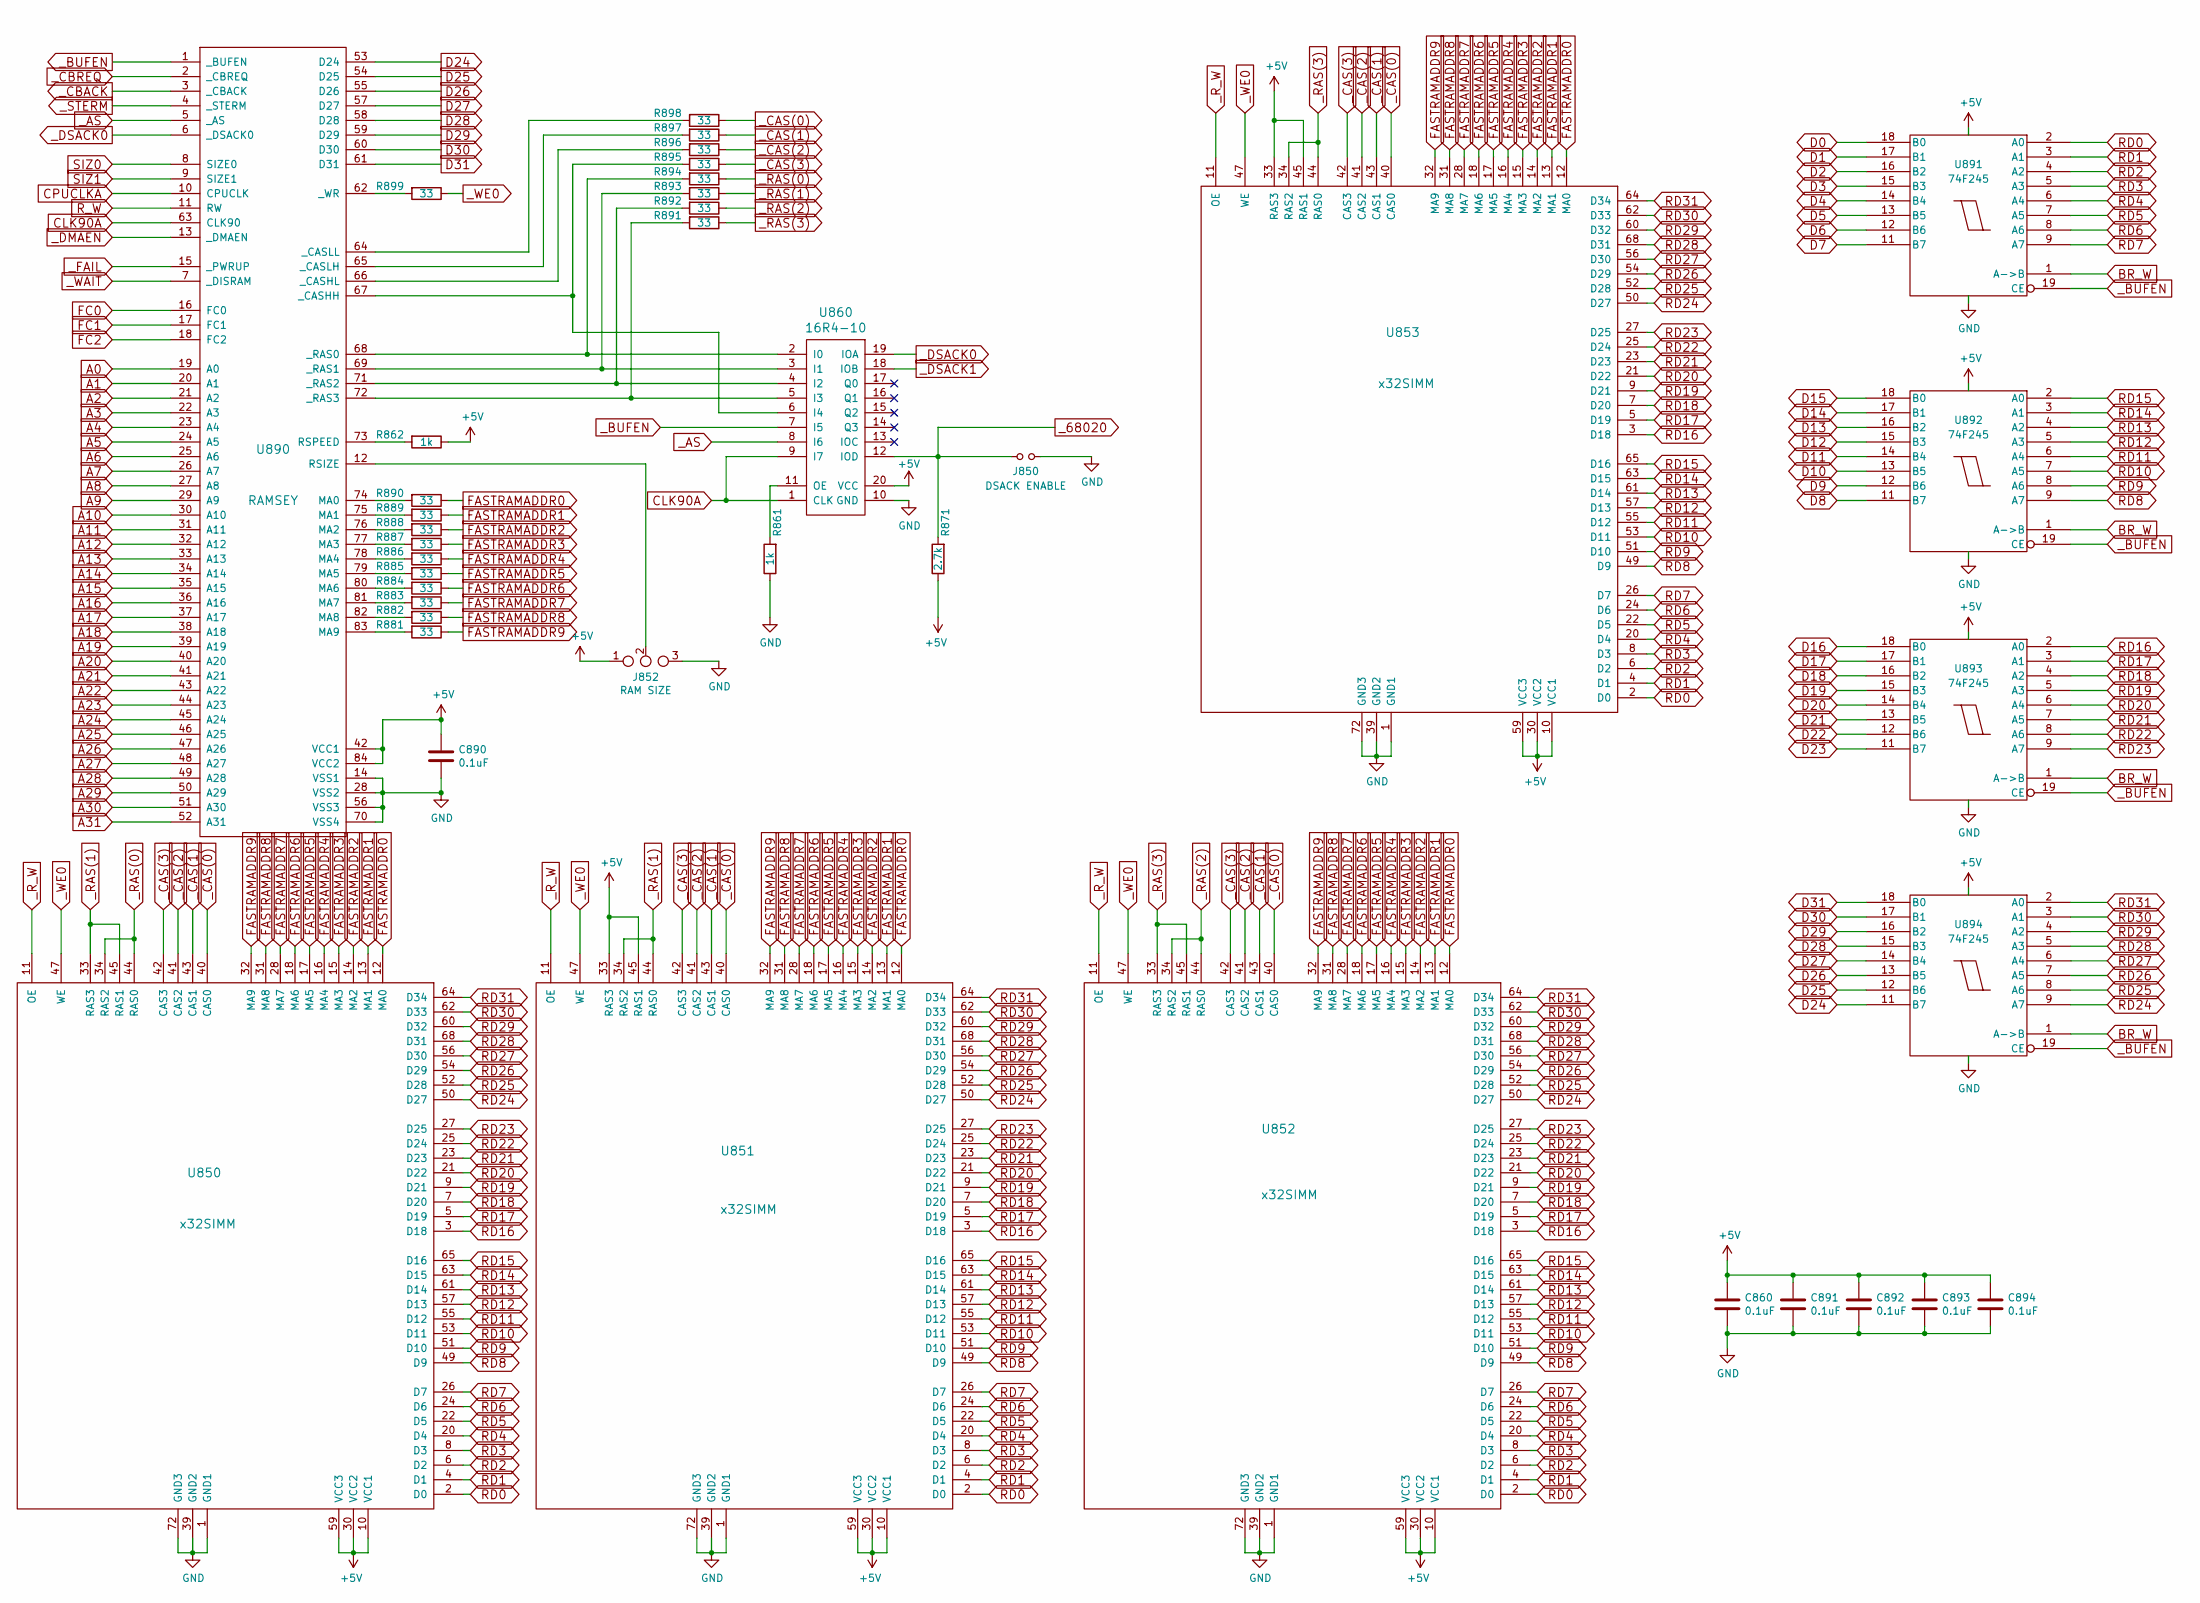
[picture p14: schematic ATX4000-P13.sch]

Parts:
C860, C890, C891, C892, C893, C894: 0.1uF; C_0805_HandSoldering
J850: DSACK ENABLE; Pin_Header_Straight_1x02_Pitch2.54mm
J852: RAM SIZE; Pin_Header_Straight_1x03_Pitch2.54mm
R861, R862: 1k; R_0805_HandSoldering
R871: 2.7k; R_0805_HandSoldering
R881, R882, R883, R884, R885, R886, R887, R888, R889, R890, R891, R892, R893, R894, R895, R896, R897, R898, R899: 33; R_0805_HandSoldering
U850, U851, U852, U853: x32SIMM; SIMM
U860: 16R4-10; PLCC-20_SMD-Socket
U890: RAMSEY; PLCC-84_SMD-Socket
U891, U892, U893, U894: 74F245; SOIC-20W_7.5x12.8mm_Pitch1.27mm

Connections:
+5V: C860.1, C890.1, C891.1, C892.1, C893.1, C894.1, J852.1, R862.1, R871.1, U850.10 (VCC1), U850.30 (VCC2), U850.59 (VCC3), U851.10 (VCC1), U851.30 (VCC2), U851.33 (RAS3), U851.45 (RAS1), U851.59 (VCC3), U852.10 (VCC1), U852.30 (VCC2), U852.59 (VCC3), U853.10 (VCC1), U853.30 (VCC2), U853.33 (RAS3), U853.45 (RAS1), U853.59 (VCC3), U860.20 (VCC), U890.42 (VCC1), U890.84 (VCC2), U891.20 (VCC), U892.20 (VCC), U893.20 (VCC), U894.20 (VCC); also elsewhere on the board
A0: U890.19 (A0); also elsewhere on the board
A1: U890.20 (A1); also elsewhere on the board
A2: U890.21 (A2); also elsewhere on the board
A3: U890.22 (A3); also elsewhere on the board
A4: U890.23 (A4); also elsewhere on the board
A5: U890.24 (A5); also elsewhere on the board
A6: U890.25 (A6); also elsewhere on the board
A7: U890.26 (A7); also elsewhere on the board
A8: U890.27 (A8); also elsewhere on the board
A9: U890.29 (A9); also elsewhere on the board
A10: U890.30 (A10); also elsewhere on the board
A11: U890.31 (A11); also elsewhere on the board
A12: U890.32 (A12); also elsewhere on the board
A13: U890.33 (A13); also elsewhere on the board
A14: U890.34 (A14); also elsewhere on the board
A15: U890.35 (A15); also elsewhere on the board
A16: U890.36 (A16); also elsewhere on the board
A17: U890.37 (A17); also elsewhere on the board
A18: U890.38 (A18); also elsewhere on the board
A19: U890.39 (A19); also elsewhere on the board
A20: U890.40 (A20); also elsewhere on the board
A21: U890.41 (A21); also elsewhere on the board
A22: U890.43 (A22); also elsewhere on the board
A23: U890.44 (A23); also elsewhere on the board
A24: U890.45 (A24); also elsewhere on the board
A25: U890.46 (A25); also elsewhere on the board
A26: U890.47 (A26); also elsewhere on the board
A27: U890.48 (A27); also elsewhere on the board
A28: U890.49 (A28); also elsewhere on the board
A29: U890.50 (A29); also elsewhere on the board
A30: U890.51 (A30); also elsewhere on the board
A31: U890.52 (A31); also elsewhere on the board
BR_W: U891.1 (A->B), U892.1 (A->B), U893.1 (A->B), U894.1 (A->B); also elsewhere on the board
CLK90A: U860.1 (CLK), U860.9 (I7), U890.63 (CLK90); also elsewhere on the board
CPUCLKA: U890.10 (CPUCLK); also elsewhere on the board
D0: U891.18 (B0); also elsewhere on the board
D1: U891.17 (B1); also elsewhere on the board
D2: U891.16 (B2); also elsewhere on the board
D3: U891.15 (B3); also elsewhere on the board
D4: U891.14 (B4); also elsewhere on the board
D5: U891.13 (B5); also elsewhere on the board
D6: U891.12 (B6); also elsewhere on the board
D7: U891.11 (B7); also elsewhere on the board
D8: U892.11 (B7); also elsewhere on the board
D9: U892.12 (B6); also elsewhere on the board
D10: U892.13 (B5); also elsewhere on the board
D11: U892.14 (B4); also elsewhere on the board
D12: U892.15 (B3); also elsewhere on the board
D13: U892.16 (B2); also elsewhere on the board
D14: U892.17 (B1); also elsewhere on the board
D15: U892.18 (B0); also elsewhere on the board
D16: U893.18 (B0); also elsewhere on the board
D17: U893.17 (B1); also elsewhere on the board
D18: U893.16 (B2); also elsewhere on the board
D19: U893.15 (B3); also elsewhere on the board
D20: U893.14 (B4); also elsewhere on the board
D21: U893.13 (B5); also elsewhere on the board
D22: U893.12 (B6); also elsewhere on the board
D23: U893.11 (B7); also elsewhere on the board
D24: U890.53 (D24), U894.11 (B7); also elsewhere on the board
D25: U890.54 (D25), U894.12 (B6); also elsewhere on the board
D26: U890.55 (D26), U894.13 (B5); also elsewhere on the board
D27: U890.57 (D27), U894.14 (B4); also elsewhere on the board
D28: U890.58 (D28), U894.15 (B3); also elsewhere on the board
D29: U890.59 (D29), U894.16 (B2); also elsewhere on the board
D30: U890.60 (D30), U894.17 (B1); also elsewhere on the board
D31: U890.61 (D31), U894.18 (B0); also elsewhere on the board
FASTRAMADDR0: R890.1, U850.12 (MA0), U851.12 (MA0), U852.12 (MA0), U853.12 (MA0)
FASTRAMADDR1: R889.1, U850.13 (MA1), U851.13 (MA1), U852.13 (MA1), U853.13 (MA1)
FASTRAMADDR2: R888.1, U850.14 (MA2), U851.14 (MA2), U852.14 (MA2), U853.14 (MA2)
FASTRAMADDR3: R887.1, U850.15 (MA3), U851.15 (MA3), U852.15 (MA3), U853.15 (MA3)
FASTRAMADDR4: R886.1, U850.16 (MA4), U851.16 (MA4), U852.16 (MA4), U853.16 (MA4)
FASTRAMADDR5: R885.1, U850.17 (MA5), U851.17 (MA5), U852.17 (MA5), U853.17 (MA5)
FASTRAMADDR6: R884.1, U850.18 (MA6), U851.18 (MA6), U852.18 (MA6), U853.18 (MA6)
FASTRAMADDR7: R883.1, U850.28 (MA7), U851.28 (MA7), U852.28 (MA7), U853.28 (MA7)
FASTRAMADDR8: R882.1, U850.31 (MA8), U851.31 (MA8), U852.31 (MA8), U853.31 (MA8)
FASTRAMADDR9: R881.1, U850.32 (MA9), U851.32 (MA9), U852.32 (MA9), U853.32 (MA9)
FC0: U890.16 (FC0); also elsewhere on the board
FC1: U890.17 (FC1); also elsewhere on the board
FC2: U890.18 (FC2); also elsewhere on the board
GND: C860.2, C890.2, C891.2, C892.2, C893.2, C894.2, J850.2, J852.3, R861.1, U850.1 (GND1), U850.39 (GND2), U850.72 (GND3), U851.1 (GND1), U851.39 (GND2), U851.72 (GND3), U852.1 (GND1), U852.39 (GND2), U852.72 (GND3), U853.1 (GND1), U853.39 (GND2), U853.72 (GND3), U860.10 (GND), U890.14 (VSS1), U890.28 (VSS2), U890.56 (VSS3), U890.70 (VSS4), U891.10 (GND), U892.10 (GND), U893.10 (GND), U894.10 (GND); also elsewhere on the board
unnamed: J852.2, U890.12 (RSIZE)
unnamed: R861.2, U860.11 (OE)
unnamed: R862.2, U890.73 (RSPEED)
unnamed: R881.2, U890.83 (MA9)
unnamed: R882.2, U890.82 (MA8)
unnamed: R883.2, U890.81 (MA7)
unnamed: R884.2, U890.80 (MA6)
unnamed: R885.2, U890.79 (MA5)
unnamed: R886.2, U890.78 (MA4)
unnamed: R887.2, U890.77 (MA3)
unnamed: R888.2, U890.76 (MA2)
unnamed: R889.2, U890.75 (MA1)
unnamed: R890.2, U890.74 (MA0)
unnamed: R891.2, U860.5 (I3), U890.72 (_RAS3)
unnamed: R892.2, U860.4 (I2), U890.71 (_RAS2)
unnamed: R893.2, U860.3 (I1), U890.69 (_RAS1)
unnamed: R894.2, U860.2 (I0), U890.68 (_RAS0)
unnamed: R895.2, U860.6 (I4), U890.67 (_CASHH)
unnamed: R896.2, U890.66 (_CASHL)
unnamed: R897.2, U890.65 (_CASLH)
unnamed: R898.2, U890.64 (_CASLL)
unnamed: R899.2, U890.62 (_WR)
RD0: U850.2 (D0), U851.2 (D0), U852.2 (D0), U853.2 (D0), U891.2 (A0)
RD1: U850.4 (D1), U851.4 (D1), U852.4 (D1), U853.4 (D1), U891.3 (A1)
RD2: U850.6 (D2), U851.6 (D2), U852.6 (D2), U853.6 (D2), U891.4 (A2)
RD3: U850.8 (D3), U851.8 (D3), U852.8 (D3), U853.8 (D3), U891.5 (A3)
RD4: U850.20 (D4), U851.20 (D4), U852.20 (D4), U853.20 (D4), U891.6 (A4)
RD5: U850.22 (D5), U851.22 (D5), U852.22 (D5), U853.22 (D5), U891.7 (A5)
RD6: U850.24 (D6), U851.24 (D6), U852.24 (D6), U853.24 (D6), U891.8 (A6)
RD7: U850.26 (D7), U851.26 (D7), U852.26 (D7), U853.26 (D7), U891.9 (A7)
RD8: U850.49 (D9), U851.49 (D9), U852.49 (D9), U853.49 (D9), U892.9 (A7)
RD9: U850.51 (D10), U851.51 (D10), U852.51 (D10), U853.51 (D10), U892.8 (A6)
RD10: U850.53 (D11), U851.53 (D11), U852.53 (D11), U853.53 (D11), U892.7 (A5)
RD11: U850.55 (D12), U851.55 (D12), U852.55 (D12), U853.55 (D12), U892.6 (A4)
RD12: U850.57 (D13), U851.57 (D13), U852.57 (D13), U853.57 (D13), U892.5 (A3)
RD13: U850.61 (D14), U851.61 (D14), U852.61 (D14), U853.61 (D14), U892.4 (A2)
RD14: U850.63 (D15), U851.63 (D15), U852.63 (D15), U853.63 (D15), U892.3 (A1)
RD15: U850.65 (D16), U851.65 (D16), U852.65 (D16), U853.65 (D16), U892.2 (A0)
RD16: U850.3 (D18), U851.3 (D18), U852.3 (D18), U853.3 (D18), U893.2 (A0)
RD17: U850.5 (D19), U851.5 (D19), U852.5 (D19), U853.5 (D19), U893.3 (A1)
RD18: U850.7 (D20), U851.7 (D20), U852.7 (D20), U853.7 (D20), U893.4 (A2)
RD19: U850.9 (D21), U851.9 (D21), U852.9 (D21), U853.9 (D21), U893.5 (A3)
RD20: U850.21 (D22), U851.21 (D22), U852.21 (D22), U853.21 (D22), U893.6 (A4)
RD21: U850.23 (D23), U851.23 (D23), U852.23 (D23), U853.23 (D23), U893.7 (A5)
RD22: U850.25 (D24), U851.25 (D24), U852.25 (D24), U853.25 (D24), U893.8 (A6)
RD23: U850.27 (D25), U851.27 (D25), U852.27 (D25), U853.27 (D25), U893.9 (A7)
RD24: U850.50 (D27), U851.50 (D27), U852.50 (D27), U853.50 (D27), U894.9 (A7)
RD25: U850.52 (D28), U851.52 (D28), U852.52 (D28), U853.52 (D28), U894.8 (A6)
RD26: U850.54 (D29), U851.54 (D29), U852.54 (D29), U853.54 (D29), U894.7 (A5)
RD27: U850.56 (D30), U851.56 (D30), U852.56 (D30), U853.56 (D30), U894.6 (A4)
RD28: U850.68 (D31), U851.68 (D31), U852.68 (D31), U853.68 (D31), U894.5 (A3)
RD29: U850.60 (D32), U851.60 (D32), U852.60 (D32), U853.60 (D32), U894.4 (A2)
RD30: U850.62 (D33), U851.62 (D33), U852.62 (D33), U853.62 (D33), U894.3 (A1)
RD31: U850.64 (D34), U851.64 (D34), U852.64 (D34), U853.64 (D34), U894.2 (A0)
R_W: U890.11 (RW); also elsewhere on the board
SIZ0: U890.8 (SIZE0); also elsewhere on the board
SIZ1: U890.9 (SIZE1); also elsewhere on the board
_68020: J850.1, R871.2, U860.12 (IOD); also elsewhere on the board
_AS: U860.8 (I6), U890.5 (_AS); also elsewhere on the board
_BUFEN: U860.7 (I5), U890.1 (_BUFEN), U891.19 (CE), U892.19 (CE), U893.19 (CE), U894.19 (CE)
_CAS(0): R898.1, U850.40 (CAS0), U851.40 (CAS0), U852.40 (CAS0), U853.40 (CAS0)
_CAS(1): R897.1, U850.43 (CAS1), U851.43 (CAS1), U852.43 (CAS1), U853.43 (CAS1)
_CAS(2): R896.1, U850.41 (CAS2), U851.41 (CAS2), U852.41 (CAS2), U853.41 (CAS2)
_CAS(3): R895.1, U850.42 (CAS3), U851.42 (CAS3), U852.42 (CAS3), U853.42 (CAS3)
_CBACK: U890.3 (_CBACK); also elsewhere on the board
_CBREQ: U890.2 (_CBREQ); also elsewhere on the board
_DMAEN: U890.13 (_DMAEN); also elsewhere on the board
_DSACK0: U860.19 (IOA), U890.6 (_DSACK0); also elsewhere on the board
_DSACK1: U860.18 (IOB); also elsewhere on the board
_FAIL: U890.15 (_PWRUP); also elsewhere on the board
_RAS(0): R894.1, U850.34 (RAS2), U850.44 (RAS0)
_RAS(1): R893.1, U850.33 (RAS3), U850.45 (RAS1), U851.34 (RAS2), U851.44 (RAS0)
_RAS(2): R892.1, U852.34 (RAS2), U852.44 (RAS0)
_RAS(3): R891.1, U852.33 (RAS3), U852.45 (RAS1), U853.34 (RAS2), U853.44 (RAS0)
_R_W: U850.11 (OE), U851.11 (OE), U852.11 (OE), U853.11 (OE); also elsewhere on the board
_STERM: U890.4 (_STERM); also elsewhere on the board
_WAIT: U890.7 (_DISRAM); also elsewhere on the board
_WE0: R899.1, U850.47 (WE), U851.47 (WE), U852.47 (WE), U853.47 (WE)
