elenachenchen/A4000-ATX/ATX4000.kicad_pcb

## KiCad design ATX4000.kicad_pcb (continued)

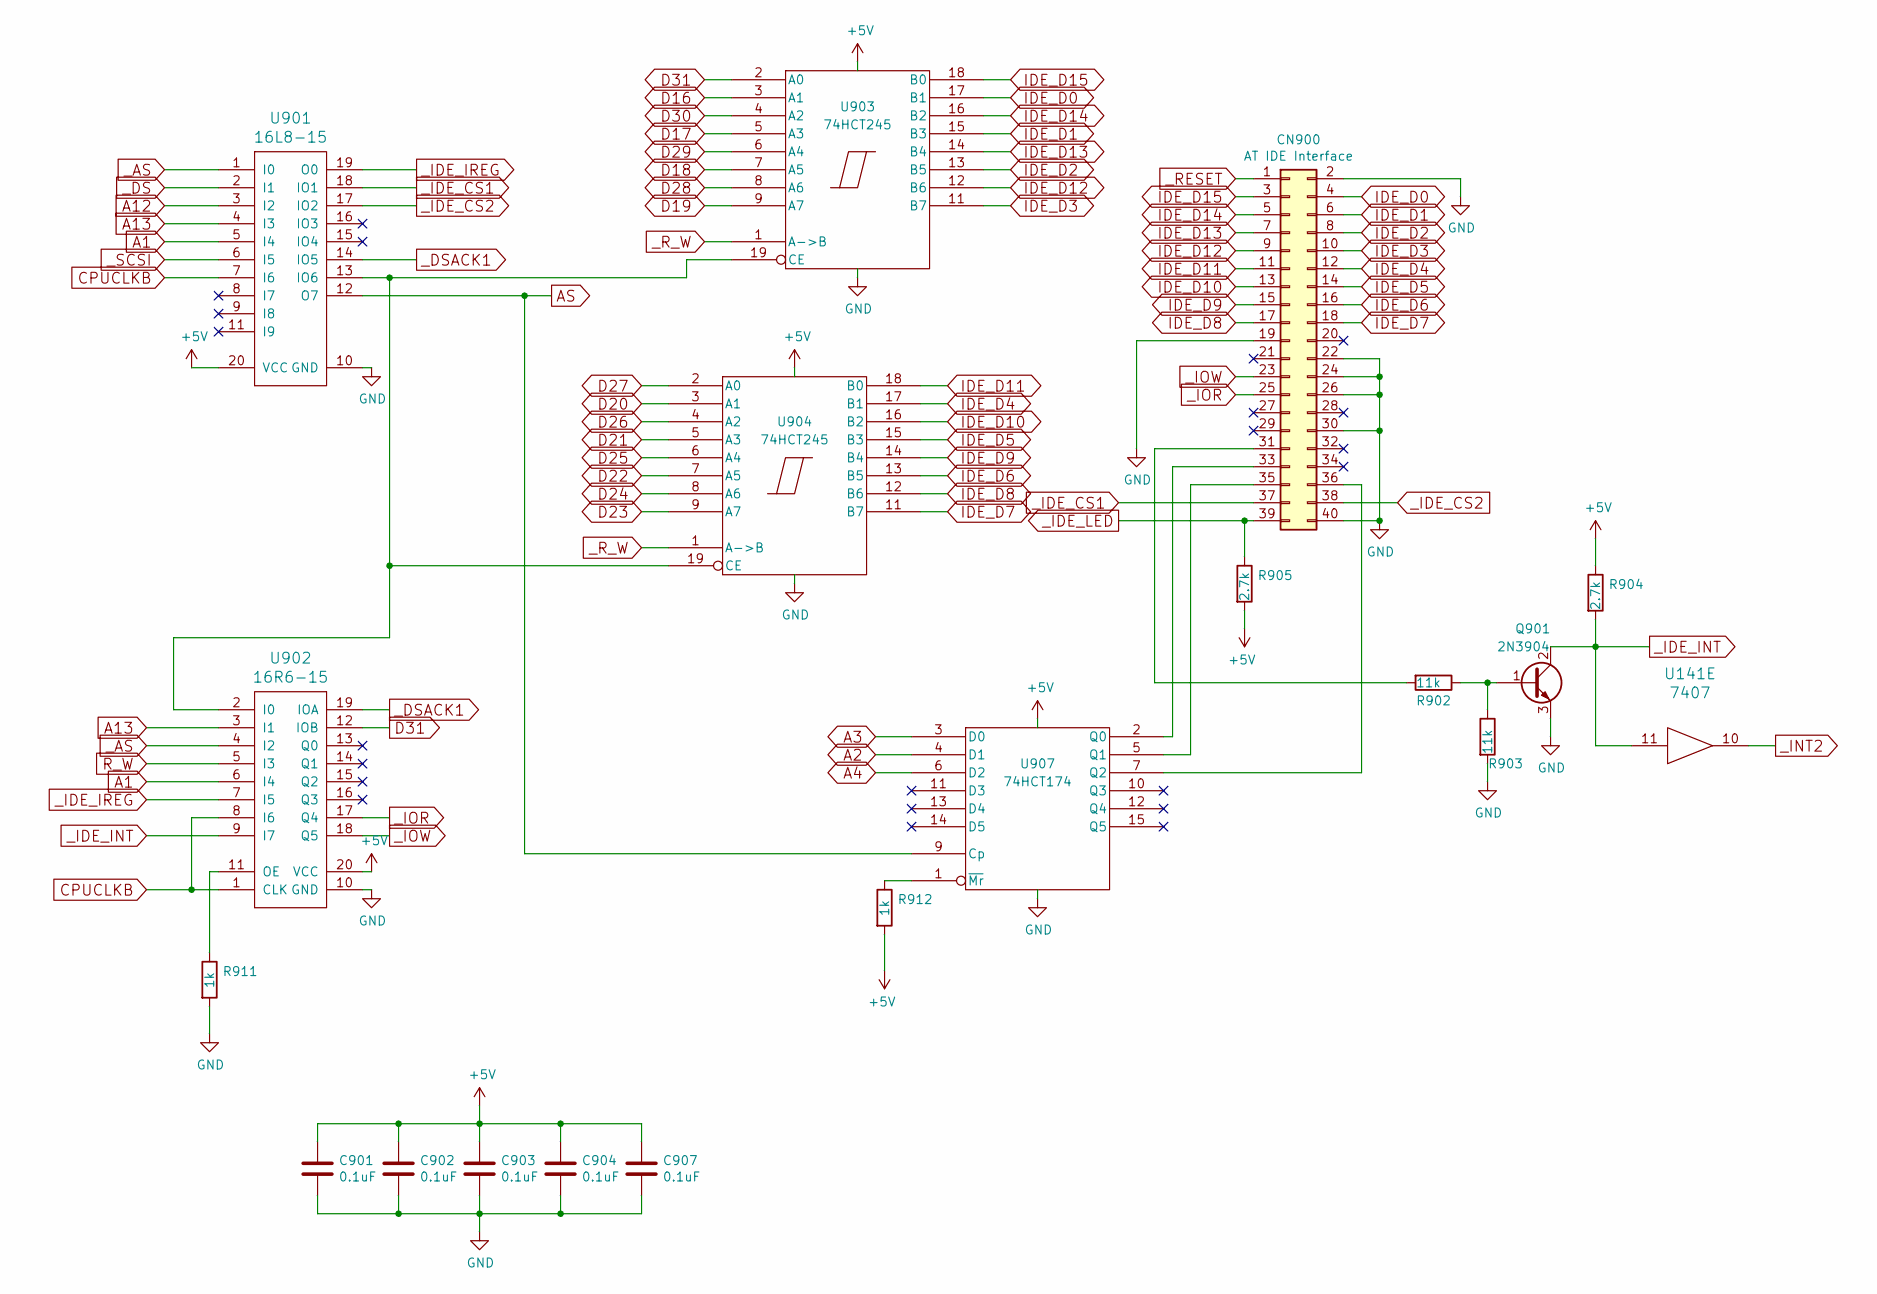
[picture p15: schematic ATX4000-P14.sch]

Parts:
C901, C902, C903, C904, C907: 0.1uF; C_0805_HandSoldering
CN900: AT IDE Interface; Pin_Header_Straight_2x20_Pitch2.54mm
Q901: 2N3904; SOT-223-3_TabPin2
R902, R903: 11k; R_0805_HandSoldering
R904, R905: 2.7k; R_0805_HandSoldering
R911, R912: 1k; R_0805_HandSoldering
U141: 7407
U901: 16L8-15; PLCC-20_SMD-Socket
U902: 16R6-15; PLCC-20_SMD-Socket
U903, U904: 74HCT245; TSSOP-20_4.4x6.5mm_Pitch0.65mm
U907: 74HCT174; SOIC-16_3.9x9.9mm_Pitch1.27mm

Connections:
+5V: C901.1, C902.1, C903.1, C904.1, C907.1, R904.1, R905.2, R912.2, U141.14 (VCC), U901.20 (VCC), U902.20 (VCC), U903.20 (VCC), U904.20 (VCC), U907.16 (VCC); also elsewhere on the board
A1: U901.5 (I4), U902.6 (I4); also elsewhere on the board
A2: U907.4 (D1); also elsewhere on the board
A3: U907.3 (D0); also elsewhere on the board
A4: U907.6 (D2); also elsewhere on the board
A12: U901.3 (I2); also elsewhere on the board
A13: U901.4 (I3), U902.3 (I1); also elsewhere on the board
AS: U901.12 (O7), U907.9 (Cp); also elsewhere on the board
CPUCLKB: U901.7 (I6), U902.1 (CLK), U902.8 (I6); also elsewhere on the board
D16: U903.3 (A1); also elsewhere on the board
D17: U903.5 (A3); also elsewhere on the board
D18: U903.7 (A5); also elsewhere on the board
D19: U903.9 (A7); also elsewhere on the board
D20: U904.3 (A1); also elsewhere on the board
D21: U904.5 (A3); also elsewhere on the board
D22: U904.7 (A5); also elsewhere on the board
D23: U904.9 (A7); also elsewhere on the board
D24: U904.8 (A6); also elsewhere on the board
D25: U904.6 (A4); also elsewhere on the board
D26: U904.4 (A2); also elsewhere on the board
D27: U904.2 (A0); also elsewhere on the board
D28: U903.8 (A6); also elsewhere on the board
D29: U903.6 (A4); also elsewhere on the board
D30: U903.4 (A2); also elsewhere on the board
D31: U902.12 (IOB), U903.2 (A0); also elsewhere on the board
GND: C901.2, C902.2, C903.2, C904.2, C907.2, CN900.2, CN900.19, CN900.22, CN900.24, CN900.26, CN900.30, CN900.40, Q901.3 (E), R903.2, R911.2, U141.7 (GND), U901.10 (GND), U902.10 (GND), U903.10 (GND), U904.10 (GND), U907.8 (GND); also elsewhere on the board
IDE_D0: CN900.4, U903.17 (B1)
IDE_D1: CN900.6, U903.15 (B3)
IDE_D2: CN900.8, U903.13 (B5)
IDE_D3: CN900.10, U903.11 (B7)
IDE_D4: CN900.12, U904.17 (B1)
IDE_D5: CN900.14, U904.15 (B3)
IDE_D6: CN900.16, U904.13 (B5)
IDE_D7: CN900.18, U904.11 (B7)
IDE_D8: CN900.17, U904.12 (B6)
IDE_D9: CN900.15, U904.14 (B4)
IDE_D10: CN900.13, U904.16 (B2)
IDE_D11: CN900.11, U904.18 (B0)
IDE_D12: CN900.9, U903.12 (B6)
IDE_D13: CN900.7, U903.14 (B4)
IDE_D14: CN900.5, U903.16 (B2)
IDE_D15: CN900.3, U903.18 (B0)
unnamed: CN900.31, R902.2
unnamed: CN900.33, U907.2 (Q0)
unnamed: CN900.35, U907.5 (Q1)
unnamed: CN900.36, U907.7 (Q2)
unnamed: Q901.1 (B), R902.1, R903.1
unnamed: R911.1, U902.11 (OE)
unnamed: R912.1, U907.1 (~Mr)
unnamed: U901.13 (IO6), U902.2 (I0), U903.19 (CE), U904.19 (CE)
R_W: U902.5 (I3); also elsewhere on the board
_AS: U901.1 (I0), U902.4 (I2); also elsewhere on the board
_DS: U901.2 (I1); also elsewhere on the board
_DSACK1: U901.14 (IO5), U902.19 (IOA); also elsewhere on the board
_IDE_CS1: CN900.37, U901.18 (IO1)
_IDE_CS2: CN900.38, U901.17 (IO2)
_IDE_INT: Q901.2 (C), R904.2, U141.11, U902.9 (I7)
_IDE_IREG: U901.19 (O0), U902.7 (I5)
_IDE_LED: CN900.39, R905.1; also elsewhere on the board
_INT2: U141.10; also elsewhere on the board
_IOR: CN900.25, U902.17 (Q4)
_IOW: CN900.23, U902.18 (Q5)
_RESET: CN900.1; also elsewhere on the board
_R_W: U903.1 (A->B), U904.1 (A->B); also elsewhere on the board
_SCSI: U901.6 (I5); also elsewhere on the board

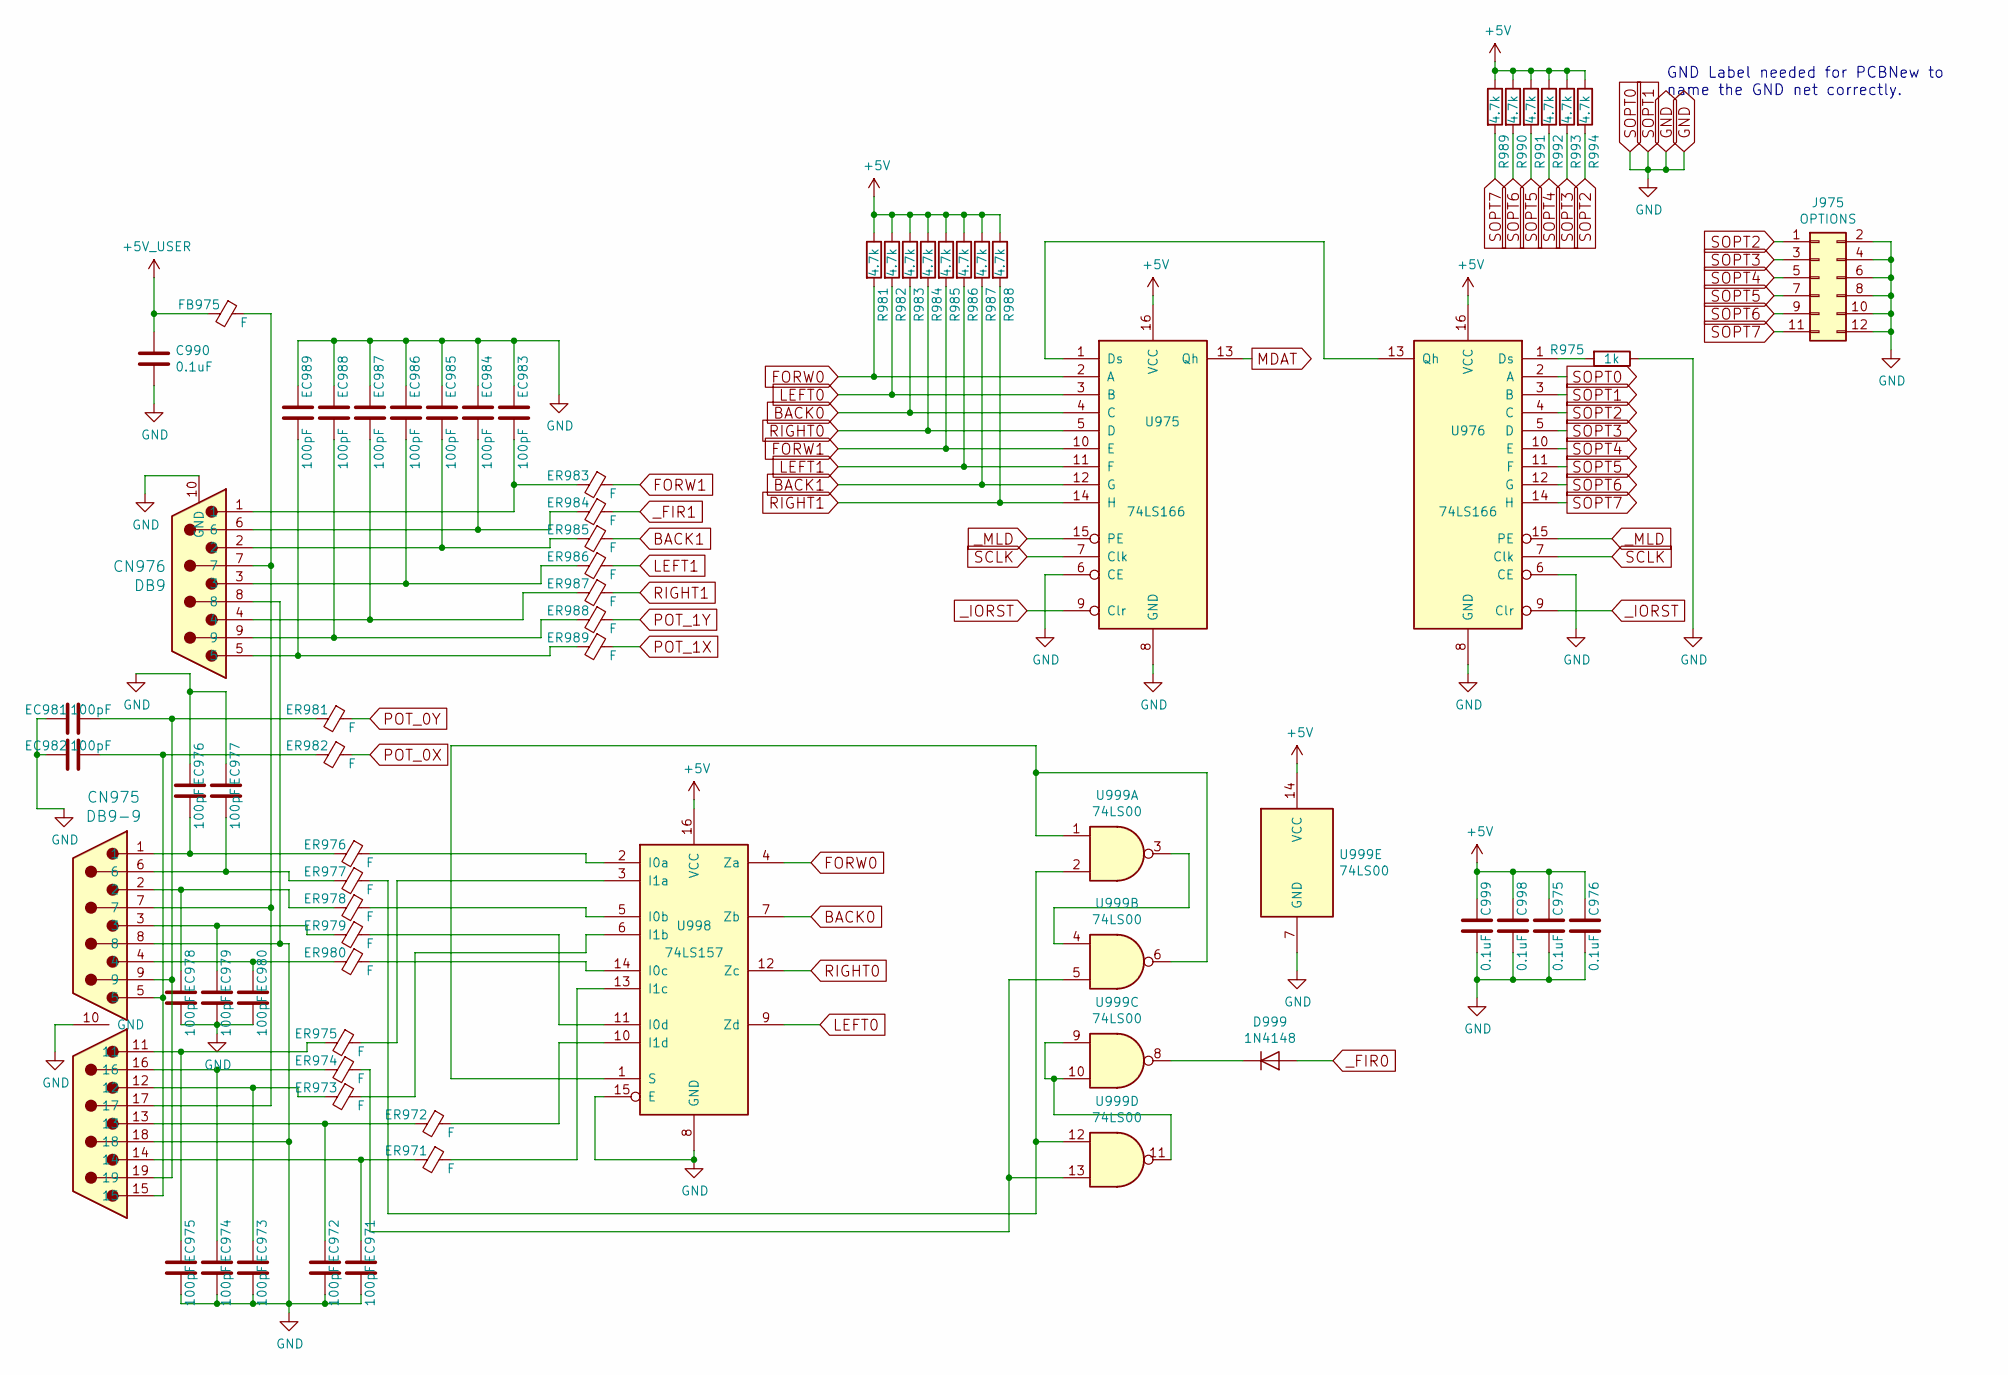
[picture p16: schematic ATX4000-P15.sch]

Parts:
C975, C976, C990, C998, C999: 0.1uF; C_0805_HandSoldering
CN975: DB9-9
CN976: DB9
D999: 1N4148; D_SOD-323_HandSoldering
EC971, EC972, EC973, EC974, EC975, EC976, EC977, EC978, EC979, EC980, EC981, EC982, EC983, EC984, EC985, EC986, EC987, EC988, EC989: 100pF; C_0805_HandSoldering
ER971, ER972, ER973, ER974, ER975, ER976, ER977, ER978, ER979, ER980, ER981, ER982, ER983, ER984, ER985, ER986, ER987, ER988, ER989: F; R_0805_HandSoldering
FB975: F; R_1206_HandSoldering
J975: OPTIONS; Pin_Header_Straight_2x06_Pitch2.54mm
R975: 1k; R_0805_HandSoldering
R981, R982, R983, R984, R985, R986, R987, R988, R989, R990, R991, R992, R993, R994: 4.7k; R_0805_HandSoldering
U975, U976: 74LS166; SOIC-16_3.9x9.9mm_Pitch1.27mm
U998: 74LS157; SOIC-16_3.9x9.9mm_Pitch1.27mm
U999: 74LS00; SOIC-14_3.9x8.7mm_Pitch1.27mm

Connections:
+5V: C975.2, C976.2, C998.2, C999.2, R981.1, R982.1, R983.1, R984.1, R985.1, R986.1, R987.1, R988.1, R989.1, R990.1, R991.1, R992.1, R993.1, R994.1, U975.16 (VCC), U976.16 (VCC), U998.16 (VCC), U999.14 (VCC); also elsewhere on the board
+5V_USER: C990.1, FB975.2; also elsewhere on the board
BACK0: R983.2, U975.4 (C), U998.7 (Zb)
BACK1: ER985.1, R987.2, U975.12 (G)
FORW0: R981.2, U975.2 (A), U998.4 (Za)
FORW1: ER983.1, R985.2, U975.10 (E)
GND: C975.1, C976.1, C990.2, C998.1, C999.1, CN975.8, CN975.10 (GND), CN975.18, CN976.8, CN976.10 (GND), EC971.1, EC972.1, EC973.1, EC974.1, EC975.1, EC976.2, EC977.2, EC978.1, EC979.1, EC980.1, EC981.2, EC982.2, EC983.2, EC984.2, EC985.2, EC986.2, EC987.2, EC988.2, EC989.2, J975.2, J975.4, J975.6, J975.8, J975.10, J975.12, R975.1, U975.6 (CE), U975.8 (GND), U976.2 (A), U976.3 (B), U976.6 (CE), U976.8 (GND), U998.8 (GND), U998.15 (E), U999.7 (GND); also elsewhere on the board
LEFT0: R982.2, U975.3 (B), U998.9 (Zd)
LEFT1: ER986.1, R986.2, U975.11 (F)
MDAT: U975.13 (Qh); also elsewhere on the board
unnamed: CN975.1, EC976.1, ER976.2
unnamed: CN975.2, EC978.2, ER978.2
unnamed: CN975.3, EC979.2, ER979.2
unnamed: CN975.4, EC980.2, ER980.2
unnamed: CN975.6, EC977.1, ER977.2
unnamed: CN975.11, EC975.2, ER975.2
unnamed: CN975.12, EC973.2, ER973.2
unnamed: CN975.13, EC972.2, ER972.2
unnamed: CN975.14, EC971.2, ER971.2
unnamed: CN975.5, CN975.15, EC982.1, ER982.2
unnamed: CN975.16, EC974.2, ER974.2
unnamed: CN975.7, CN975.17, CN976.7, FB975.1
unnamed: CN975.9, CN975.19, EC981.1, ER981.2
unnamed: CN976.1, EC983.1, ER983.2
unnamed: CN976.2, EC985.1, ER985.2
unnamed: CN976.3, EC986.1, ER986.2
unnamed: CN976.4, EC987.1, ER987.2
unnamed: CN976.5, EC989.1, ER989.2
unnamed: CN976.6, EC984.1, ER984.2
unnamed: CN976.9, EC988.1, ER988.2
unnamed: D999.1 (K), U999.8
unnamed: ER971.1, U998.13 (I1c)
unnamed: ER972.1, U998.10 (I1d)
unnamed: ER973.1, U998.6 (I1b)
unnamed: ER974.1, U999.5, U999.13
unnamed: ER975.1, U998.3 (I1a)
unnamed: ER976.1, U998.2 (I0a)
unnamed: ER977.1, U999.2, U999.12
unnamed: ER978.1, U998.5 (I0b)
unnamed: ER979.1, U998.11 (I0d)
unnamed: ER980.1, U998.14 (I0c)
unnamed: R975.2, U976.1 (Ds)
unnamed: U975.1 (Ds), U976.13 (Qh)
unnamed: U998.1 (S), U999.1, U999.6
unnamed: U999.3, U999.4
unnamed: U999.9, U999.10, U999.11
POT_0X: ER982.1; also elsewhere on the board
POT_0Y: ER981.1; also elsewhere on the board
POT_1X: ER989.1; also elsewhere on the board
POT_1Y: ER988.1; also elsewhere on the board
RIGHT0: R984.2, U975.5 (D), U998.12 (Zc)
RIGHT1: ER987.1, R988.2, U975.14 (H)
SCLK: U975.7 (Clk), U976.7 (Clk); also elsewhere on the board
SOPT2: J975.1, R994.2, U976.4 (C)
SOPT3: J975.3, R993.2, U976.5 (D)
SOPT4: J975.5, R992.2, U976.10 (E)
SOPT5: J975.7, R991.2, U976.11 (F)
SOPT6: J975.9, R990.2, U976.12 (G)
SOPT7: J975.11, R989.2, U976.14 (H)
_FIR0: D999.2 (A); also elsewhere on the board
_FIR1: ER984.1; also elsewhere on the board
_IORST: U975.9 (Clr), U976.9 (Clr); also elsewhere on the board
_MLD: U975.15 (PE), U976.15 (PE); also elsewhere on the board

Notes on the sheet:
GND Label needed for PCBNew to name the GND net correctly.

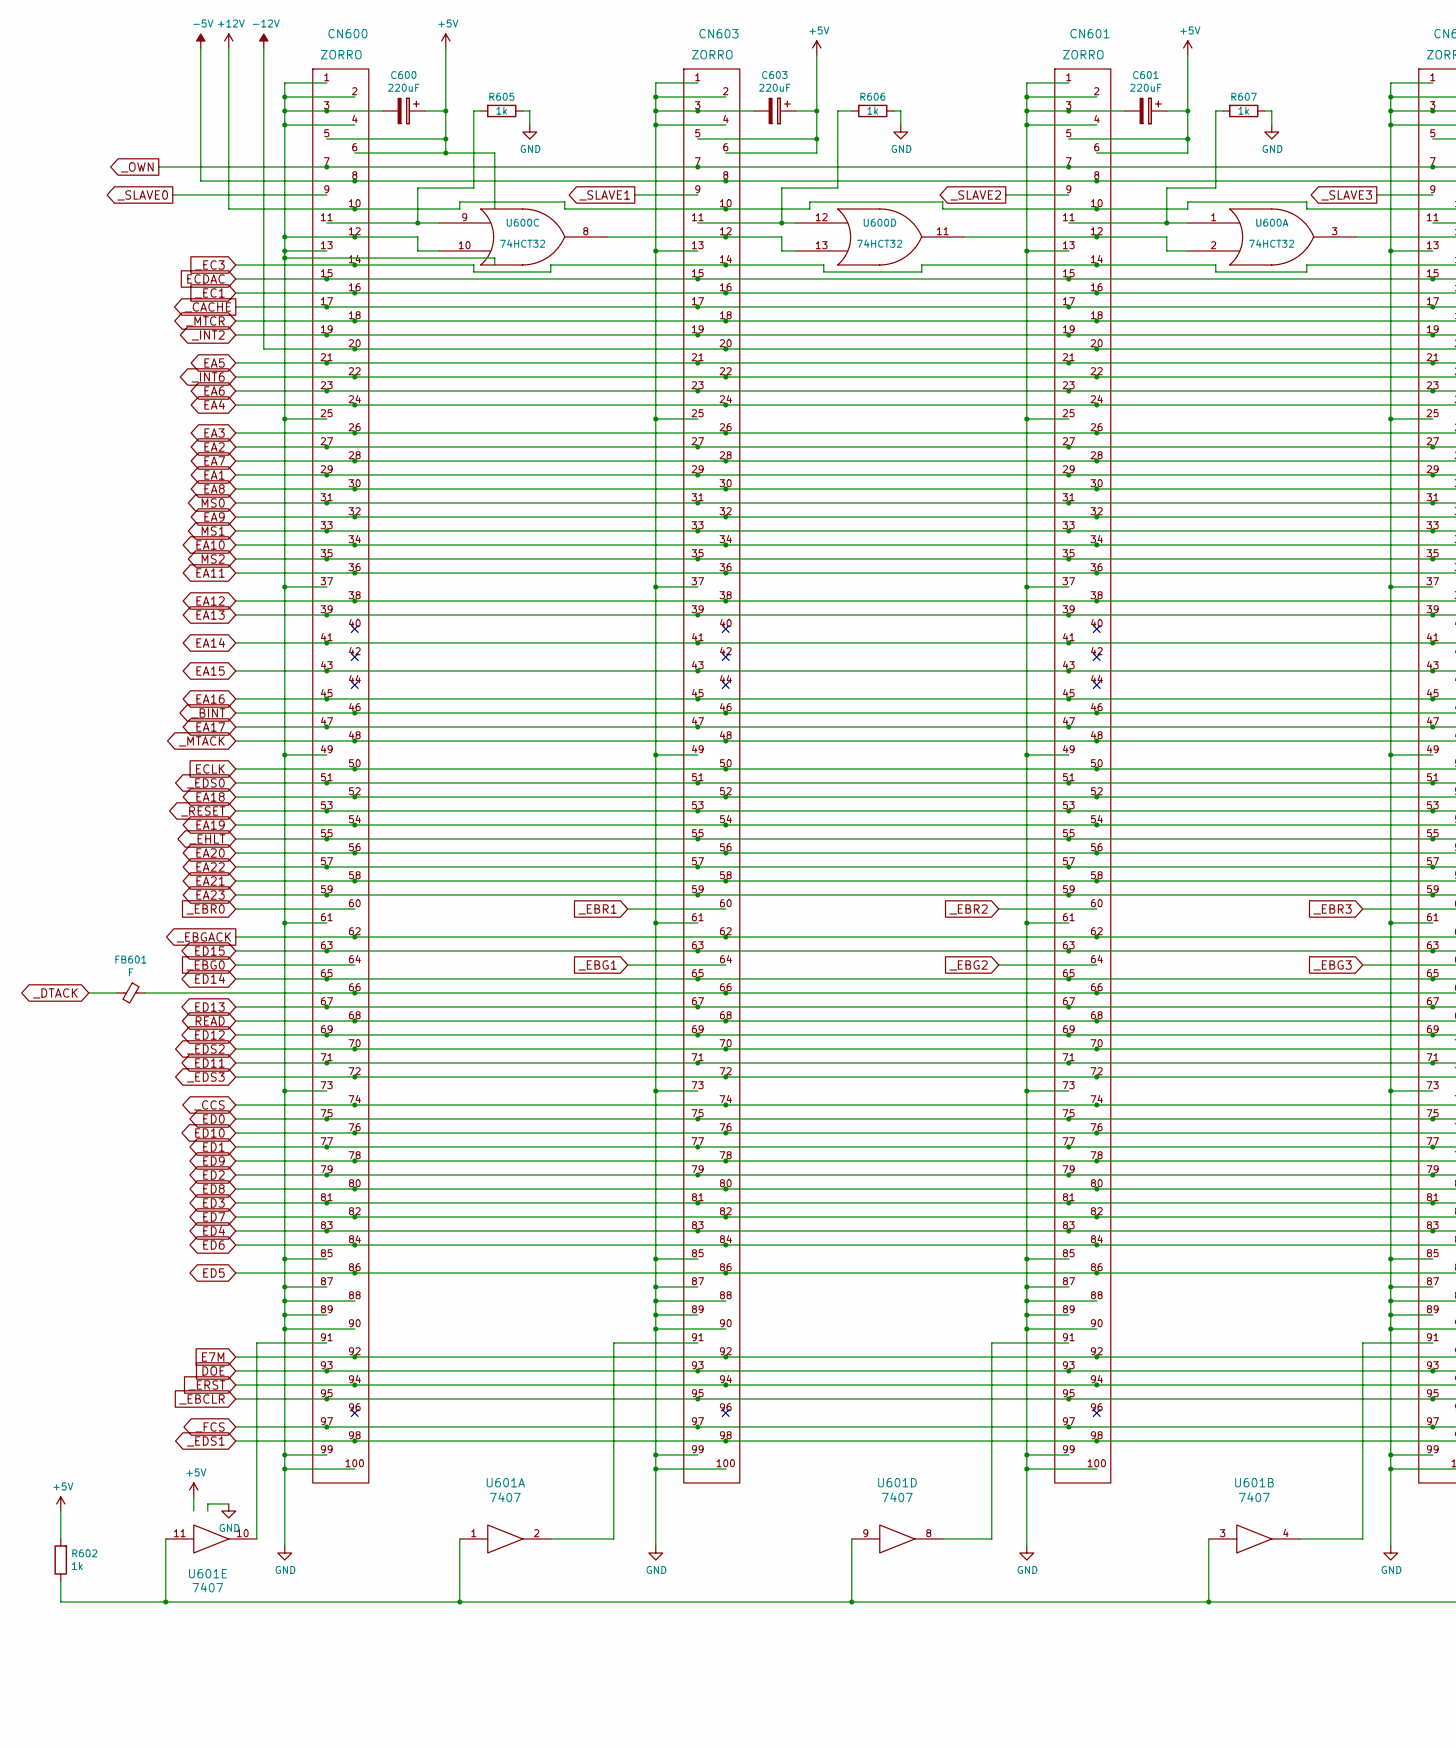
[picture p17: schematic ATX4000-P16.sch, part in row 1, column 1]

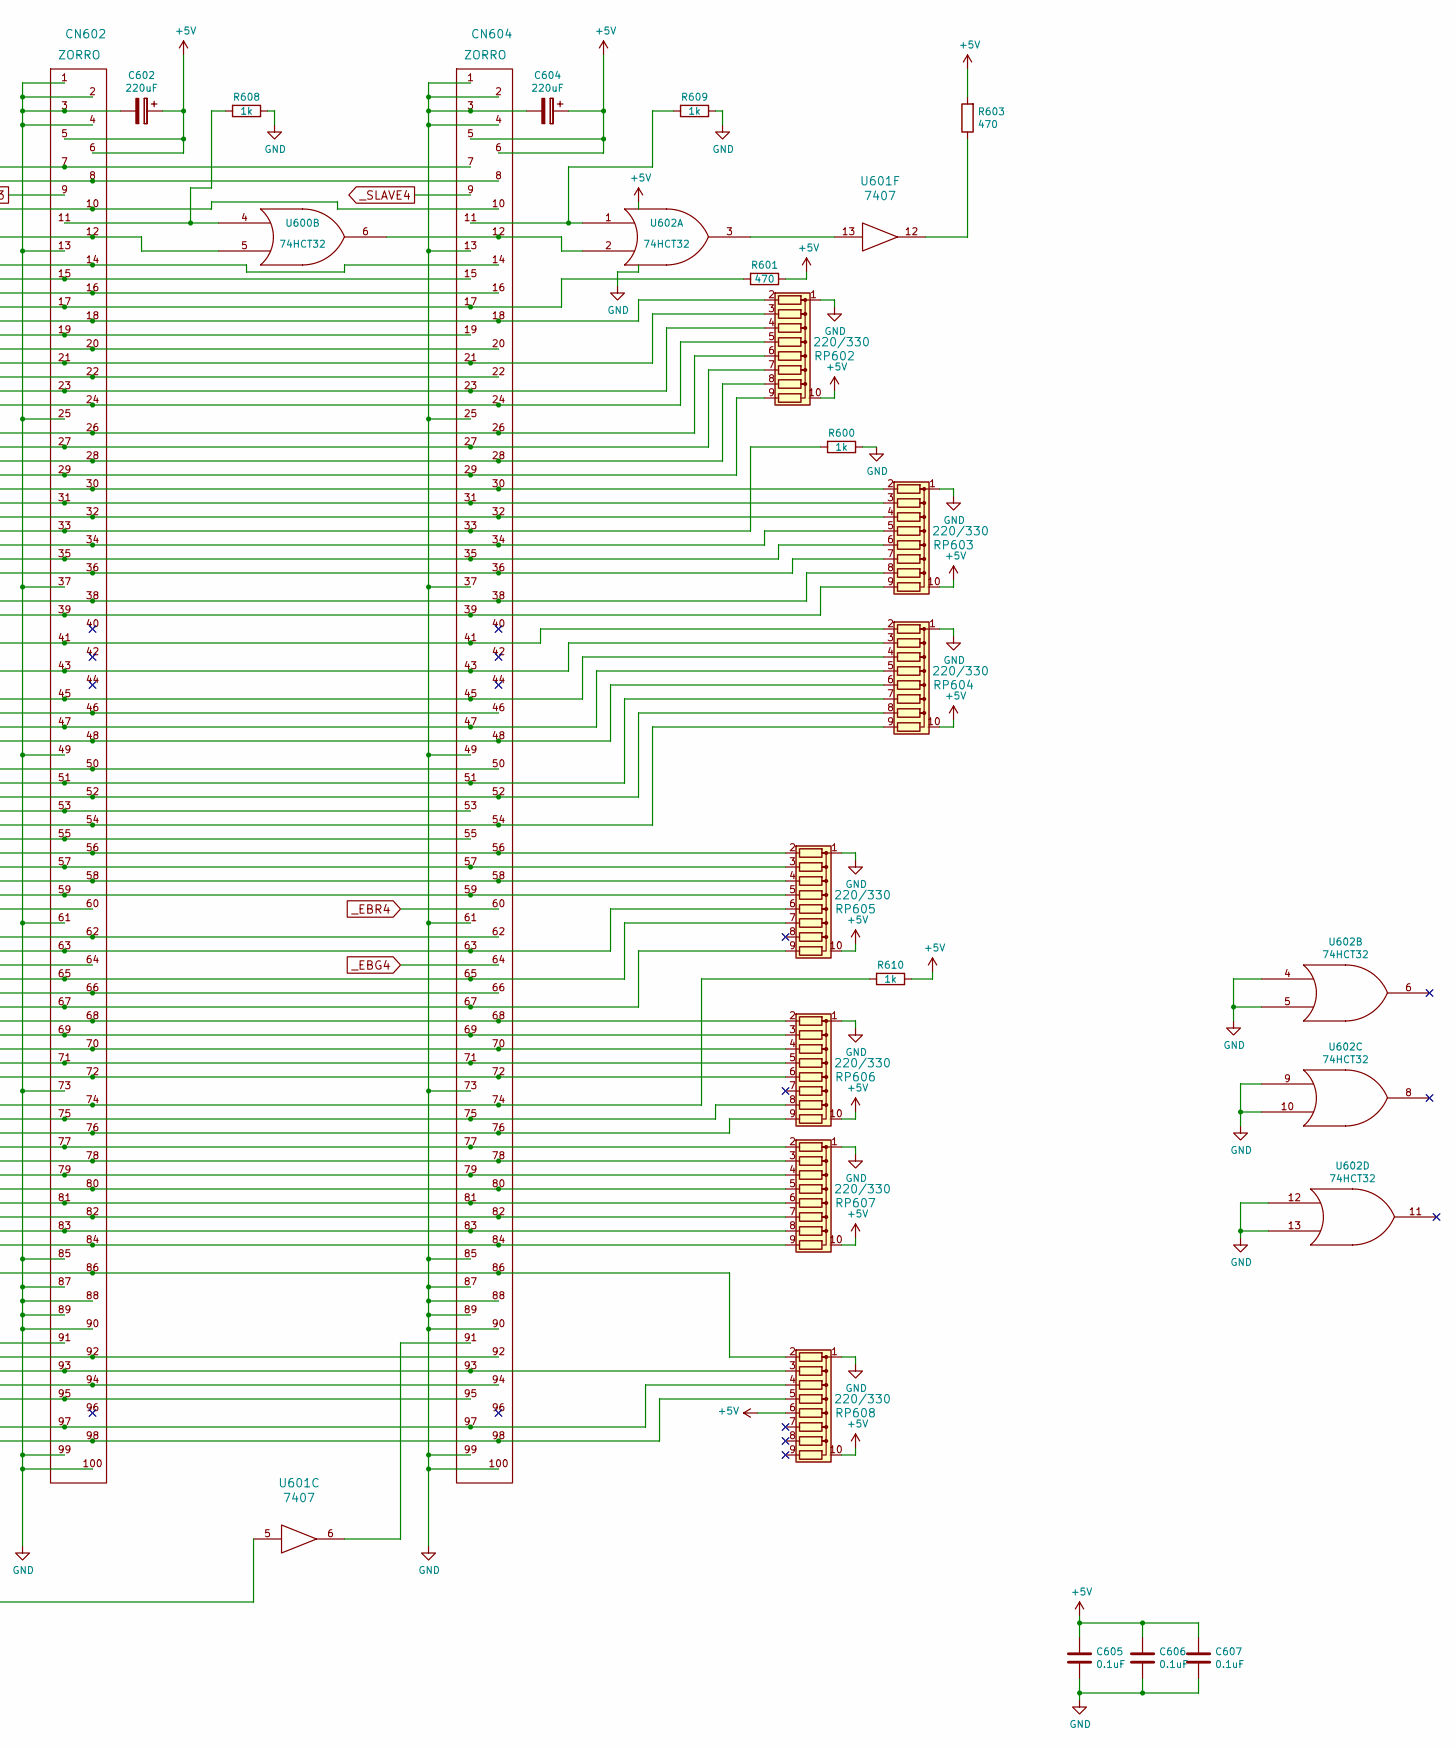
[picture p18: schematic ATX4000-P16.sch, part in row 1, column 2]

Parts:
C600, C601, C602, C603, C604: 220uF; CP_Elec_6.3x7.7
C605, C606, C607: 0.1uF; C_0805_HandSoldering
CN600, CN601, CN602, CN603, CN604: ZORRO; ZORRO Slot
FB601: F; R_0805_HandSoldering
R600, R602, R605, R606, R607, R608, R609, R610: 1k; R_0805_HandSoldering
R601, R603: 470; R_0805_HandSoldering
RP602, RP603, RP604, RP605, RP606, RP607, RP608: 220/330; R_Array_SIP10
U600, U602: 74HCT32; SOIC-14_3.9x8.7mm_Pitch1.27mm
U601: 7407; SOIC-14_3.9x8.7mm_Pitch1.27mm

Connections:
+5V: C600.1, C601.1, C602.1, C603.1, C604.1, C605.1, C606.1, C607.1, CN600.5, CN600.6, CN601.5, CN601.6, CN602.5, CN602.6, CN603.5, CN603.6, CN604.5, CN604.6, R601.1, R602.2, R603.2, R610.1, RP602.10, RP603.10, RP604.10, RP605.10, RP606.10, RP607.10, RP608.6 (R5), RP608.10, U600.14 (VCC), U601.14 (VCC), U602.14 (VCC); also elsewhere on the board
+12V: CN600.10, CN601.10, CN602.10, CN603.10, CN604.10; also elsewhere on the board
-5V: CN600.8, CN601.8, CN602.8, CN603.8, CN604.8; also elsewhere on the board
-12V: CN600.20, CN601.20, CN602.20, CN603.20, CN604.20; also elsewhere on the board
DOE: CN600.93, CN601.93, CN602.93, CN603.93, CN604.93, RP608.3 (R2); also elsewhere on the board
E7M: CN600.92, CN601.92, CN602.92, CN603.92, CN604.92; also elsewhere on the board
EA1: CN600.29, CN601.29, CN602.29, CN603.29, CN604.29, RP602.9 (R8); also elsewhere on the board
EA2: CN600.27, CN601.27, CN602.27, CN603.27, CN604.27, RP602.7 (R6); also elsewhere on the board
EA3: CN600.26, CN601.26, CN602.26, CN603.26, CN604.26, RP602.6 (R5); also elsewhere on the board
EA4: CN600.24, CN601.24, CN602.24, CN603.24, CN604.24, RP602.5 (R4); also elsewhere on the board
EA5: CN600.21, CN601.21, CN602.21, CN603.21, CN604.21, RP602.3 (R2); also elsewhere on the board
EA6: CN600.23, CN601.23, CN602.23, CN603.23, CN604.23, RP602.4 (R3); also elsewhere on the board
EA7: CN600.28, CN601.28, CN602.28, CN603.28, CN604.28, RP602.8 (R7); also elsewhere on the board
EA8: CN600.30, CN601.30, CN602.30, CN603.30, CN604.30, RP603.2 (R1); also elsewhere on the board
EA9: CN600.32, CN601.32, CN602.32, CN603.32, CN604.32, RP603.4 (R3); also elsewhere on the board
EA10: CN600.34, CN601.34, CN602.34, CN603.34, CN604.34, RP603.5 (R4); also elsewhere on the board
EA11: CN600.36, CN601.36, CN602.36, CN603.36, CN604.36, RP603.7 (R6); also elsewhere on the board
EA12: CN600.38, CN601.38, CN602.38, CN603.38, CN604.38, RP603.8 (R7); also elsewhere on the board
EA13: CN600.39, CN601.39, CN602.39, CN603.39, CN604.39, RP603.9 (R8); also elsewhere on the board
EA14: CN600.41, CN601.41, CN602.41, CN603.41, CN604.41, RP604.2 (R1); also elsewhere on the board
EA15: CN600.43, CN601.43, CN602.43, CN603.43, CN604.43, RP604.3 (R2); also elsewhere on the board
EA16: CN600.45, CN601.45, CN602.45, CN603.45, CN604.45, RP604.4 (R3); also elsewhere on the board
EA17: CN600.47, CN601.47, CN602.47, CN603.47, CN604.47, RP604.5 (R4); also elsewhere on the board
EA18: CN600.52, CN601.52, CN602.52, CN603.52, CN604.52, RP604.8 (R7); also elsewhere on the board
EA19: CN600.54, CN601.54, CN602.54, CN603.54, CN604.54, RP604.9 (R8); also elsewhere on the board
EA20: CN600.56, CN601.56, CN602.56, CN603.56, CN604.56, RP605.2 (R1); also elsewhere on the board
EA21: CN600.58, CN601.58, CN602.58, CN603.58, CN604.58, RP605.4 (R3); also elsewhere on the board
EA22: CN600.57, CN601.57, CN602.57, CN603.57, CN604.57, RP605.3 (R2); also elsewhere on the board
EA23: CN600.59, CN601.59, CN602.59, CN603.59, CN604.59, RP605.5 (R4); also elsewhere on the board
ECDAC: CN600.15, CN601.15, CN602.15, CN603.15, CN604.15; also elsewhere on the board
ECLK: CN600.50, CN601.50, CN602.50, CN603.50, CN604.50; also elsewhere on the board
ED0: CN600.75, CN601.75, CN602.75, CN603.75, CN604.75, RP606.8 (R7); also elsewhere on the board
ED1: CN600.77, CN601.77, CN602.77, CN603.77, CN604.77, RP607.2 (R1); also elsewhere on the board
ED2: CN600.79, CN601.79, CN602.79, CN603.79, CN604.79, RP607.4 (R3); also elsewhere on the board
ED3: CN600.81, CN601.81, CN602.81, CN603.81, CN604.81, RP607.6 (R5); also elsewhere on the board
ED4: CN600.83, CN601.83, CN602.83, CN603.83, CN604.83, RP607.8 (R7); also elsewhere on the board
ED5: CN600.86, CN601.86, CN602.86, CN603.86, CN604.86, RP608.2 (R1); also elsewhere on the board
ED6: CN600.84, CN601.84, CN602.84, CN603.84, CN604.84, RP607.9 (R8); also elsewhere on the board
ED7: CN600.82, CN601.82, CN602.82, CN603.82, CN604.82, RP607.7 (R6); also elsewhere on the board
ED8: CN600.80, CN601.80, CN602.80, CN603.80, CN604.80, RP607.5 (R4); also elsewhere on the board
ED9: CN600.78, CN601.78, CN602.78, CN603.78, CN604.78, RP607.3 (R2); also elsewhere on the board
ED10: CN600.76, CN601.76, CN602.76, CN603.76, CN604.76, RP606.9 (R8); also elsewhere on the board
ED11: CN600.71, CN601.71, CN602.71, CN603.71, CN604.71, RP606.5 (R4); also elsewhere on the board
ED12: CN600.69, CN601.69, CN602.69, CN603.69, CN604.69, RP606.3 (R2); also elsewhere on the board
ED13: CN600.67, CN601.67, CN602.67, CN603.67, CN604.67, RP605.9 (R8); also elsewhere on the board
ED14: CN600.65, CN601.65, CN602.65, CN603.65, CN604.65, RP605.7 (R6); also elsewhere on the board
ED15: CN600.63, CN601.63, CN602.63, CN603.63, CN604.63, RP605.6 (R5); also elsewhere on the board
GND: C600.2, C601.2, C602.2, C603.2, C604.2, C605.2, C606.2, C607.2, CN600.1, CN600.2, CN600.3, CN600.4, CN600.12, CN600.13, CN600.25, CN600.37, CN600.49, CN600.61, CN600.73, CN600.85, CN600.87, CN600.88, CN600.89, CN600.90, CN600.99, CN600.100, CN601.1, CN601.2, CN601.3, CN601.4, CN601.13, CN601.25, CN601.37, CN601.49, CN601.61, CN601.73, CN601.85, CN601.87, CN601.88, CN601.89, CN601.90, CN601.99, CN601.100, CN602.1, CN602.2, CN602.3, CN602.4, CN602.13, CN602.25, CN602.37, CN602.49, CN602.61, CN602.73, CN602.85, CN602.87, CN602.88, CN602.89, CN602.90, CN602.99, CN602.100, CN603.1, CN603.2, CN603.3, CN603.4, CN603.13, CN603.25, CN603.37, CN603.49, CN603.61, CN603.73, CN603.85, CN603.87, CN603.88, CN603.89, CN603.90, CN603.99, CN603.100, CN604.1, CN604.2, CN604.3, CN604.4, CN604.13, CN604.25, CN604.37, CN604.49, CN604.61, CN604.73, CN604.85, CN604.87, CN604.88, CN604.89, CN604.90, CN604.99, CN604.100, R600.1, R605.1, R606.1, R607.1, R608.1, R609.1, RP602.1 (common), RP603.1 (common), RP604.1 (common), RP605.1 (common), RP606.1 (common), RP607.1 (common), RP608.1 (common), U600.7 (GND), U600.10, U601.7 (GND), U602.4, U602.5, U602.7 (GND), U602.9, U602.10, U602.12, U602.13; also elsewhere on the board
MS0: CN600.31, CN601.31, CN602.31, CN603.31, CN604.31, RP603.3 (R2); also elsewhere on the board
MS1: CN600.33, CN601.33, CN602.33, CN603.33, CN604.33, R600.2; also elsewhere on the board
MS2: CN600.35, CN601.35, CN602.35, CN603.35, CN604.35, RP603.6 (R5); also elsewhere on the board
unnamed: CN600.11, R605.2, U600.9
unnamed: CN600.66, CN601.66, CN602.66, CN603.66, CN604.66, FB601.1
unnamed: CN600.91, U601.10
unnamed: CN601.11, R607.2, U600.1
unnamed: CN601.12, U600.2, U600.11
unnamed: CN601.91, U601.8
unnamed: CN602.11, R608.2, U600.4
unnamed: CN602.12, U600.3, U600.5
unnamed: CN602.91, U601.4
unnamed: CN603.11, R606.2, U600.12
unnamed: CN603.12, U600.8, U600.13
unnamed: CN603.91, U601.2
unnamed: CN604.11, R609.2, U602.1
unnamed: CN604.12, U600.6, U602.2
unnamed: CN604.91, U601.6
unnamed: R602.1, U601.1, U601.3, U601.5, U601.9, U601.11
unnamed: R603.1, U601.12
unnamed: U601.13, U602.3
READ: CN600.68, CN601.68, CN602.68, CN603.68, CN604.68, RP606.2 (R1); also elsewhere on the board
_BINT: CN600.46, CN601.46, CN602.46, CN603.46, CN604.46; also elsewhere on the board
_CACHE: CN600.17, CN601.17, CN602.17, CN603.17, CN604.17, R601.2; also elsewhere on the board
_CCS: CN600.74, CN601.74, CN602.74, CN603.74, CN604.74, R610.2; also elsewhere on the board
_DTACK: FB601.2; also elsewhere on the board
_EBCLR: CN600.95, CN601.95, CN602.95, CN603.95, CN604.95; also elsewhere on the board
_EBG0: CN600.64; also elsewhere on the board
_EBG1: CN603.64; also elsewhere on the board
_EBG2: CN601.64; also elsewhere on the board
_EBG3: CN602.64; also elsewhere on the board
_EBG4: CN604.64; also elsewhere on the board
_EBGACK: CN600.62, CN601.62, CN602.62, CN603.62, CN604.62; also elsewhere on the board
_EBR0: CN600.60; also elsewhere on the board
_EBR1: CN603.60; also elsewhere on the board
_EBR2: CN601.60; also elsewhere on the board
_EBR3: CN602.60; also elsewhere on the board
_EBR4: CN604.60; also elsewhere on the board
_EC1: CN600.16, CN601.16, CN602.16, CN603.16, CN604.16; also elsewhere on the board
_EC3: CN600.14, CN601.14, CN602.14, CN603.14, CN604.14; also elsewhere on the board
_EDS0: CN600.51, CN601.51, CN602.51, CN603.51, CN604.51, RP604.7 (R6); also elsewhere on the board
_EDS1: CN600.98, CN601.98, CN602.98, CN603.98, CN604.98, RP608.5 (R4); also elsewhere on the board
_EDS2: CN600.70, CN601.70, CN602.70, CN603.70, CN604.70, RP606.4 (R3); also elsewhere on the board
_EDS3: CN600.72, CN601.72, CN602.72, CN603.72, CN604.72, RP606.6 (R5); also elsewhere on the board
_EHLT: CN600.55, CN601.55, CN602.55, CN603.55, CN604.55; also elsewhere on the board
_ERST: CN600.94, CN601.94, CN602.94, CN603.94, CN604.94; also elsewhere on the board
_FCS: CN600.97, CN601.97, CN602.97, CN603.97, CN604.97, RP608.4 (R3); also elsewhere on the board
_INT2: CN600.19, CN601.19, CN602.19, CN603.19, CN604.19; also elsewhere on the board
_INT6: CN600.22, CN601.22, CN602.22, CN603.22, CN604.22; also elsewhere on the board
_MTACK: CN600.48, CN601.48, CN602.48, CN603.48, CN604.48, RP604.6 (R5); also elsewhere on the board
_MTCR: CN600.18, CN601.18, CN602.18, CN603.18, CN604.18, RP602.2 (R1); also elsewhere on the board
_OWN: CN600.7, CN601.7, CN602.7, CN603.7, CN604.7; also elsewhere on the board
_RESET: CN600.53, CN601.53, CN602.53, CN603.53, CN604.53; also elsewhere on the board
_SLAVE0: CN600.9; also elsewhere on the board
_SLAVE1: CN603.9; also elsewhere on the board
_SLAVE2: CN601.9; also elsewhere on the board
_SLAVE3: CN602.9; also elsewhere on the board
_SLAVE4: CN604.9; also elsewhere on the board
