elenachenchen/A4000-ATX/ATX4000.kicad_pcb

## KiCad design ATX4000.kicad_pcb (continued)

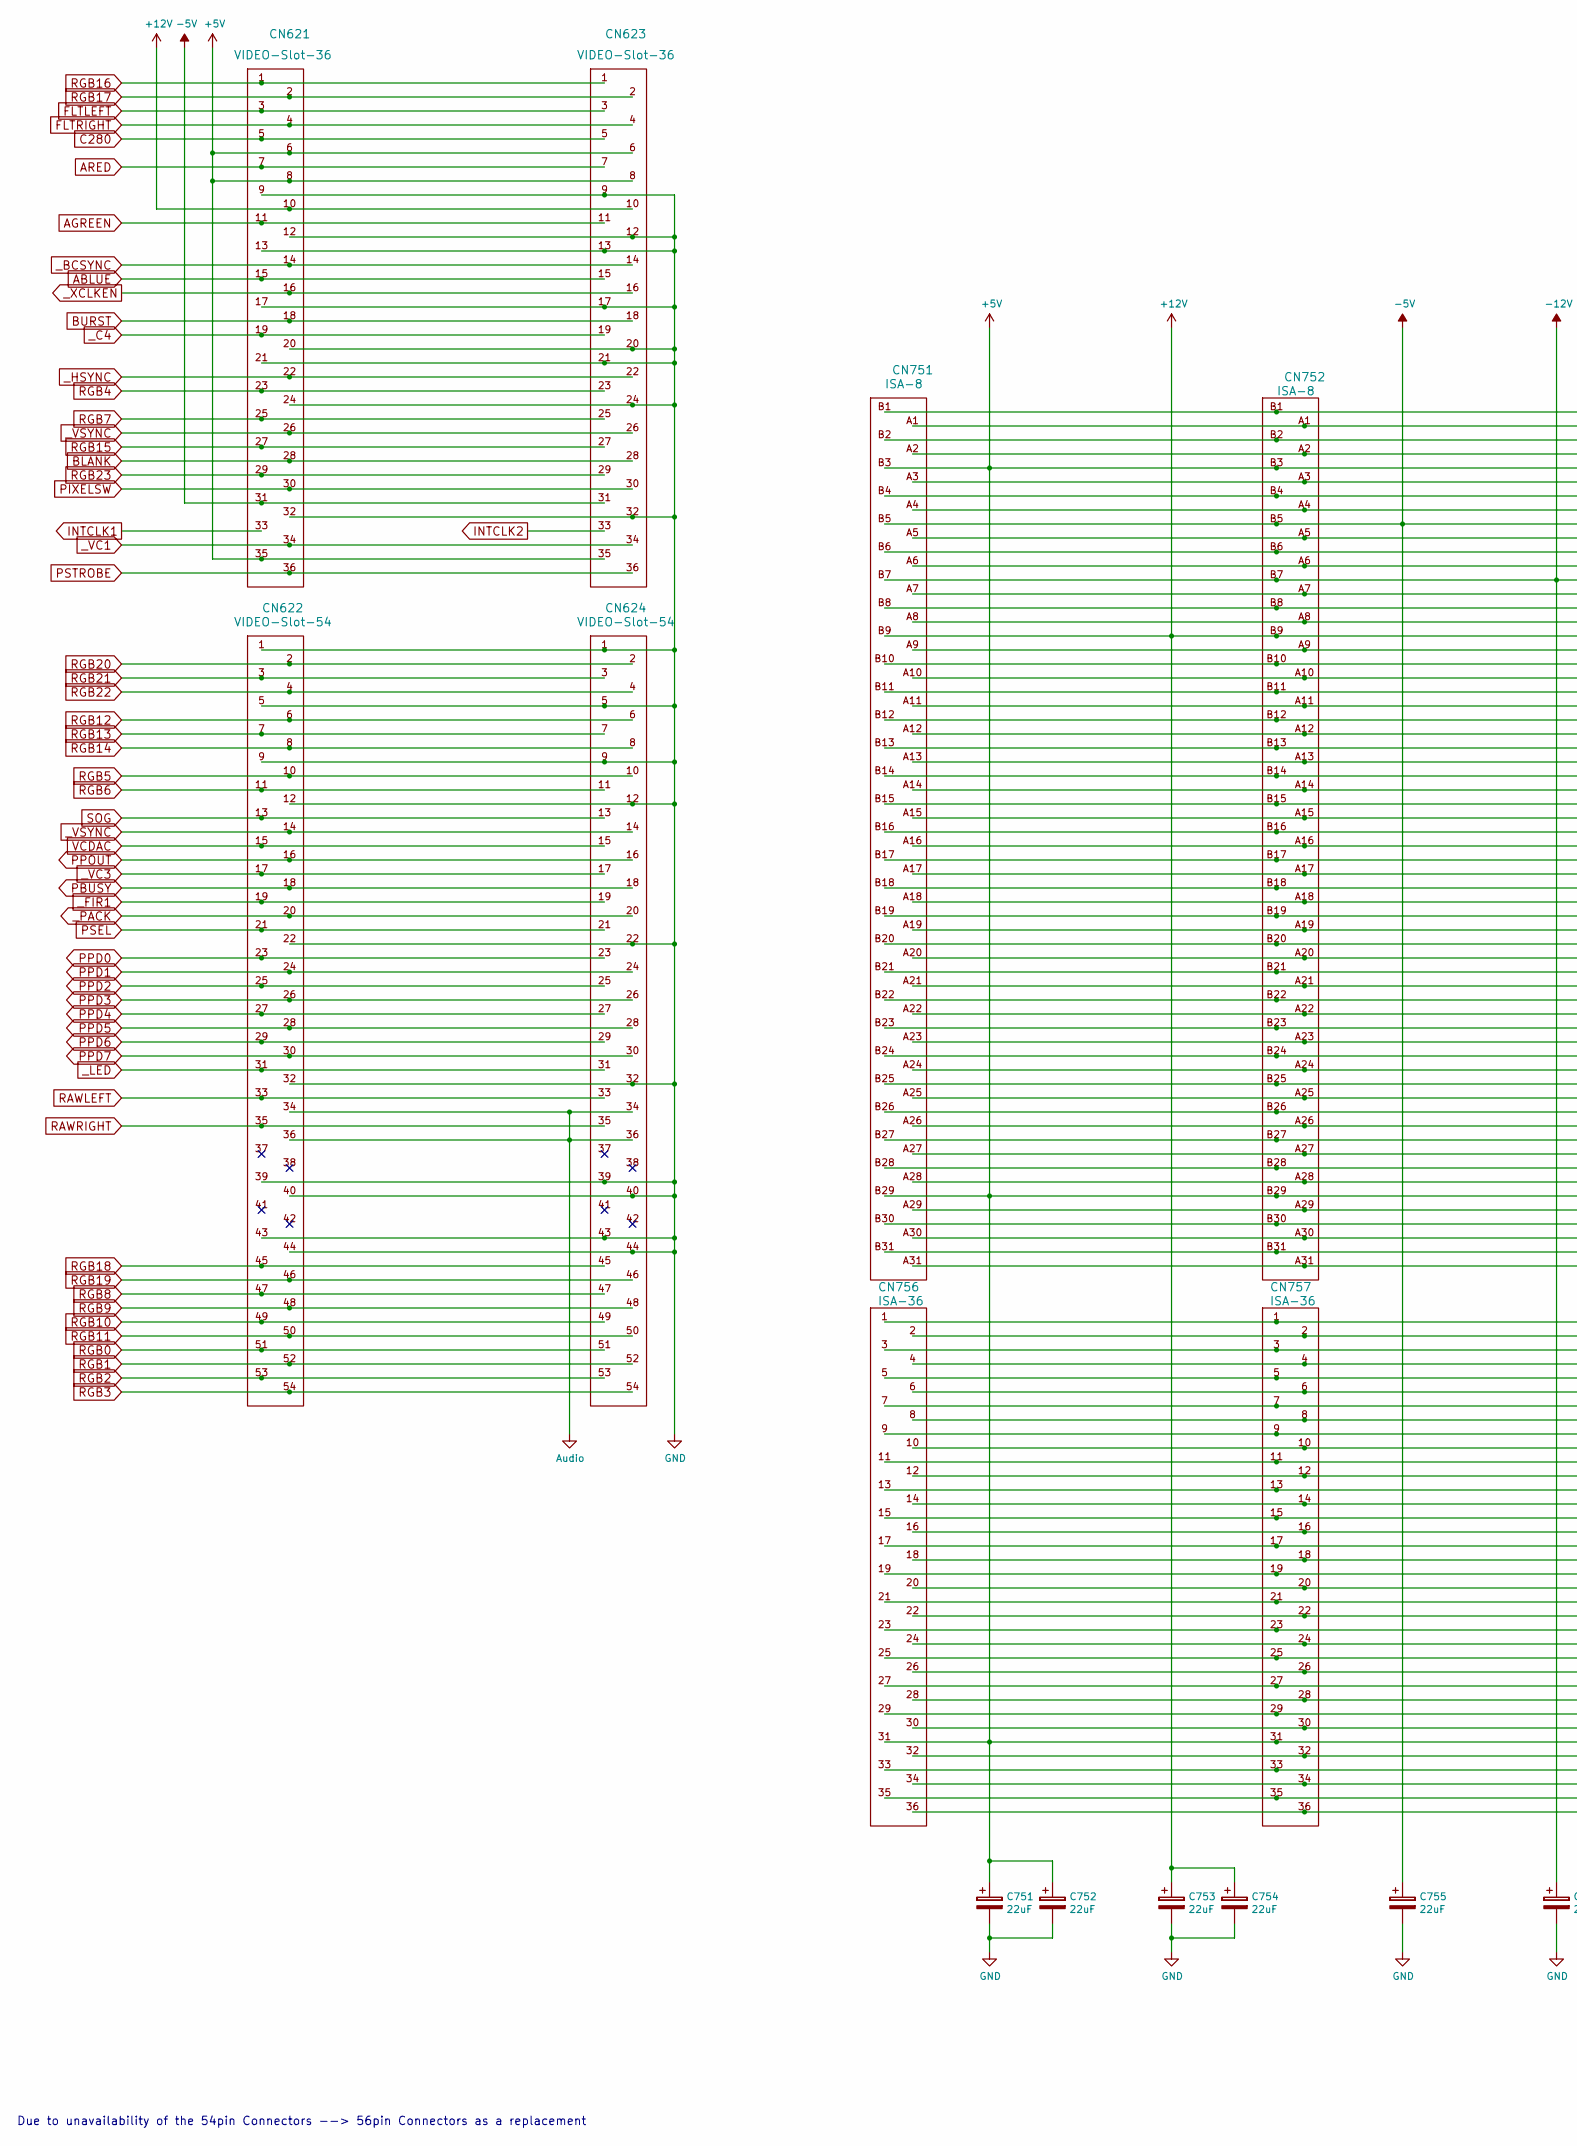
[picture p19: schematic ATX4000-P17.sch, part in row 1, column 1]

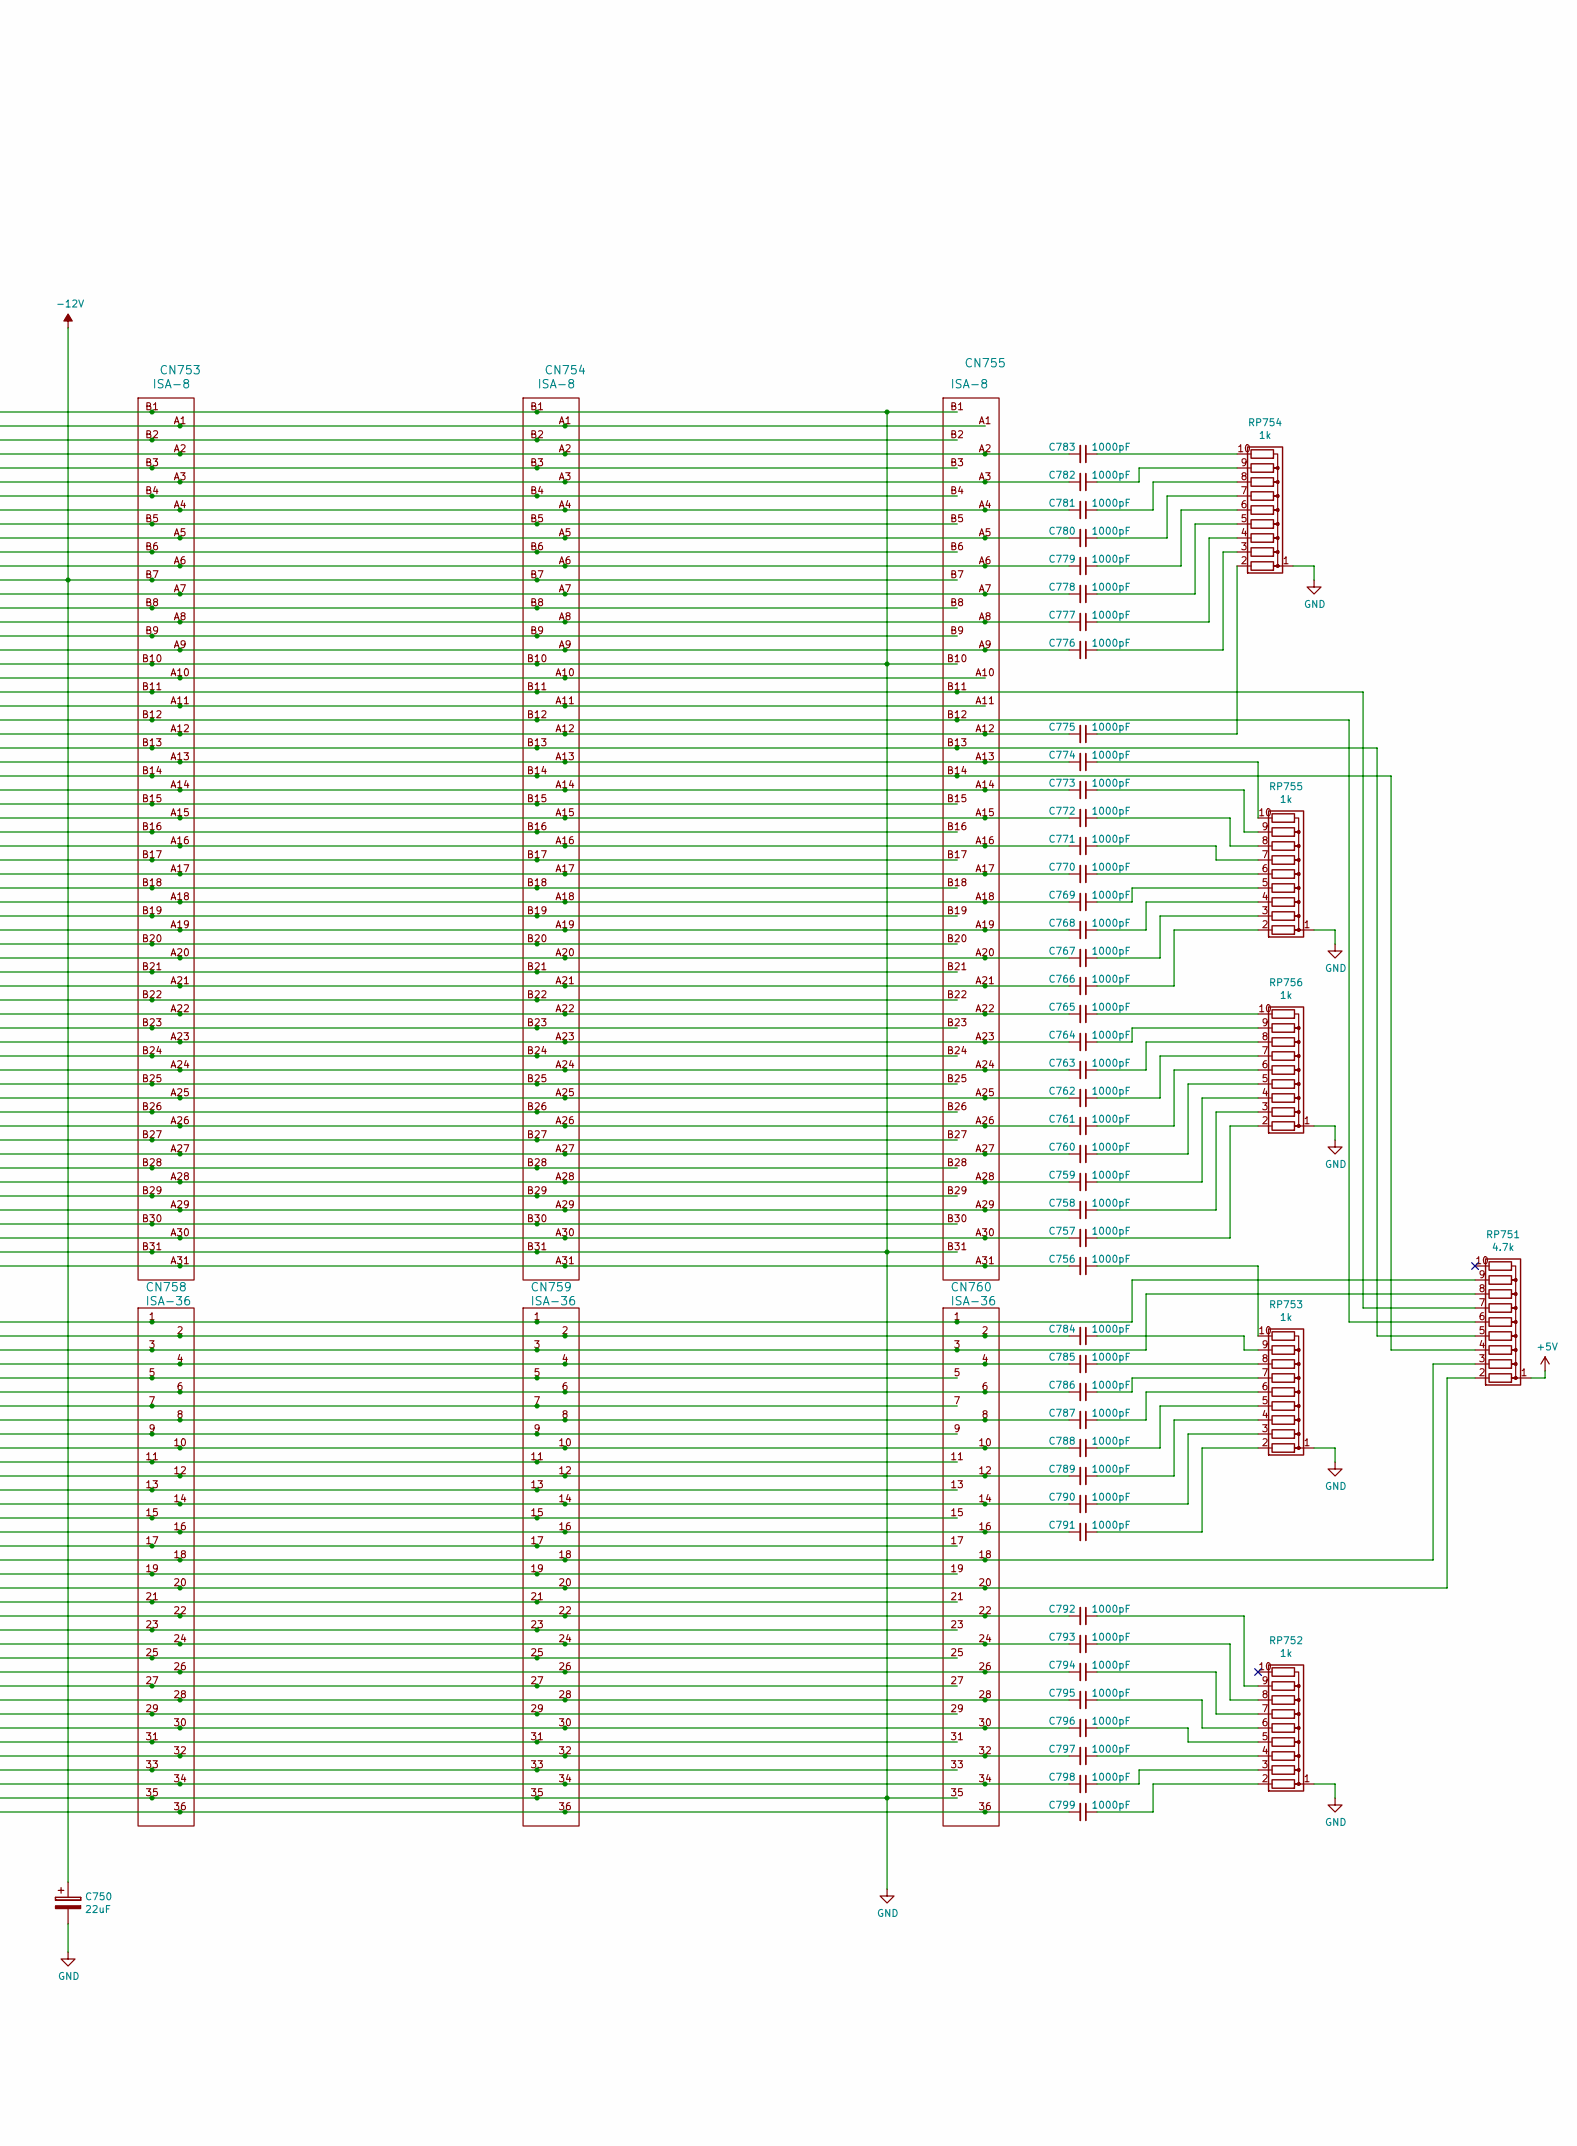
[picture p20: schematic ATX4000-P17.sch, part in row 1, column 2]

Parts:
C750, C751, C752, C753, C754, C755: 22uF; CP_Elec_6.3x5.8
C756, C757, C758, C759, C760, C761, C762, C763, C764, C765, C766, C767, C768, C769, C770, C771, C772, C773, C774, C775, C776, C777, C778, C779, C780, C781, C782, C783, C784, C785, C786, C787, C788, C789, C790, C791, C792, C793, C794, C795, C796, C797, C798, C799: 1000pF; C_0805_HandSoldering
CN621, CN623: VIDEO-Slot-36
CN622, CN624: VIDEO-Slot-54
CN751, CN752, CN753, CN754, CN755: ISA-8
CN756, CN757, CN758, CN759, CN760: ISA-36; VIDEO-Slot-36
RP751: 4.7k; R_Array_SIP10
RP752, RP753, RP754, RP755, RP756: 1k; R_Array_SIP10

Connections:
+5V: C751.1, C752.1, CN621.6, CN621.8, CN621.35, CN623.6, CN623.8, CN623.35, CN751.B3, CN751.B29, CN752.B3, CN752.B29, CN753.B3, CN753.B29, CN754.B3, CN754.B29, CN755.B3, CN755.B29, CN756.31, CN757.31, CN758.31, CN759.31, CN760.31, RP751.1 (common); also elsewhere on the board
+12V: C753.1, C754.1, CN621.10, CN623.10, CN751.B9, CN752.B9, CN753.B9, CN754.B9, CN755.B9; also elsewhere on the board
-5V: C755.1, CN621.31, CN623.31, CN751.B5, CN752.B5, CN753.B5, CN754.B5, CN755.B5; also elsewhere on the board
-12V: C750.1, CN751.B7, CN752.B7, CN753.B7, CN754.B7, CN755.B7; also elsewhere on the board
ABLUE: CN621.15, CN623.15; also elsewhere on the board
AGREEN: CN621.11, CN623.11; also elsewhere on the board
ARED: CN621.7, CN623.7; also elsewhere on the board
Audio: CN622.34, CN622.36, CN624.34, CN624.36; also elsewhere on the board
BLANK: CN621.28, CN623.28; also elsewhere on the board
BURST: CN621.18, CN623.18; also elsewhere on the board
C280: CN621.5, CN623.5; also elsewhere on the board
FLTLEFT: CN621.3, CN623.3; also elsewhere on the board
FLTRIGHT: CN621.4, CN623.4; also elsewhere on the board
GND: C750.2, C751.2, C752.2, C753.2, C754.2, C755.2, CN621.9, CN621.12, CN621.13, CN621.17, CN621.20, CN621.21, CN621.24, CN621.32, CN622.1, CN622.5, CN622.9, CN622.12, CN622.22, CN622.32, CN622.39, CN622.40, CN622.43, CN622.44, CN623.9, CN623.12, CN623.13, CN623.17, CN623.20, CN623.21, CN623.24, CN623.32, CN624.1, CN624.5, CN624.9, CN624.12, CN624.22, CN624.32, CN624.39, CN624.40, CN624.43, CN624.44, CN751.B1, CN751.B10, CN751.B31, CN752.B1, CN752.B10, CN752.B31, CN753.B1, CN753.B10, CN753.B31, CN754.B1, CN754.B10, CN754.B31, CN755.B1, CN755.B10, CN755.B31, CN756.35, CN757.35, CN758.35, CN759.35, CN760.35, RP752.1 (common), RP753.1 (common), RP754.1 (common), RP755.1 (common), RP756.1 (common); also elsewhere on the board
INTCLK1: CN621.33; also elsewhere on the board
INTCLK2: CN623.33; also elsewhere on the board
unnamed: C756.1, RP753.10 (R9)
unnamed: C756.2, CN751.A31, CN752.A31, CN753.A31, CN754.A31, CN755.A31
unnamed: C757.1, RP756.2 (R1)
unnamed: C757.2, CN751.A30, CN752.A30, CN753.A30, CN754.A30, CN755.A30
unnamed: C758.1, RP756.3 (R2)
unnamed: C758.2, CN751.A29, CN752.A29, CN753.A29, CN754.A29, CN755.A29
unnamed: C759.1, RP756.4 (R3)
unnamed: C759.2, CN751.A28, CN752.A28, CN753.A28, CN754.A28, CN755.A28
unnamed: C760.1, RP756.5 (R4)
unnamed: C760.2, CN751.A27, CN752.A27, CN753.A27, CN754.A27, CN755.A27
unnamed: C761.1, RP756.6 (R5)
unnamed: C761.2, CN751.A26, CN752.A26, CN753.A26, CN754.A26, CN755.A26
unnamed: C762.1, RP756.7 (R6)
unnamed: C762.2, CN751.A25, CN752.A25, CN753.A25, CN754.A25, CN755.A25
unnamed: C763.1, RP756.8 (R7)
unnamed: C763.2, CN751.A24, CN752.A24, CN753.A24, CN754.A24, CN755.A24
unnamed: C764.1, RP756.9 (R8)
unnamed: C764.2, CN751.A23, CN752.A23, CN753.A23, CN754.A23, CN755.A23
unnamed: C765.1, RP756.10 (R9)
unnamed: C765.2, CN751.A22, CN752.A22, CN753.A22, CN754.A22, CN755.A22
unnamed: C766.1, RP755.2 (R1)
unnamed: C766.2, CN751.A21, CN752.A21, CN753.A21, CN754.A21, CN755.A21
unnamed: C767.1, RP755.3 (R2)
unnamed: C767.2, CN751.A20, CN752.A20, CN753.A20, CN754.A20, CN755.A20
unnamed: C768.1, RP755.4 (R3)
unnamed: C768.2, CN751.A19, CN752.A19, CN753.A19, CN754.A19, CN755.A19
unnamed: C769.1, RP755.5 (R4)
unnamed: C769.2, CN751.A18, CN752.A18, CN753.A18, CN754.A18, CN755.A18
unnamed: C770.1, RP755.6 (R5)
unnamed: C770.2, CN751.A17, CN752.A17, CN753.A17, CN754.A17, CN755.A17
unnamed: C771.1, RP755.7 (R6)
unnamed: C771.2, CN751.A16, CN752.A16, CN753.A16, CN754.A16, CN755.A16
unnamed: C772.1, RP755.8 (R7)
unnamed: C772.2, CN751.A15, CN752.A15, CN753.A15, CN754.A15, CN755.A15
unnamed: C773.1, RP755.9 (R8)
unnamed: C773.2, CN751.A14, CN752.A14, CN753.A14, CN754.A14, CN755.A14
unnamed: C774.1, RP755.10 (R9)
unnamed: C774.2, CN751.A13, CN752.A13, CN753.A13, CN754.A13, CN755.A13
unnamed: C775.1, RP754.2 (R1)
unnamed: C775.2, CN751.A12, CN752.A12, CN753.A12, CN754.A12, CN755.A12
unnamed: C776.1, RP754.3 (R2)
unnamed: C776.2, CN751.A9, CN752.A9, CN753.A9, CN754.A9, CN755.A9
unnamed: C777.1, RP754.4 (R3)
unnamed: C777.2, CN751.A8, CN752.A8, CN753.A8, CN754.A8, CN755.A8
unnamed: C778.1, RP754.5 (R4)
unnamed: C778.2, CN751.A7, CN752.A7, CN753.A7, CN754.A7, CN755.A7
unnamed: C779.1, RP754.6 (R5)
unnamed: C779.2, CN751.A6, CN752.A6, CN753.A6, CN754.A6, CN755.A6
unnamed: C780.1, RP754.7 (R6)
unnamed: C780.2, CN751.A5, CN752.A5, CN753.A5, CN754.A5, CN755.A5
unnamed: C781.1, RP754.8 (R7)
unnamed: C781.2, CN751.A4, CN752.A4, CN753.A4, CN754.A4, CN755.A4
unnamed: C782.1, RP754.9 (R8)
unnamed: C782.2, CN751.A3, CN752.A3, CN753.A3, CN754.A3, CN755.A3
unnamed: C783.1, RP754.10 (R9)
unnamed: C783.2, CN751.A2, CN752.A2, CN753.A2, CN754.A2, CN755.A2
unnamed: C784.1, RP753.9 (R8)
unnamed: C784.2, CN756.2, CN757.2, CN758.2, CN759.2, CN760.2
unnamed: C785.1, RP753.8 (R7)
unnamed: C785.2, CN756.4, CN757.4, CN758.4, CN759.4, CN760.4
unnamed: C786.1, RP753.7 (R6)
unnamed: C786.2, CN756.6, CN757.6, CN758.6, CN759.6, CN760.6
unnamed: C787.1, RP753.6 (R5)
unnamed: C787.2, CN756.8, CN757.8, CN758.8, CN759.8, CN760.8
unnamed: C788.1, RP753.5 (R4)
unnamed: C788.2, CN756.10, CN757.10, CN758.10, CN759.10, CN760.10
unnamed: C789.1, RP753.4 (R3)
unnamed: C789.2, CN756.12, CN757.12, CN758.12, CN759.12, CN760.12
unnamed: C790.1, RP753.3 (R2)
unnamed: C790.2, CN756.14, CN757.14, CN758.14, CN759.14, CN760.14
unnamed: C791.1, RP753.2 (R1)
unnamed: C791.2, CN756.16, CN757.16, CN758.16, CN759.16, CN760.16
unnamed: C792.1, RP752.9 (R8)
unnamed: C792.2, CN756.22, CN757.22, CN758.22, CN759.22, CN760.22
unnamed: C793.1, RP752.8 (R7)
unnamed: C793.2, CN756.24, CN757.24, CN758.24, CN759.24, CN760.24
unnamed: C794.1, RP752.7 (R6)
unnamed: C794.2, CN756.26, CN757.26, CN758.26, CN759.26, CN760.26
unnamed: C795.1, RP752.6 (R5)
unnamed: C795.2, CN756.28, CN757.28, CN758.28, CN759.28, CN760.28
unnamed: C796.1, RP752.5 (R4)
unnamed: C796.2, CN756.30, CN757.30, CN758.30, CN759.30, CN760.30
unnamed: C797.1, RP752.4 (R3)
unnamed: C797.2, CN756.32, CN757.32, CN758.32, CN759.32, CN760.32
unnamed: C798.1, RP752.3 (R2)
unnamed: C798.2, CN756.34, CN757.34, CN758.34, CN759.34, CN760.34
unnamed: C799.1, RP752.2 (R1)
unnamed: C799.2, CN756.36, CN757.36, CN758.36, CN759.36, CN760.36
unnamed: CN751.A1, CN752.A1, CN753.A1, CN754.A1, CN755.A1
unnamed: CN751.A10, CN752.A10, CN753.A10, CN754.A10, CN755.A10
unnamed: CN751.A11, CN752.A11, CN753.A11, CN754.A11, CN755.A11
unnamed: CN751.B2, CN752.B2, CN753.B2, CN754.B2, CN755.B2
unnamed: CN751.B4, CN752.B4, CN753.B4, CN754.B4, CN755.B4
unnamed: CN751.B6, CN752.B6, CN753.B6, CN754.B6, CN755.B6
unnamed: CN751.B8, CN752.B8, CN753.B8, CN754.B8, CN755.B8
unnamed: CN751.B11, CN752.B11, CN753.B11, CN754.B11, CN755.B11, RP751.7 (R6)
unnamed: CN751.B12, CN752.B12, CN753.B12, CN754.B12, CN755.B12, RP751.6 (R5)
unnamed: CN751.B13, CN752.B13, CN753.B13, CN754.B13, CN755.B13, RP751.5 (R4)
unnamed: CN751.B14, CN752.B14, CN753.B14, CN754.B14, CN755.B14, RP751.4 (R3)
unnamed: CN751.B15, CN752.B15, CN753.B15, CN754.B15, CN755.B15
unnamed: CN751.B16, CN752.B16, CN753.B16, CN754.B16, CN755.B16
unnamed: CN751.B17, CN752.B17, CN753.B17, CN754.B17, CN755.B17
unnamed: CN751.B18, CN752.B18, CN753.B18, CN754.B18, CN755.B18
unnamed: CN751.B19, CN752.B19, CN753.B19, CN754.B19, CN755.B19
unnamed: CN751.B20, CN752.B20, CN753.B20, CN754.B20, CN755.B20
unnamed: CN751.B21, CN752.B21, CN753.B21, CN754.B21, CN755.B21
unnamed: CN751.B22, CN752.B22, CN753.B22, CN754.B22, CN755.B22
unnamed: CN751.B23, CN752.B23, CN753.B23, CN754.B23, CN755.B23
unnamed: CN751.B24, CN752.B24, CN753.B24, CN754.B24, CN755.B24
unnamed: CN751.B25, CN752.B25, CN753.B25, CN754.B25, CN755.B25
unnamed: CN751.B26, CN752.B26, CN753.B26, CN754.B26, CN755.B26
unnamed: CN751.B27, CN752.B27, CN753.B27, CN754.B27, CN755.B27
unnamed: CN751.B28, CN752.B28, CN753.B28, CN754.B28, CN755.B28
unnamed: CN751.B30, CN752.B30, CN753.B30, CN754.B30, CN755.B30
unnamed: CN756.1, CN757.1, CN758.1, CN759.1, CN760.1, RP751.9 (R8)
unnamed: CN756.3, CN757.3, CN758.3, CN759.3, CN760.3, RP751.8 (R7)
unnamed: CN756.5, CN757.5, CN758.5, CN759.5, CN760.5
unnamed: CN756.7, CN757.7, CN758.7, CN759.7, CN760.7
unnamed: CN756.9, CN757.9, CN758.9, CN759.9, CN760.9
unnamed: CN756.11, CN757.11, CN758.11, CN759.11, CN760.11
unnamed: CN756.13, CN757.13, CN758.13, CN759.13, CN760.13
unnamed: CN756.15, CN757.15, CN758.15, CN759.15, CN760.15
unnamed: CN756.17, CN757.17, CN758.17, CN759.17, CN760.17
unnamed: CN756.18, CN757.18, CN758.18, CN759.18, CN760.18, RP751.3 (R2)
unnamed: CN756.19, CN757.19, CN758.19, CN759.19, CN760.19
unnamed: CN756.20, CN757.20, CN758.20, CN759.20, CN760.20, RP751.2 (R1)
unnamed: CN756.21, CN757.21, CN758.21, CN759.21, CN760.21
unnamed: CN756.23, CN757.23, CN758.23, CN759.23, CN760.23
unnamed: CN756.25, CN757.25, CN758.25, CN759.25, CN760.25
unnamed: CN756.27, CN757.27, CN758.27, CN759.27, CN760.27
unnamed: CN756.29, CN757.29, CN758.29, CN759.29, CN760.29
unnamed: CN756.33, CN757.33, CN758.33, CN759.33, CN760.33
PBUSY: CN622.18, CN624.18; also elsewhere on the board
PIXELSW: CN621.30, CN623.30; also elsewhere on the board
PPD0: CN622.23, CN624.23; also elsewhere on the board
PPD1: CN622.24, CN624.24; also elsewhere on the board
PPD2: CN622.25, CN624.25; also elsewhere on the board
PPD3: CN622.26, CN624.26; also elsewhere on the board
PPD4: CN622.27, CN624.27; also elsewhere on the board
PPD5: CN622.28, CN624.28; also elsewhere on the board
PPD6: CN622.29, CN624.29; also elsewhere on the board
PPD7: CN622.30, CN624.30; also elsewhere on the board
PPOUT: CN622.16, CN624.16; also elsewhere on the board
PSEL: CN622.21, CN624.21; also elsewhere on the board
PSTROBE: CN621.36, CN623.36; also elsewhere on the board
RAWLEFT: CN622.33, CN624.33; also elsewhere on the board
RAWRIGHT: CN622.35, CN624.35; also elsewhere on the board
RGB0: CN622.51, CN624.51; also elsewhere on the board
RGB1: CN622.52, CN624.52; also elsewhere on the board
RGB2: CN622.53, CN624.53; also elsewhere on the board
RGB3: CN622.54, CN624.54; also elsewhere on the board
RGB4: CN621.23, CN623.23; also elsewhere on the board
RGB5: CN622.10, CN624.10; also elsewhere on the board
RGB6: CN622.11, CN624.11; also elsewhere on the board
RGB7: CN621.25, CN623.25; also elsewhere on the board
RGB8: CN622.47, CN624.47; also elsewhere on the board
RGB9: CN622.48, CN624.48; also elsewhere on the board
RGB10: CN622.49, CN624.49; also elsewhere on the board
RGB11: CN622.50, CN624.50; also elsewhere on the board
RGB12: CN622.6, CN624.6; also elsewhere on the board
RGB13: CN622.7, CN624.7; also elsewhere on the board
RGB14: CN622.8, CN624.8; also elsewhere on the board
RGB15: CN621.27, CN623.27; also elsewhere on the board
RGB16: CN621.1, CN623.1; also elsewhere on the board
RGB17: CN621.2, CN623.2; also elsewhere on the board
RGB18: CN622.45, CN624.45; also elsewhere on the board
RGB19: CN622.46, CN624.46; also elsewhere on the board
RGB20: CN622.2, CN624.2; also elsewhere on the board
RGB21: CN622.3, CN624.3; also elsewhere on the board
RGB22: CN622.4, CN624.4; also elsewhere on the board
RGB23: CN621.29, CN623.29; also elsewhere on the board
SOG: CN622.13, CN624.13; also elsewhere on the board
VCDAC: CN622.15, CN624.15; also elsewhere on the board
_BCSYNC: CN621.14, CN623.14; also elsewhere on the board
_C4: CN621.19, CN623.19; also elsewhere on the board
_FIR1: CN622.19, CN624.19; also elsewhere on the board
_HSYNC: CN621.22, CN623.22; also elsewhere on the board
_LED: CN622.31, CN624.31; also elsewhere on the board
_PACK: CN622.20, CN624.20; also elsewhere on the board
_VC1: CN621.34, CN623.34; also elsewhere on the board
_VC3: CN622.17, CN624.17; also elsewhere on the board
_VSYNC: CN621.26, CN622.14, CN623.26, CN624.14; also elsewhere on the board
_XCLKEN: CN621.16, CN623.16; also elsewhere on the board

Notes on the sheet:
Due to unavailability of the 54pin Connectors --> 56pin Connectors as a replacement

Board: 4 copper layers, 816 parts (71 on the bottom side), 1001 nets, no tracks yet.
